ericboxer/KiCad---BoxLib/readme_assests/pinLabelExample.png

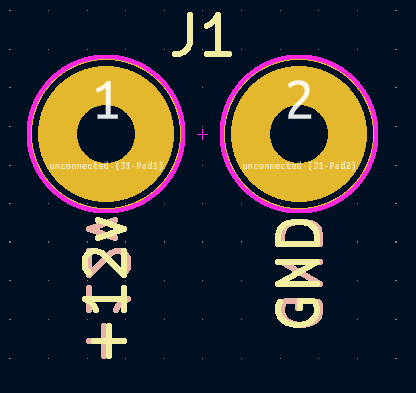
readme_assests/pinLabelExample.png
