ericboxer/KiCad---BoxLib/readme_assests/symbolLabelExample.png

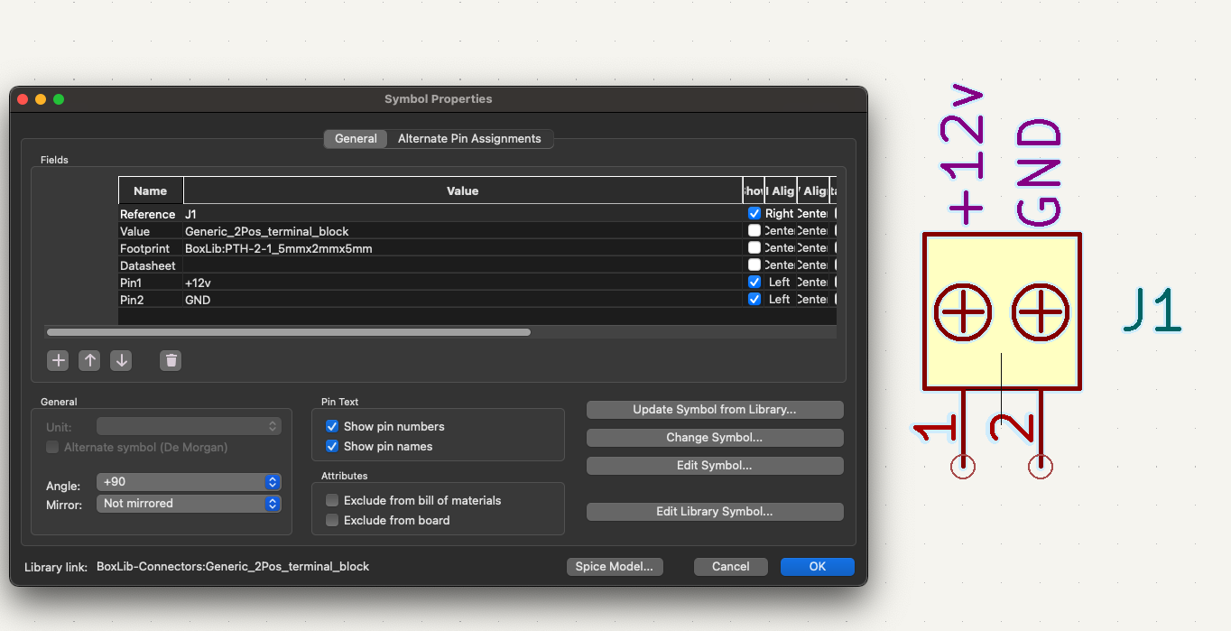
readme_assests/symbolLabelExample.png
