ericboxer/KiCad---BoxLib/3D Models/GCT-BD125-10-A-0305-0580-L-B.STEP

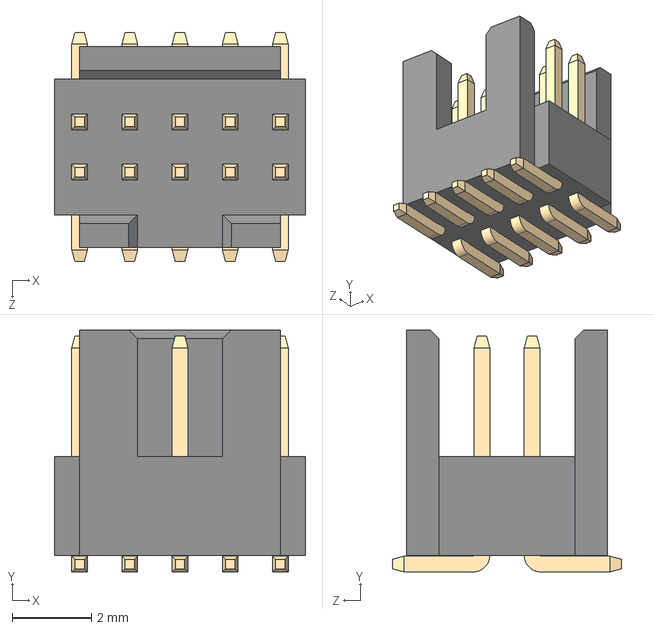
[picture p3: CAD file, 2025-07-31]
3D Models/GCT-BD125-10-A-0305-0580-L-B.STEP
6.35 x 6.12 x 5.80 mm
