ericboxer/KiCad---BoxLib/3D Models/LED-QBLP600_BI_TRI.step

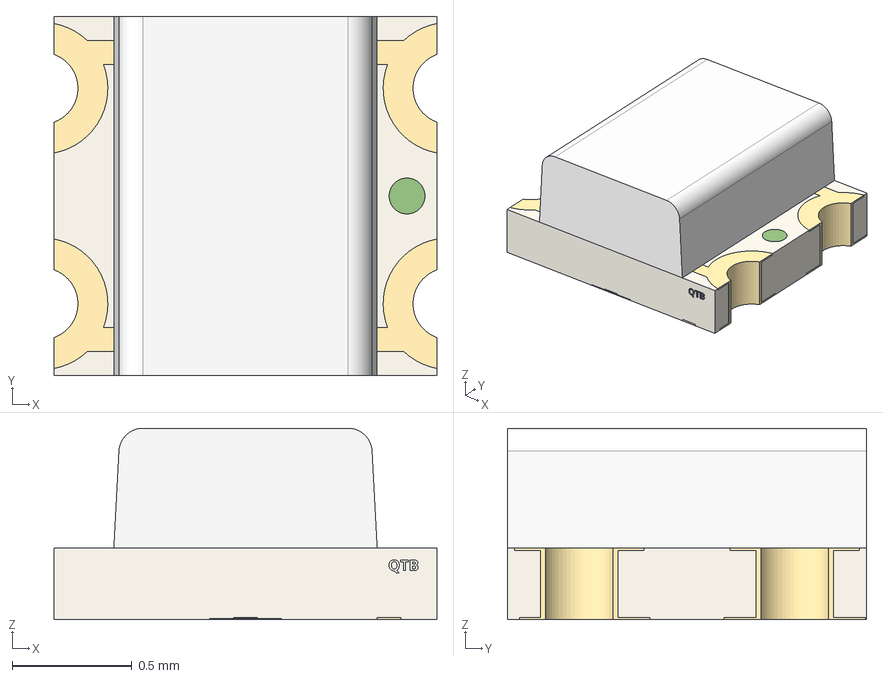
[picture p4: CAD file, 2025-06-26]
3D Models/LED-QBLP600_BI_TRI.step
1.60 x 1.50 x 0.8 mm
Resin
Pad 2b
Substrate
Polarity Mark
Pad 2a
Pad 1b
Bottom Polarity Mark
Pad 1a
