ericboxer/KiCad---BoxLib/3D Models/VL53L5 Exclusion cones.step

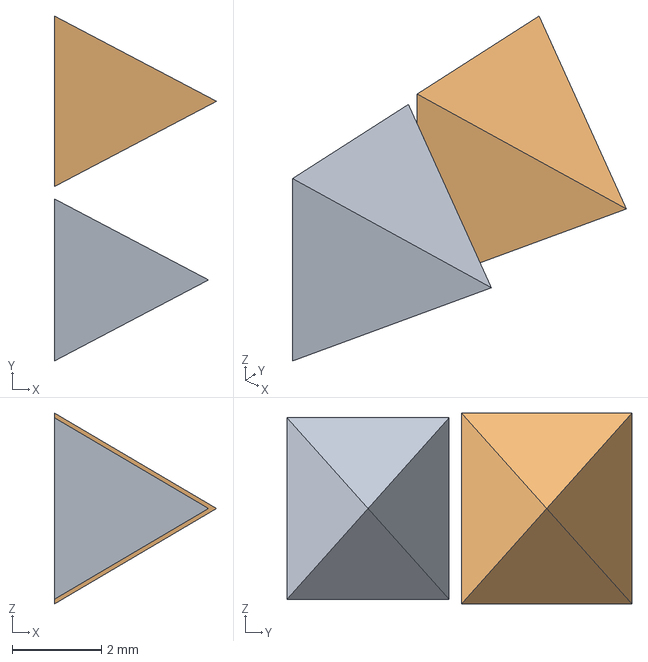
[picture p5: CAD file, 2025-06-26]
3D Models/VL53L5 Exclusion cones.step
3.63 x 7.72 x 4.28 mm
