ericboxer/KiCad---BoxLib/3D Models/VL53L5.step

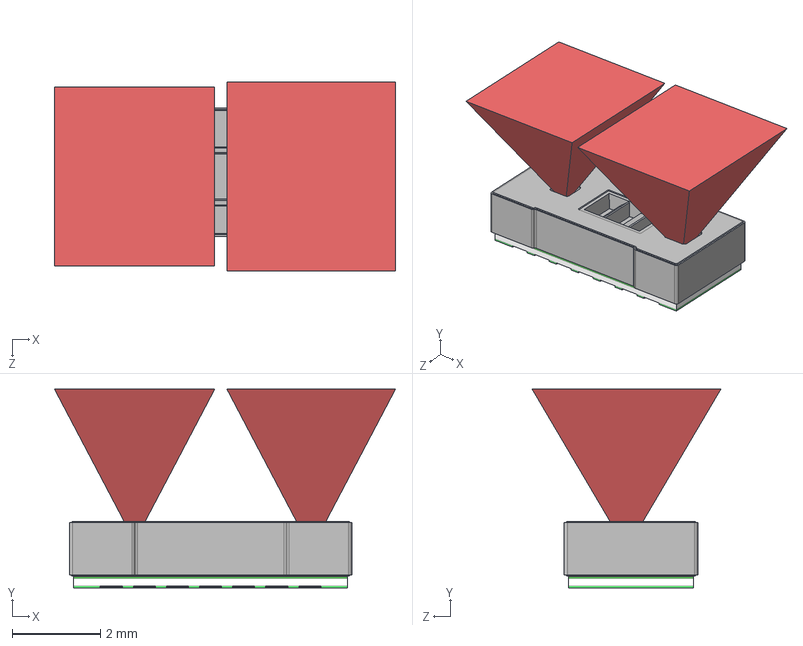
[picture p6: CAD file, 2025-06-26]
3D Models/VL53L5.step
7.72 x 4.50 x 4.28 mm
VL53L5 Module
VL53L5 Exclusion cones
