ericboxer/KiCad---BoxLib/3D Models/littelfuse_448.STEP

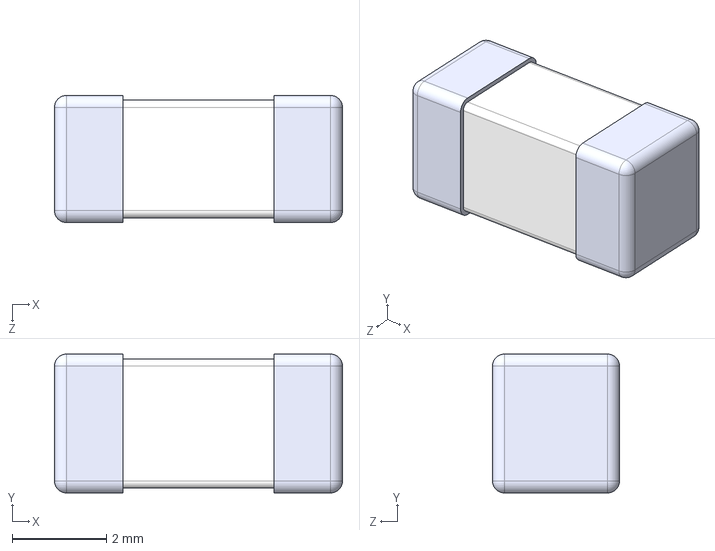
[picture p7: CAD file, 2025-06-26]
3D Models/littelfuse_448.STEP
6.10 x 2.94 x 2.69 mm
