ericboxer/KiCad---BoxLib/3D Models/vcnl3040.step

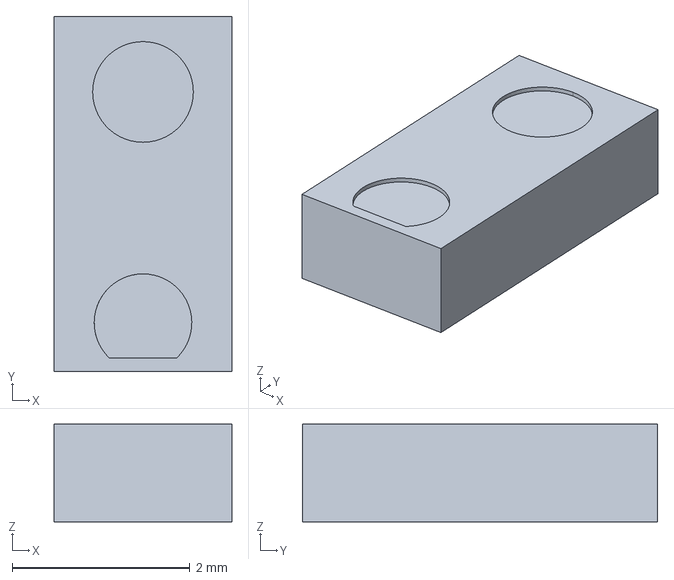
[picture p8: CAD file, 2025-06-26]
3D Models/vcnl3040.step
2.00 x 4.00 x 1.10 mm
