ericboxer/KiCad---BoxLib/3D Models/uqfn-10-06mmpitch.STEP

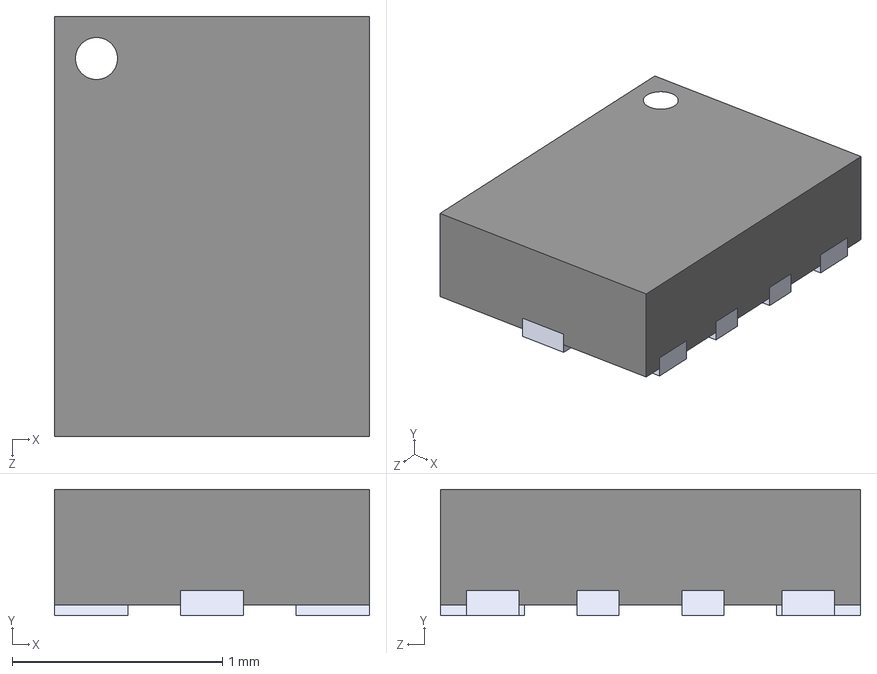
[picture p9: CAD file, 2025-06-26]
3D Models/uqfn-10-06mmpitch.STEP
1.50 x 0.6 x 2.00 mm
