ericboxer/KiCad---BoxLib/3D Models/VL53L5 Module.step

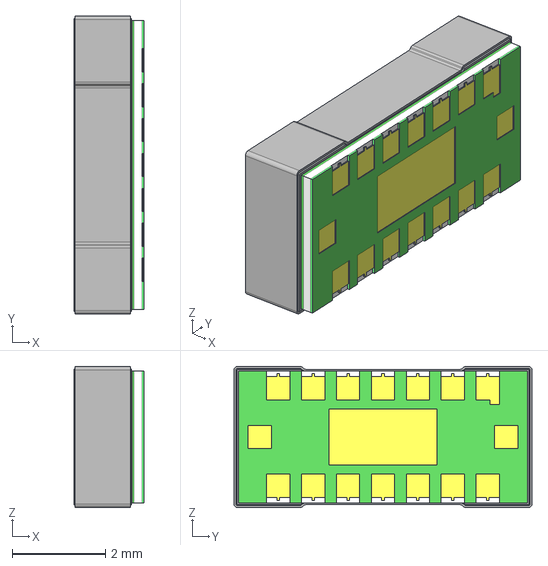
[picture p10: CAD file, 2025-06-26]
3D Models/VL53L5 Module.step
1.50 x 6.40 x 3.03 mm
