ericboxer/KiCad---BoxLib/3D Models/inductor 0805.STEP

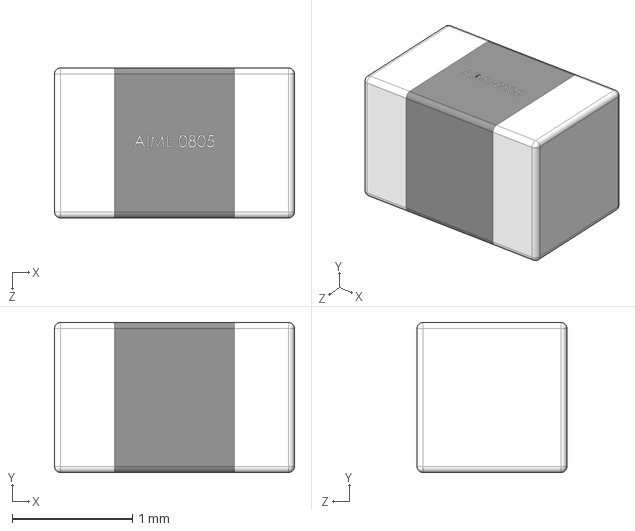
[picture p11: CAD file, 2025-06-26]
3D Models/inductor 0805.STEP
2.00 x 1.25 x 1.25 mm
