ericboxer/KiCad---BoxLib/3D Models/GCT-usb4145-03-0230-c.stp

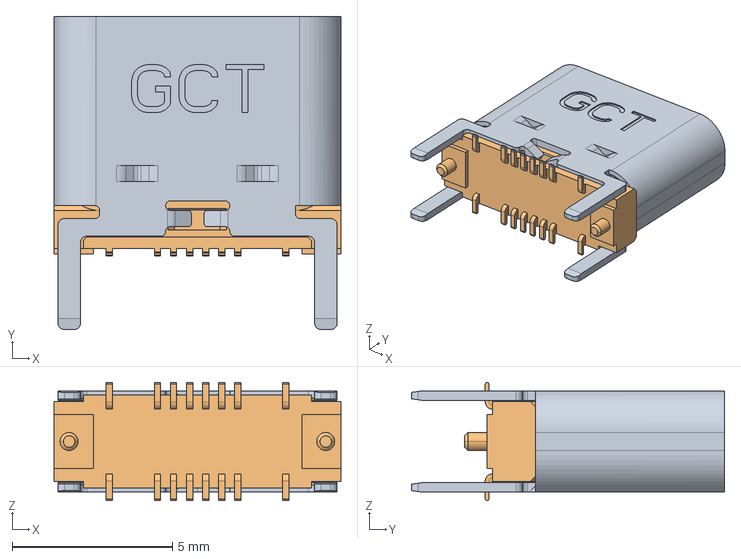
[picture p12: CAD file, 2025-06-26]
3D Models/GCT-usb4145-03-0230-c.stp
8.95 x 9.76 x 3.69 mm
