ericboxer/KiCad---BoxLib/3D Models/ic-ufdn 10 1x25.STEP

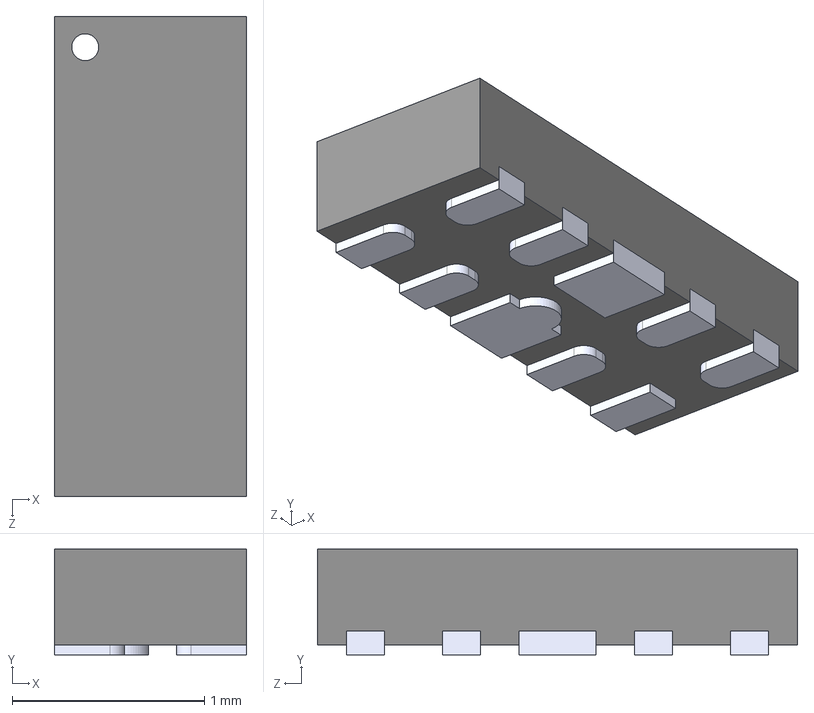
[picture p13: CAD file, 2025-06-26]
3D Models/ic-ufdn 10 1x25.STEP
1.00 x 0.55 x 2.50 mm
