ericboxer/KiCad---BoxLib/3D Models/UFDFPN8_DFN8_2X3_pad.step

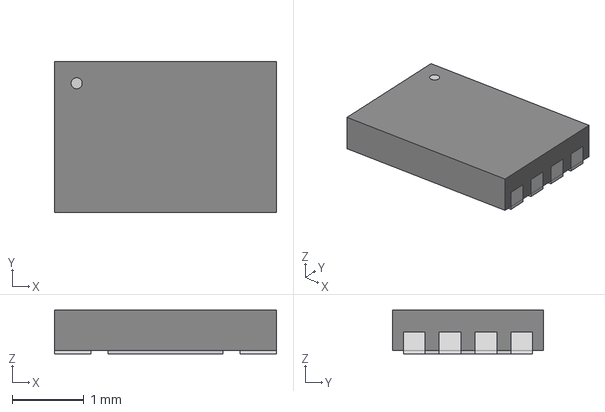
[picture p14: CAD file, 2025-06-26]
3D Models/UFDFPN8_DFN8_2X3_pad.step
3.10 x 2.11 x 0.612 mm
