ericboxer/KiCad---BoxLib/3D Models/IC-WQFN20-3mmx3mm Pad.step

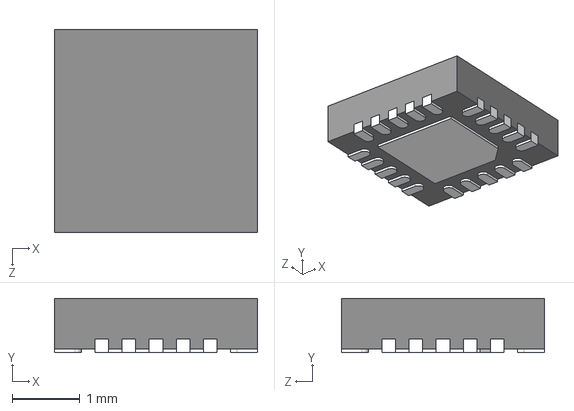
[picture p15: CAD file, 2025-06-26]
3D Models/IC-WQFN20-3mmx3mm Pad.step
3.00 x 0.8 x 3.00 mm
