ericboxer/KiCad---BoxLib/3D Models/BNO0xx.STEP

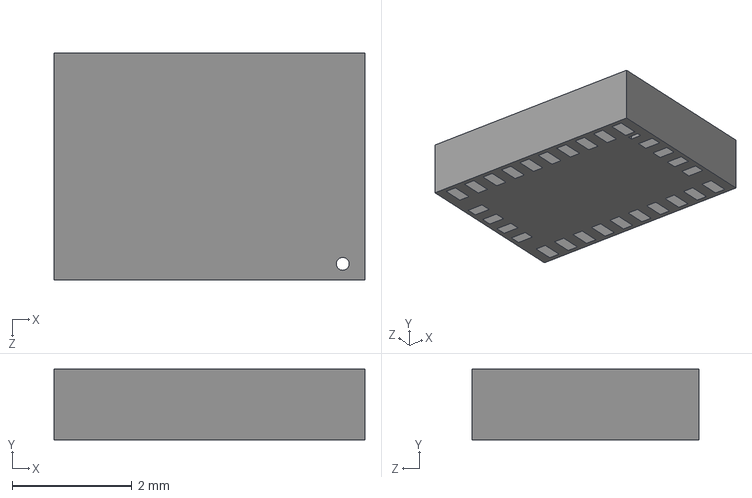
[picture p16: CAD file, 2025-06-15]
3D Models/BNO0xx.STEP
5.20 x 1.18 x 3.80 mm
