ericboxer/KiCad---BoxLib/3D Models/QFN-24_3x3.STEP

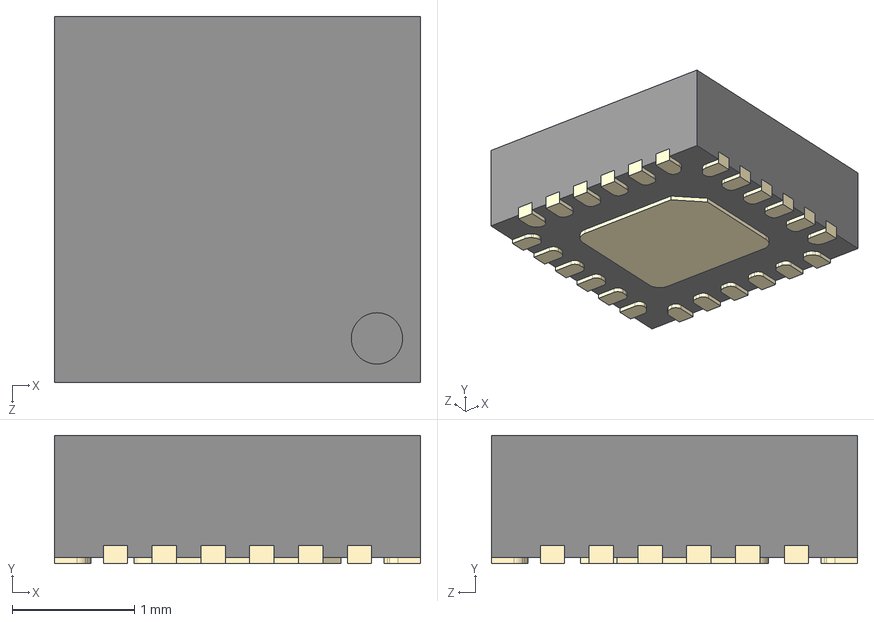
[picture p17: CAD file, 2025-06-15]
3D Models/QFN-24_3x3.STEP
3.00 x 1.05 x 3.00 mm
