ericboxer/KiCad---BoxLib/3D Models/molex 5051100692.stp

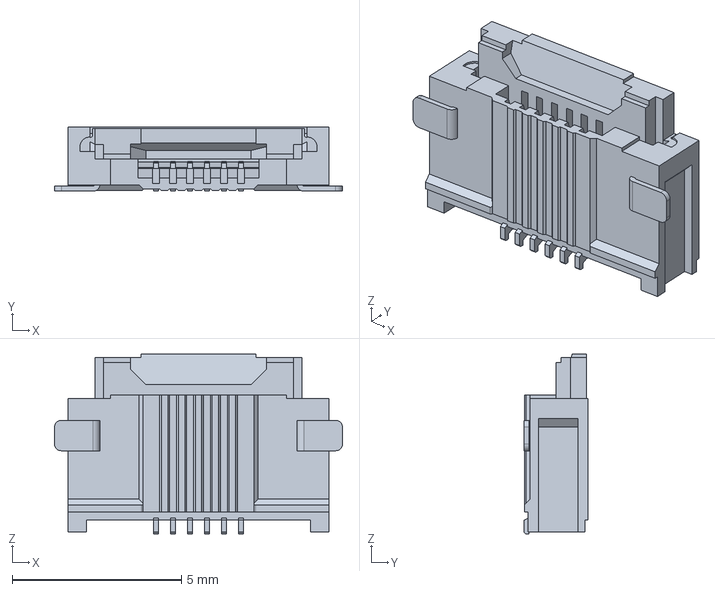
[picture p18: CAD file, 2025-06-10]
3D Models/molex 5051100692.stp
8.50 x 1.90 x 5.30 mm
