ericboxer/KiCad---BoxLib/3D Models/molex 5051100492.stp

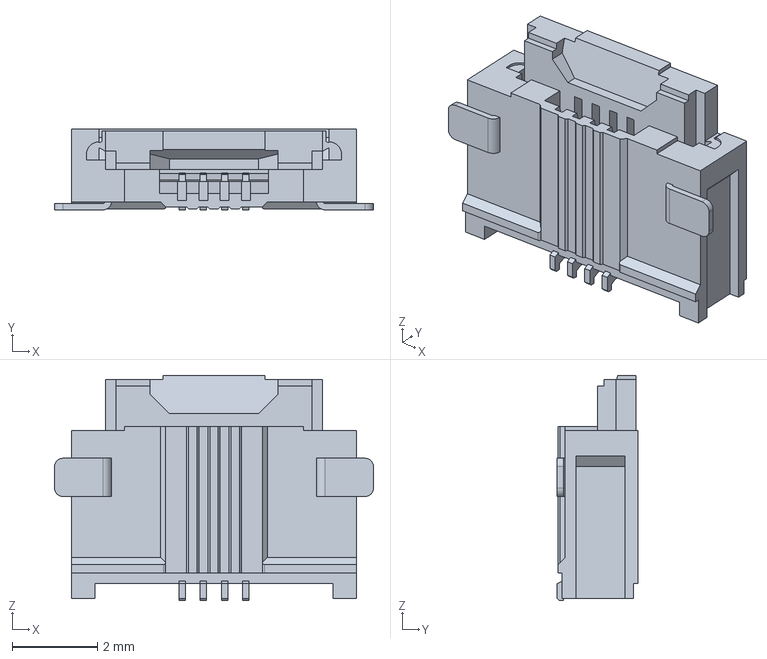
[picture p19: CAD file, 2025-06-10]
3D Models/molex 5051100492.stp
7.50 x 1.90 x 5.30 mm
