ericboxer/KiCad---BoxLib/3D Models/c-0805 polarized.step

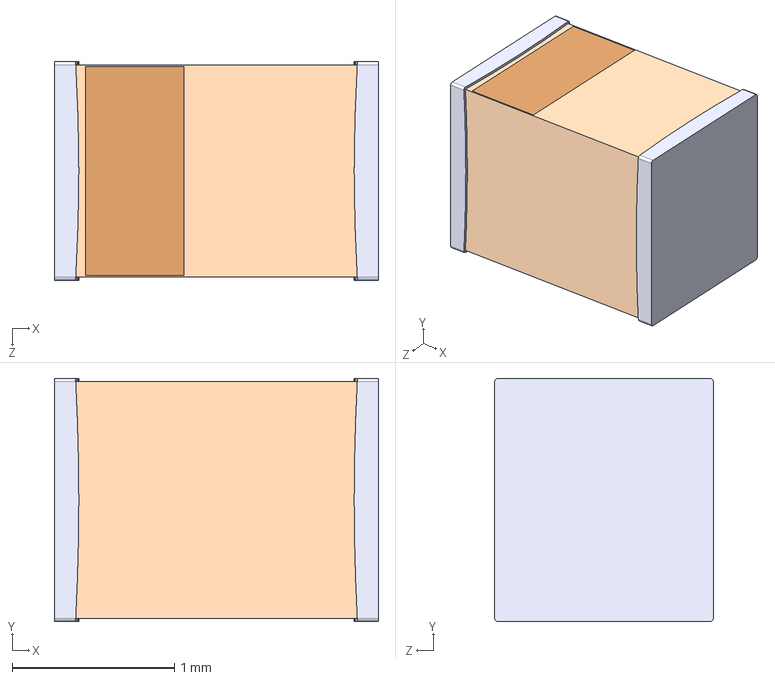
[picture p20: CAD file, 2025-06-10]
3D Models/c-0805 polarized.step
2.00 x 1.50 x 1.35 mm
