ericboxer/KiCad---BoxLib/3D Models/Box.step

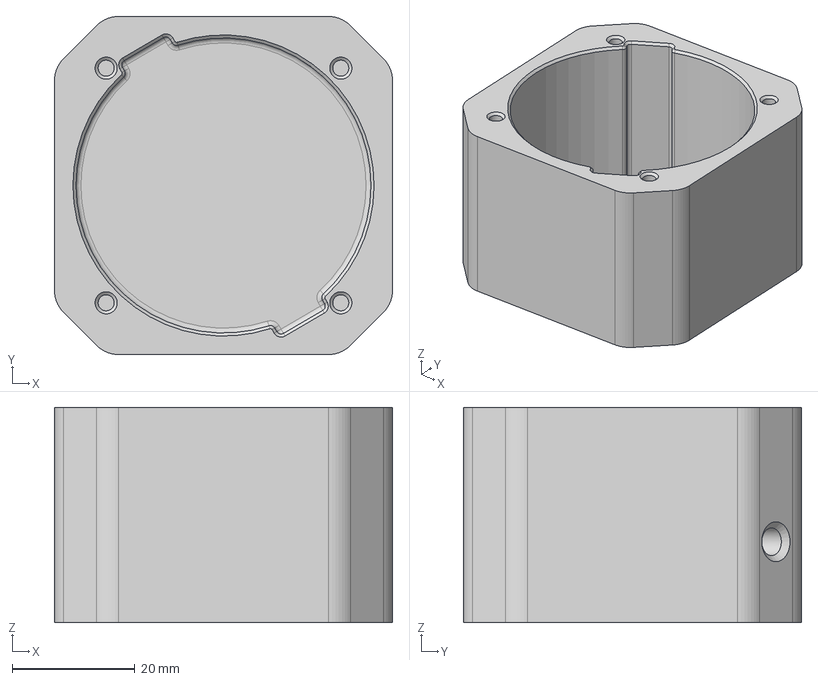
[picture p21: CAD file, 2025-06-10]
3D Models/Box.step
55.0 x 55.0 x 35.0 mm
