ericboxer/KiCad---BoxLib/3D Models/SK6812MINI-e v1.step

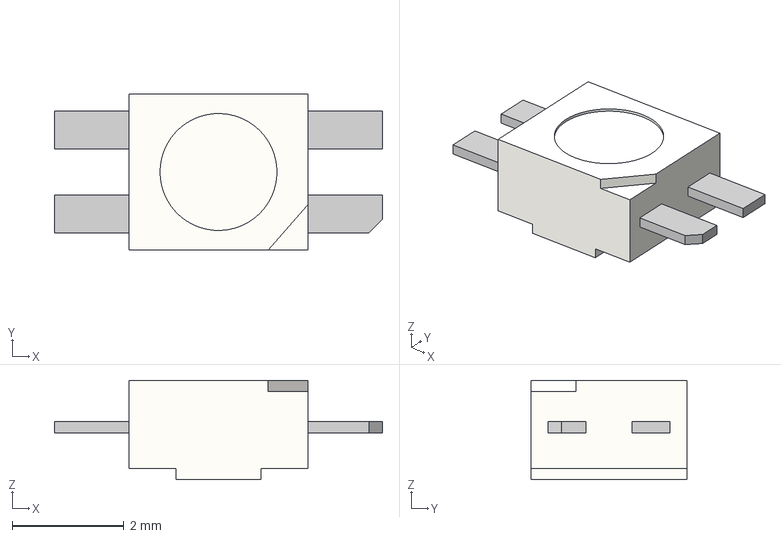
[picture p22: CAD file, 2025-06-10]
3D Models/SK6812MINI-e v1.step
5.88 x 2.80 x 1.78 mm
