ericboxer/KiCad---BoxLib/3D Models/ssop28_5.3mm.step

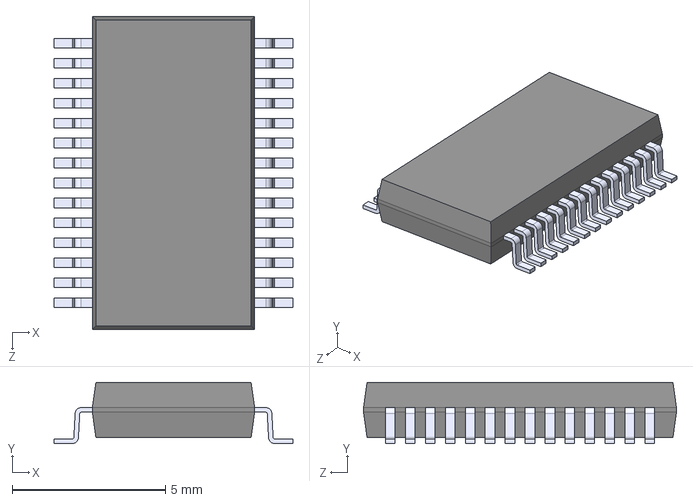
[picture p23: CAD file, 2024-11-20]
3D Models/ssop28_5.3mm.step
7.78 x 1.99 x 10.2 mm
