ericboxer/KiCad---BoxLib/3D Models/wurth-157102B12800.stp

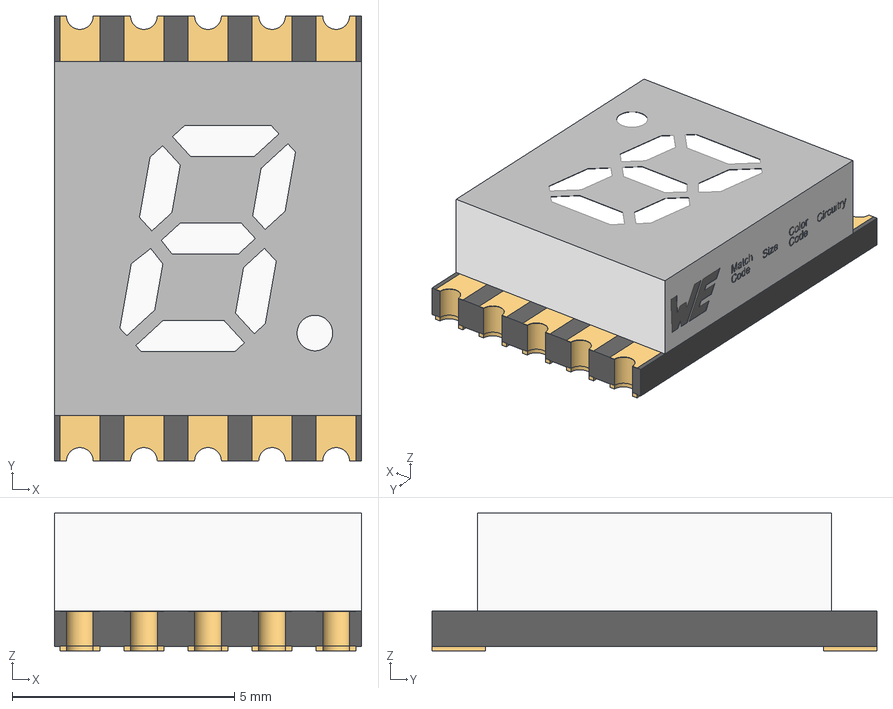
[picture p24: CAD file, 2024-11-20]
3D Models/wurth-157102B12800.stp
6.90 x 10.0 x 3.10 mm
PCB
Pins
Chip
