ericboxer/KiCad---BoxLib/3D Models/8-UFDFN-exposed_pad.step

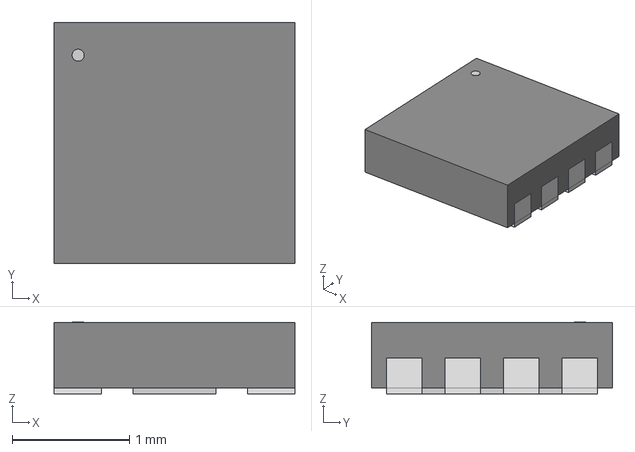
[picture p25: CAD file, 2024-11-18]
3D Models/8-UFDFN-exposed_pad.step
2.06 x 2.06 x 0.612 mm
