ericboxer/KiCad---BoxLib/3D Models/Kailh LP Choc Burnt Orange.STEP

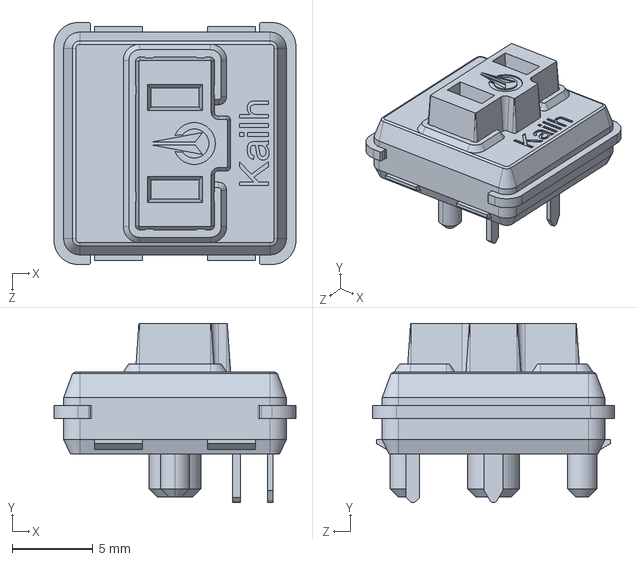
[picture p26: CAD file, 2024-11-18]
3D Models/Kailh LP Choc Burnt Orange.STEP
15.0 x 11.1 x 15.0 mm
