ericboxer/KiCad---BoxLib/3D Models/cherry_mx_PCB.stp

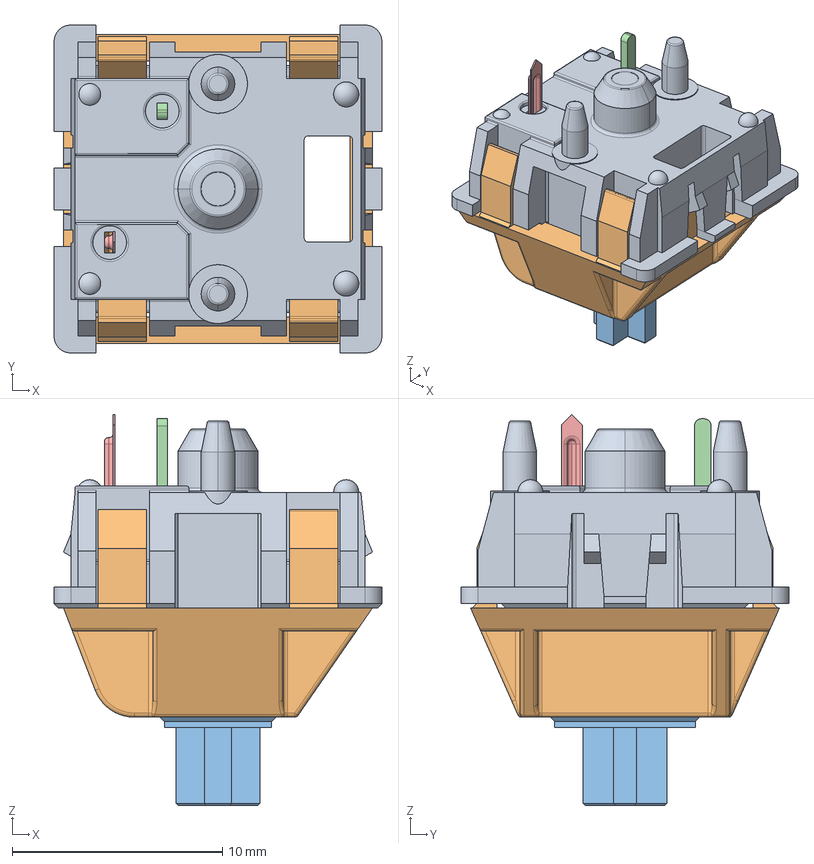
[picture p27: CAD file, 2024-11-18]
3D Models/cherry_mx_PCB.stp
15.6 x 15.6 x 18.6 mm
MX_DOWN
MX_UP
UP_MX
MX_PIN
MX_SPRING
MX_CLICK
