ericboxer/KiCad---BoxLib/3D Models/SSM-120-L-DV-LC-M-TR.stp

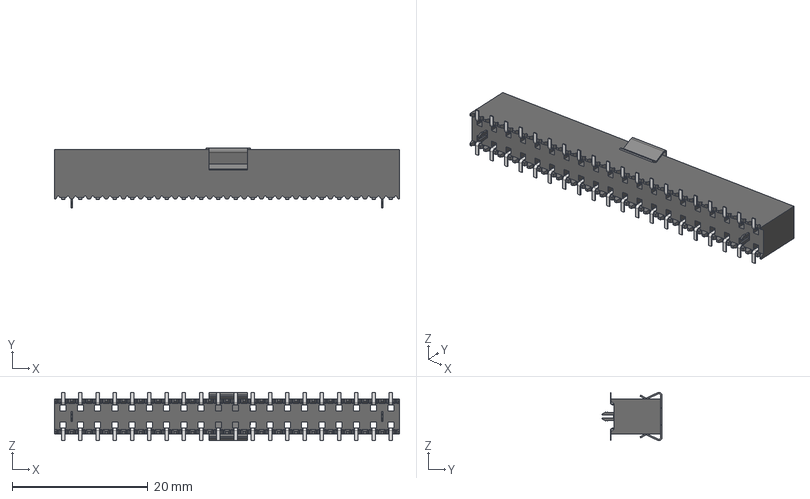
[picture p28: CAD file, 2024-10-29]
3D Models/SSM-120-L-DV-LC-M-TR.stp
50.8 x 8.84 x 7.11 mm
SSM-120-L-DV-LC-M-TR_body
C-137-01-L20
SSM_Metal_pad
