ericboxer/KiCad---BoxLib/3D Models/BCS-120-F-D-TE.stp

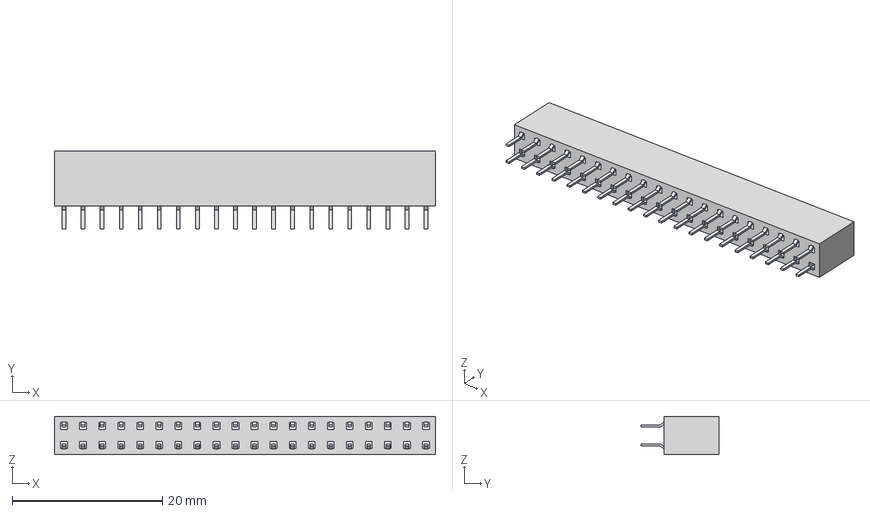
[picture p29: CAD file, 2024-10-29]
3D Models/BCS-120-F-D-TE.stp
50.8 x 10.5 x 5.08 mm
BCS-120-D-TE_socket
C-95-01-20-F-D-TE
C-95-01-20-F-D-TE2
