ericboxer/KiCad---BoxLib/3D Models/WFQFN-28-4x5.step

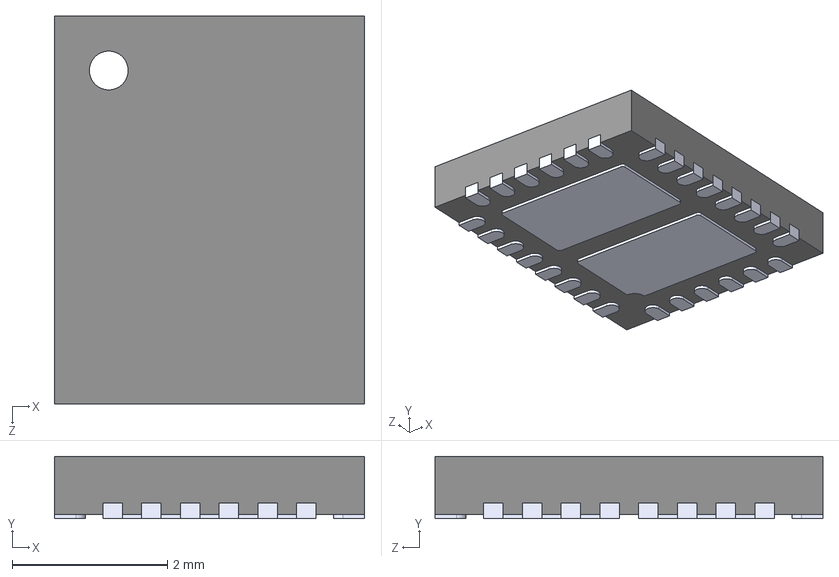
[picture p30: CAD file, 2024-10-27]
3D Models/WFQFN-28-4x5.step
4.00 x 0.8 x 5.00 mm
