ericboxer/KiCad---BoxLib/3D Models/LGA-14L.step

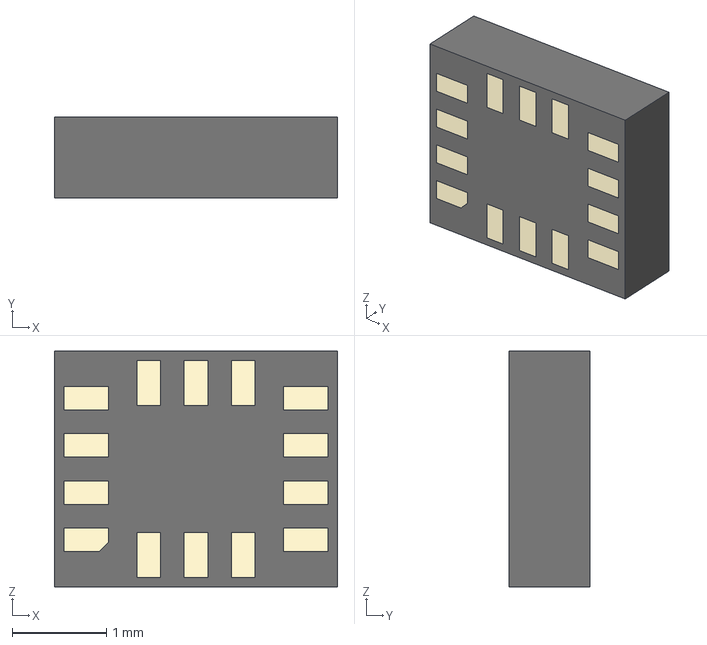
[picture p31: CAD file, 2024-08-22]
3D Models/LGA-14L.step
3.00 x 0.86 x 2.50 mm
