ericboxer/KiCad---BoxLib/3D Models/pxc_1952306.stp

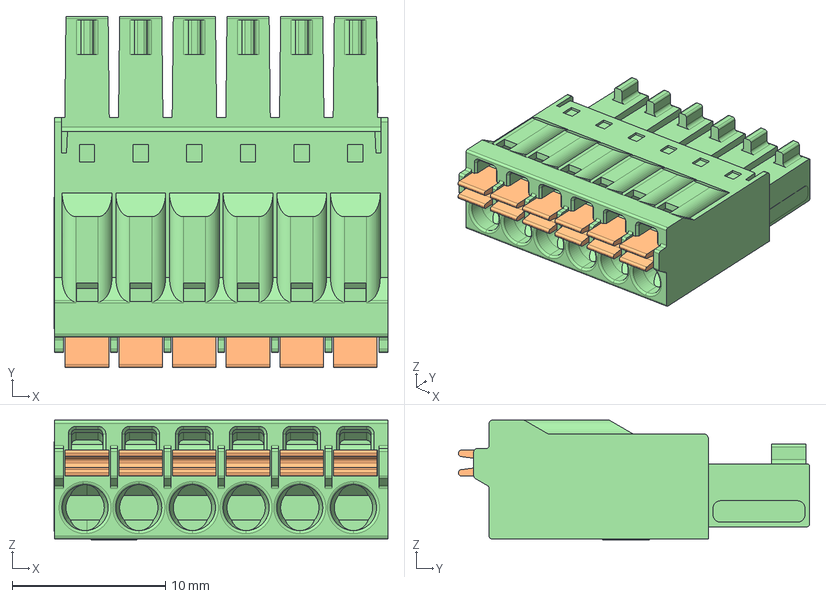
[picture p32: CAD file, 2024-08-18]
3D Models/pxc_1952306.stp
21.8 x 22.9 x 7.80 mm
