ericboxer/KiCad---BoxLib/3D Models/pxc_1803293.stp

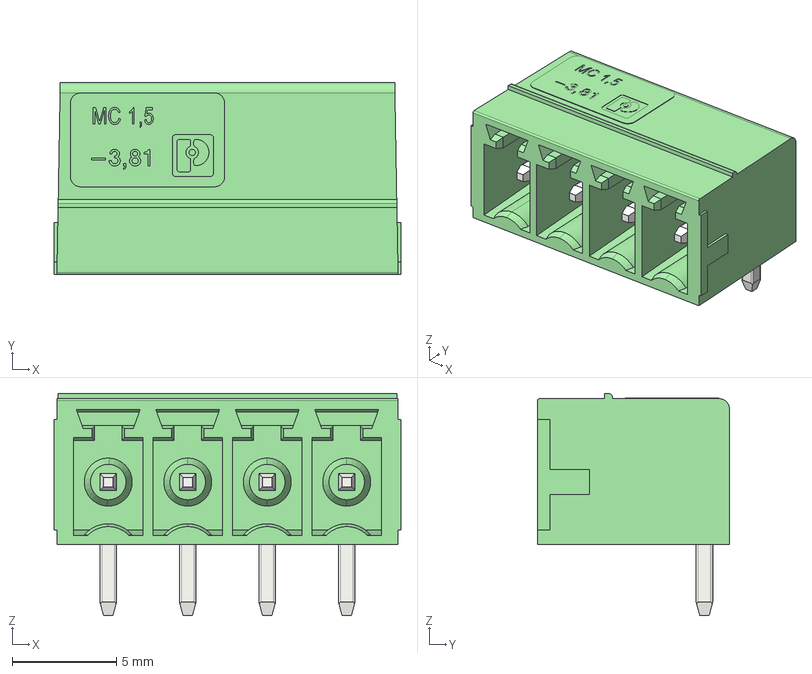
[picture p33: CAD file, 2024-08-18]
3D Models/pxc_1803293.stp
16.6 x 9.20 x 10.7 mm
