ericboxer/KiCad---BoxLib/3D Models/pxc_1910377.stp

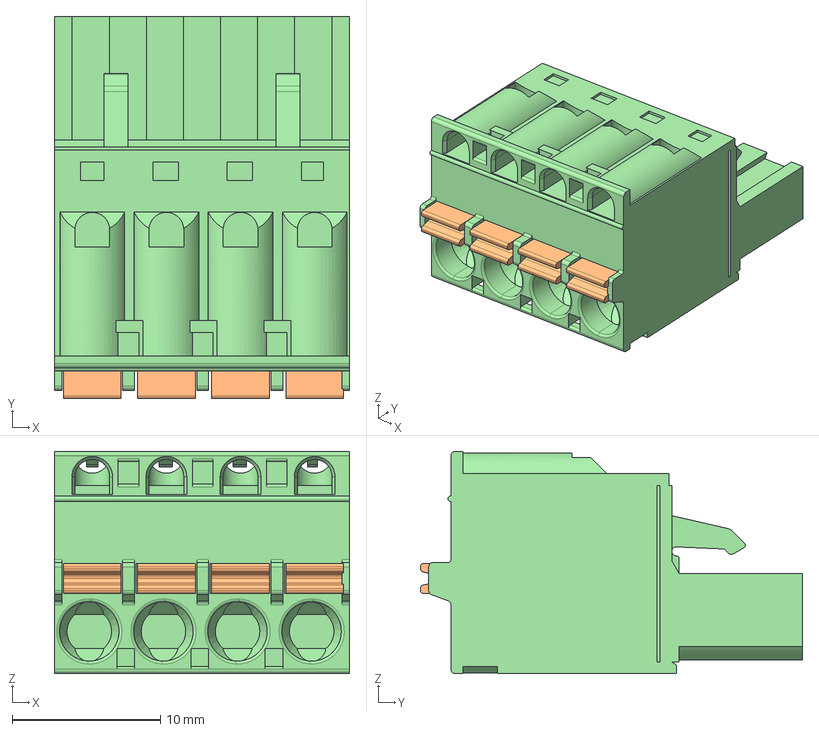
[picture p34: CAD file, 2024-08-18]
3D Models/pxc_1910377.stp
19.9 x 25.8 x 15.0 mm
