ericboxer/KiCad---BoxLib/3D Models/pxc_1788521.stp

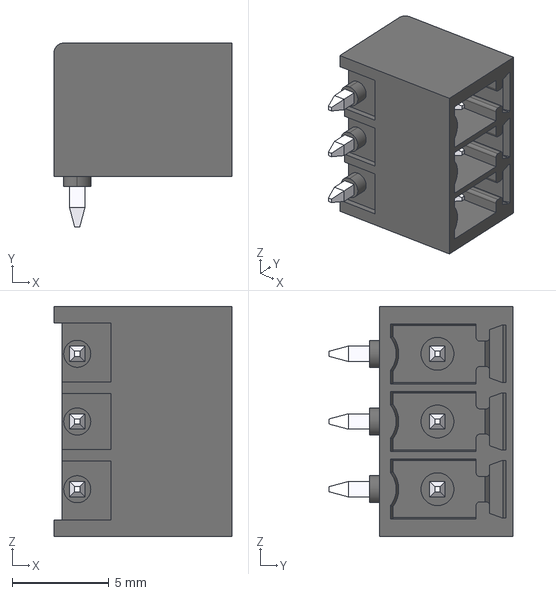
[picture p35: CAD file, 2024-08-18]
3D Models/pxc_1788521.stp
9.20 x 9.50 x 11.9 mm
