ericboxer/KiCad---BoxLib/3D Models/pxc-1952283.stp

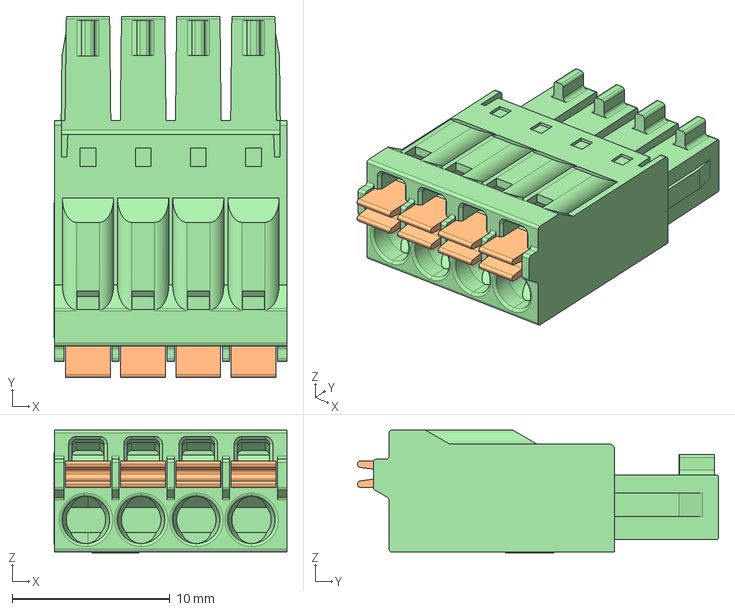
[picture p36: CAD file, 2024-08-18]
3D Models/pxc-1952283.stp
14.8 x 22.9 x 7.80 mm
