ericboxer/KiCad---BoxLib/3D Models/pxc_1757491.stp

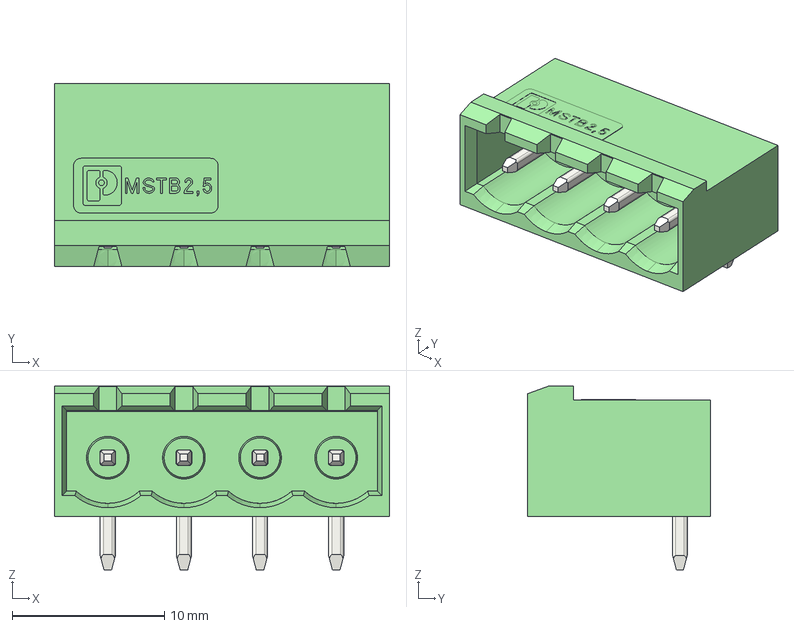
[picture p37: CAD file, 2024-08-18]
3D Models/pxc_1757491.stp
22.0 x 12.0 x 12.1 mm
