ericboxer/KiCad---BoxLib/3D Models/pxc_1788547.stp

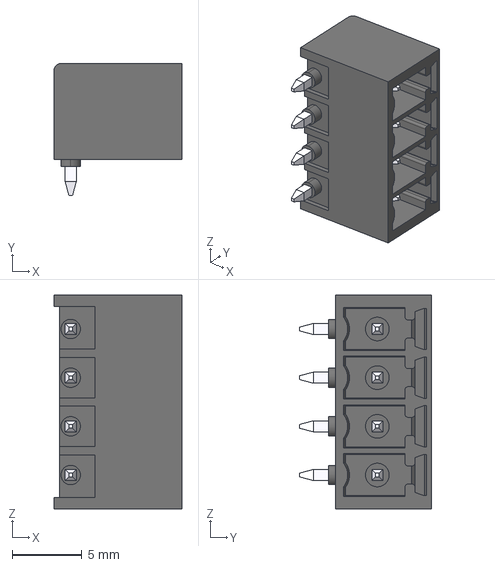
[picture p38: CAD file, 2024-08-18]
3D Models/pxc_1788547.stp
9.20 x 9.50 x 15.4 mm
