ericboxer/KiCad---BoxLib/3D Models/pxc_1788589.stp

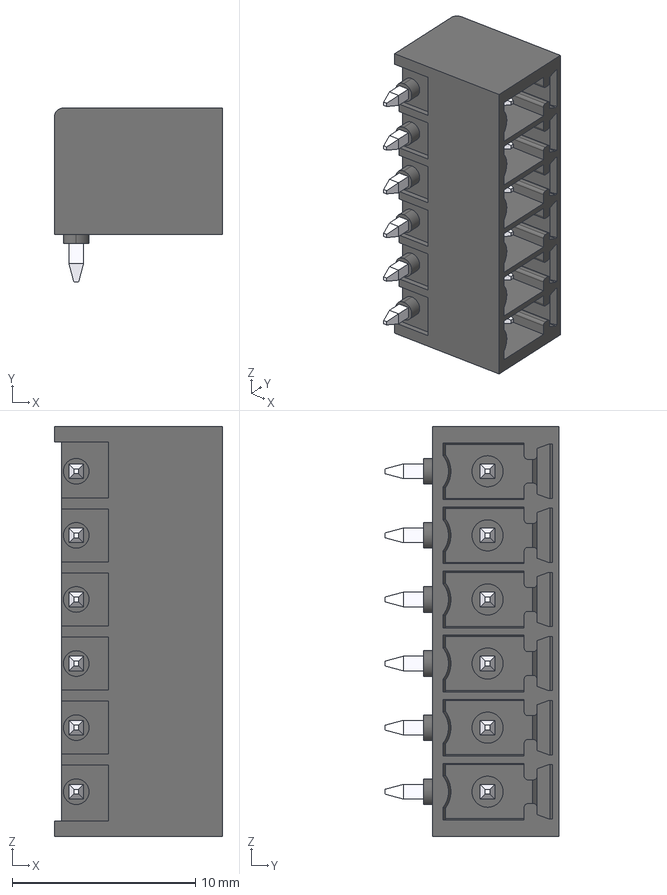
[picture p39: CAD file, 2024-08-18]
3D Models/pxc_1788589.stp
9.20 x 9.50 x 22.4 mm
