ericboxer/KiCad---BoxLib/3D Models/B4B-EH-A.STEP

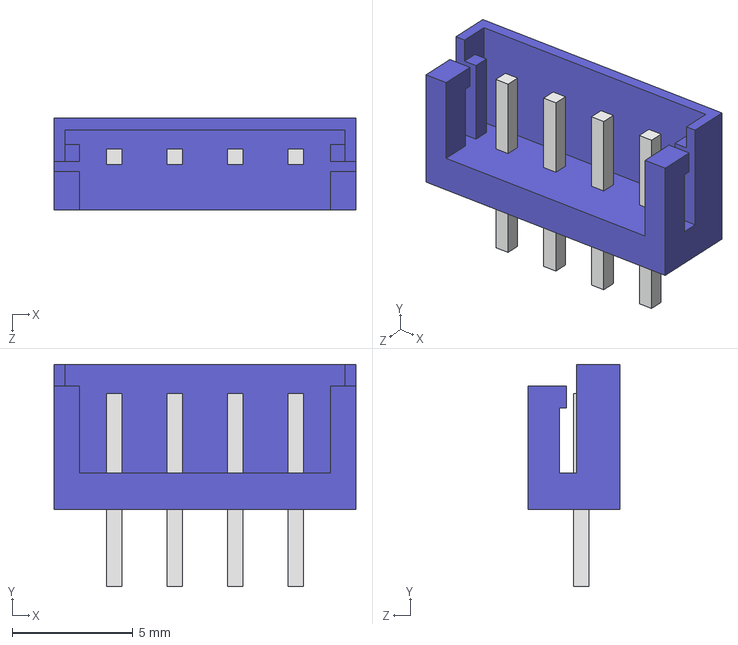
[picture p40: CAD file, 2023-05-15]
3D Models/B4B-EH-A.STEP
12.5 x 9.20 x 3.80 mm
