ericboxer/KiCad---BoxLib/3D Models/JST-S4B-EH.STEP

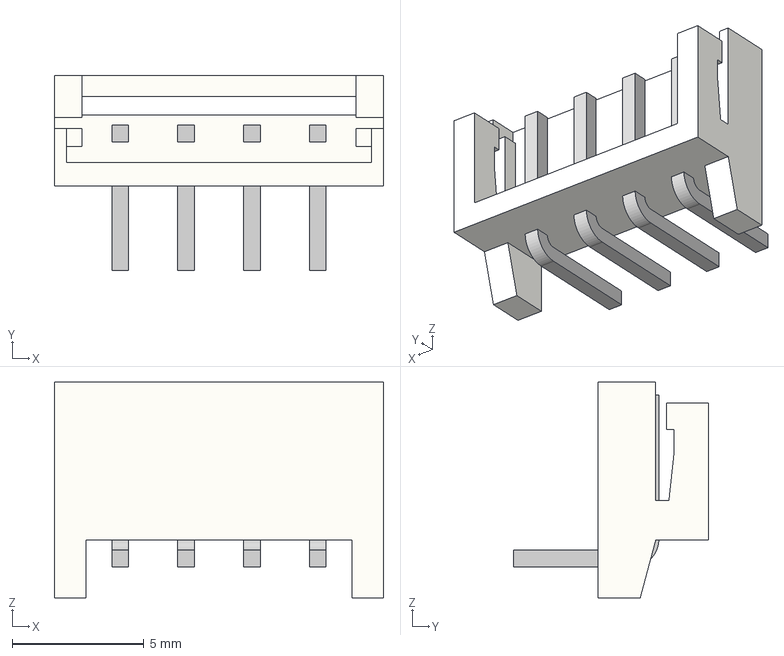
[picture p41: CAD file, 2023-05-15]
3D Models/JST-S4B-EH.STEP
12.5 x 7.40 x 8.20 mm
