ericboxer/KiCad---BoxLib/3D Models/JST-B4B-EH-A.STEP

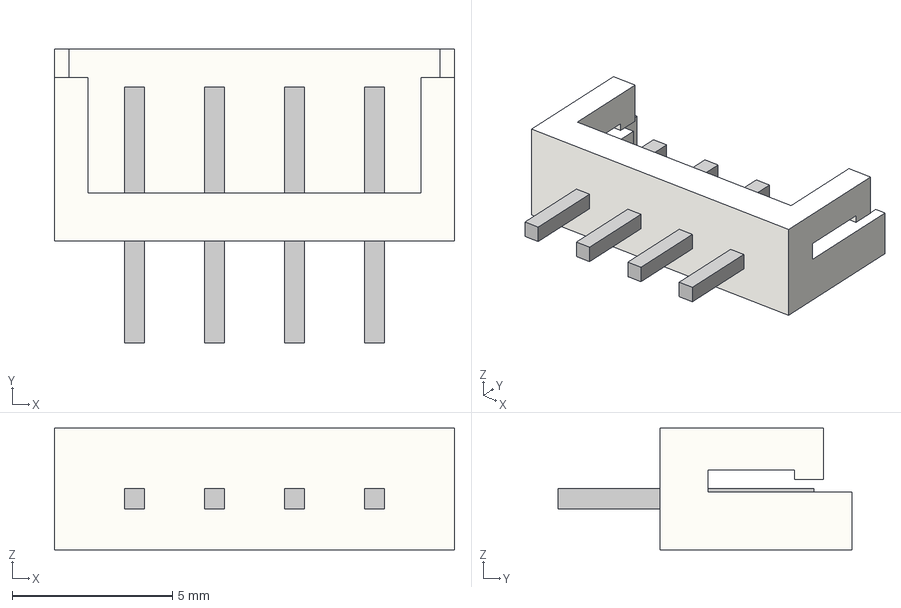
[picture p42: CAD file, 2023-05-15]
3D Models/JST-B4B-EH-A.STEP
12.5 x 9.20 x 3.80 mm
