ericboxer/KiCad---BoxLib/3D Models/wurth-691210910003.stp

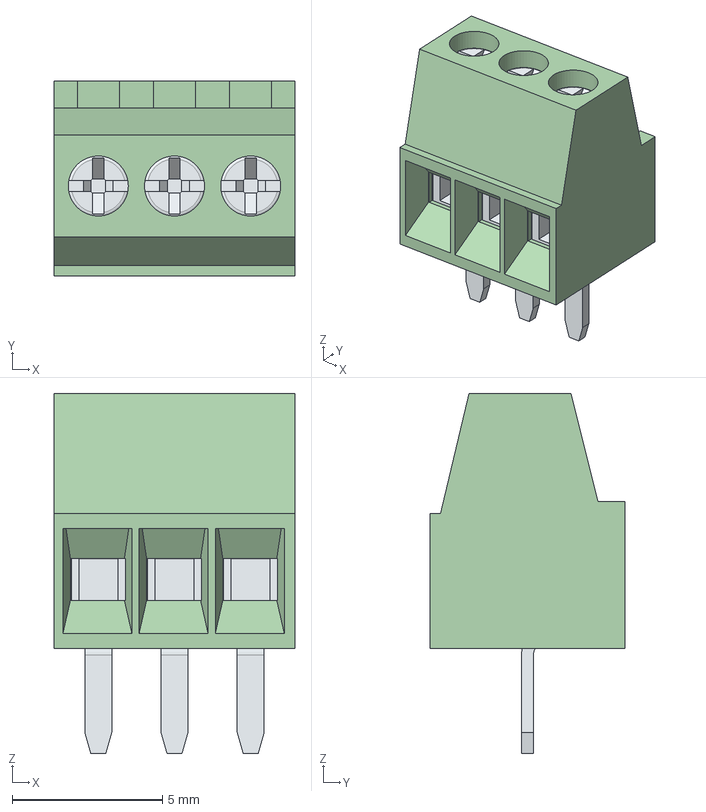
[picture p43: CAD file, 2023-01-16]
3D Models/wurth-691210910003.stp
8.02 x 6.50 x 12.0 mm
6912109100xx_CAGE x 3
6912109100xx_PIN x 3
6912109100xx_VIS x 3
