ericboxer/KiCad---BoxLib/3D Models/wurth-691210910002.stp

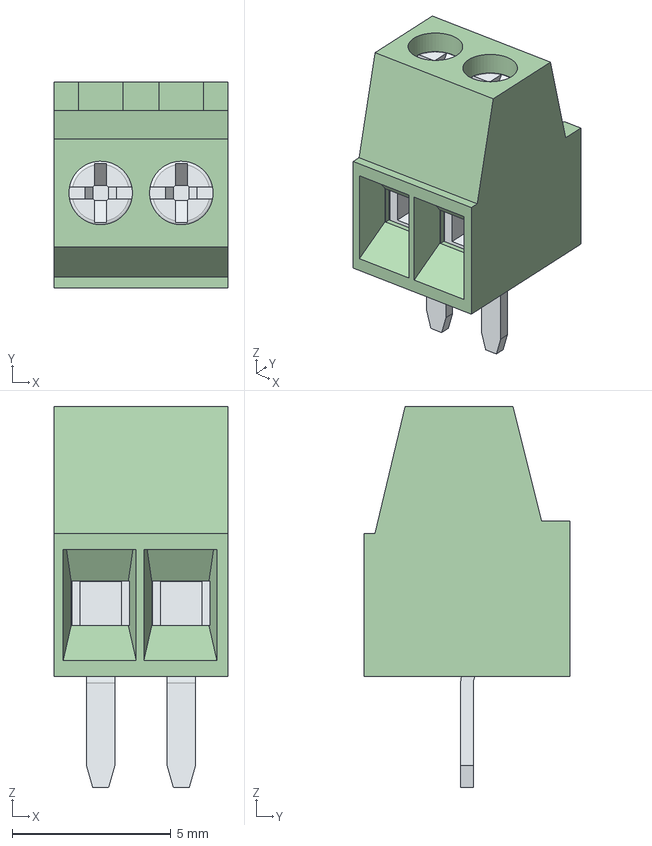
[picture p44: CAD file, 2023-01-16]
3D Models/wurth-691210910002.stp
5.48 x 6.50 x 12.0 mm
6912109100xx_CAGE x 2
6912109100xx_PIN x 2
6912109100xx_VIS x 2
