ericboxer/KiCad---BoxLib/3D Models/cap-K21.stp

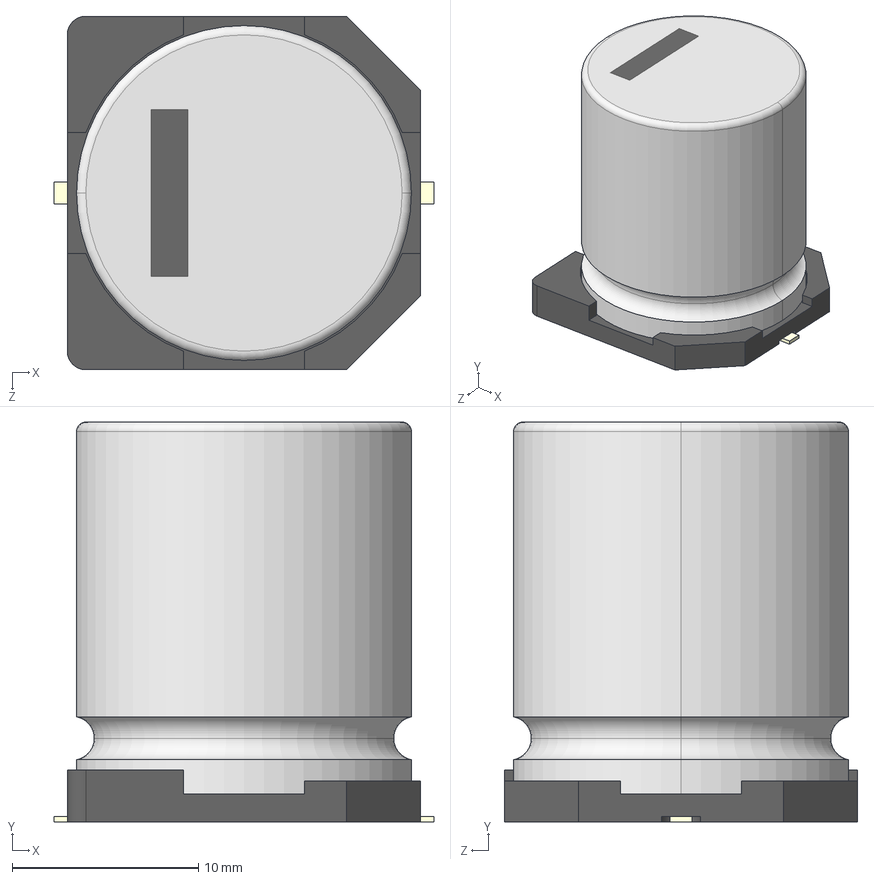
[picture p45: CAD file, 2023-01-15]
3D Models/cap-K21.stp
20.4 x 21.5 x 19.0 mm
標準SIZE CODE K21-001
標準SIZE CODE K21-002
標準SIZE CODE K21-003 x 2
