ericboxer/KiCad---BoxLib/3D Models/RB1-125BAG1A.STEP

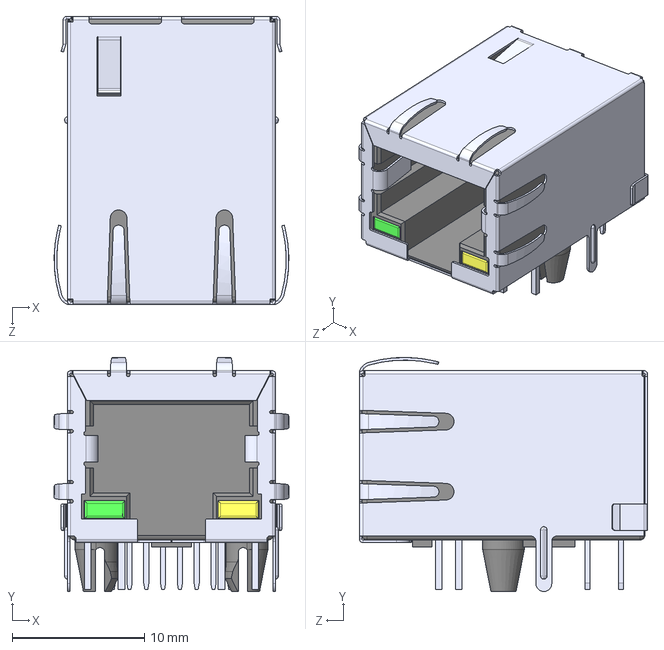
[picture p46: CAD file, 2023-01-15]
3D Models/RB1-125BAG1A.STEP
17.7 x 17.7 x 21.8 mm
