ericboxer/KiCad---BoxLib/3D Models/pxc_1827907_08_MC-1-5-6-GF-3-81_3D.stp

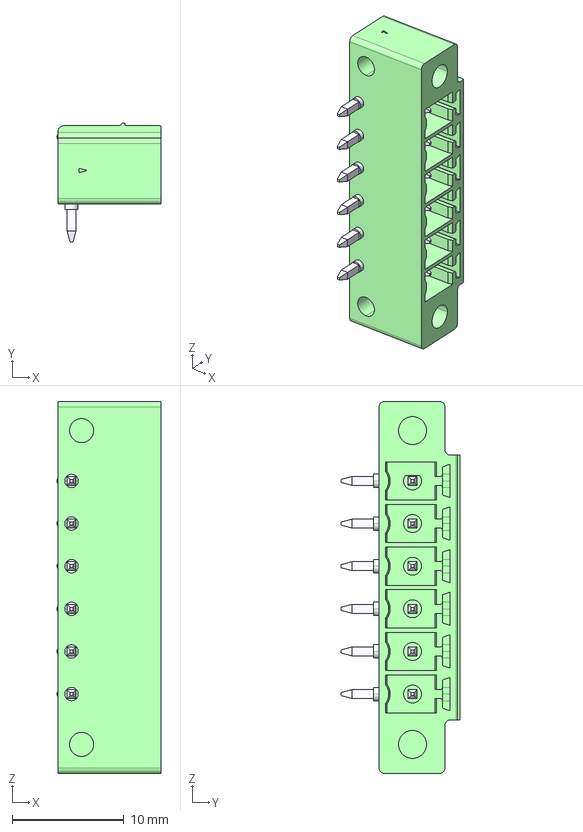
[picture p47: CAD file, 2023-01-15]
3D Models/pxc_1827907_08_MC-1-5-6-GF-3-81_3D.stp
9.30 x 10.7 x 33.2 mm
