ericboxer/KiCad---BoxLib/3D Models/ASE-xxxxMHZ-ET.STEP

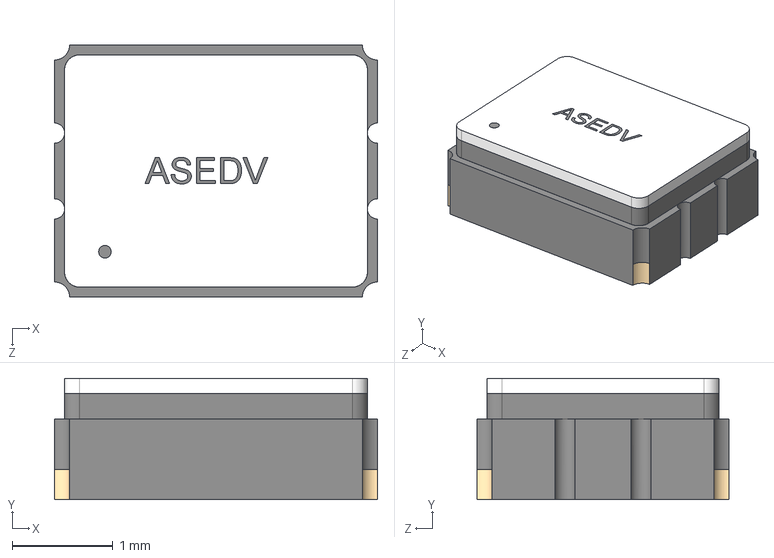
[picture p48: CAD file, 2023-01-15]
3D Models/ASE-xxxxMHZ-ET.STEP
3.20 x 1.20 x 2.50 mm
