ericboxer/KiCad---BoxLib/3D Models/WIZNET_W5500.step

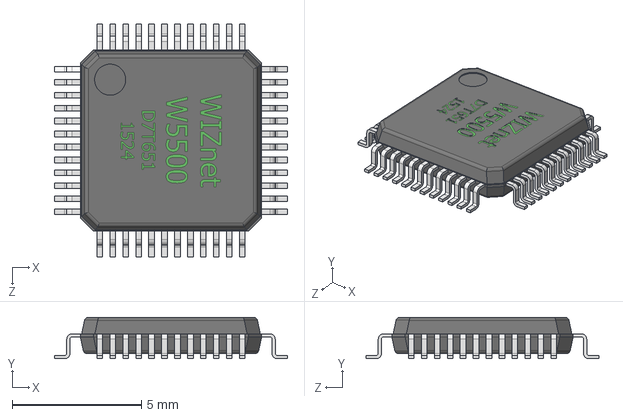
[picture p49: CAD file, 2023-01-15]
3D Models/WIZNET_W5500.step
9.00 x 1.60 x 9.00 mm
