ericboxer/KiCad---BoxLib/3D Models/TSM-103-01-G-SV-P-TR.stp

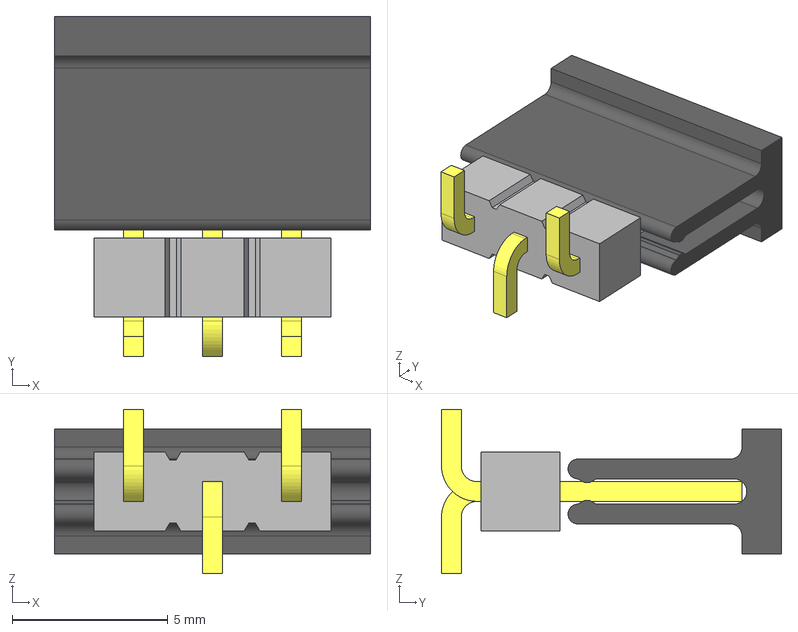
[picture p50: CAD file, 2023-01-15]
3D Models/TSM-103-01-G-SV-P-TR.stp
10.2 x 10.9 x 5.28 mm
T-1S6-16(-01-3-SV)
PPP-07-01-3--SV
TSM-103-01-SV_body
