ericboxer/KiCad---BoxLib/3D Models/cap-K21-V.stp

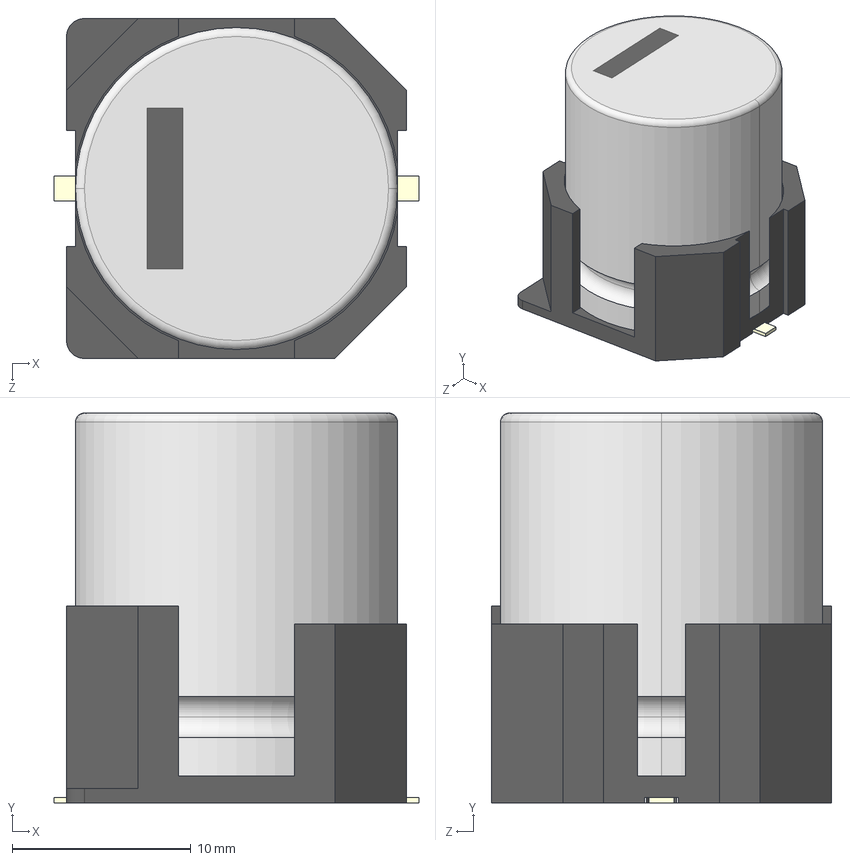
[picture p51: CAD file, 2023-01-15]
3D Models/cap-K21-V.stp
20.4 x 21.8 x 19.0 mm
SIZE CODE K21-001
SIZE CODE K21-002
SIZE CODE K21-003 x 2
SIZE CODE K21-004 x 2
