ericboxer/KiCad---BoxLib/3D Models/171-025-113.STEP

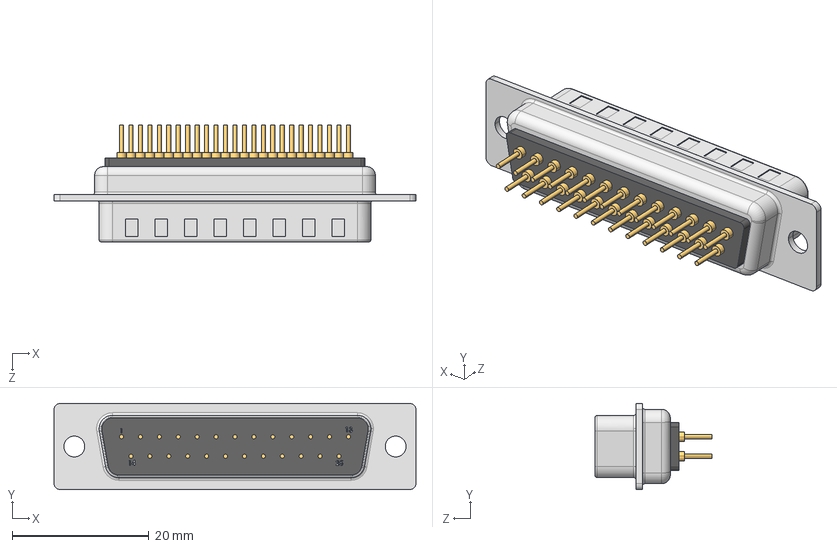
[picture p52: CAD file, 2023-01-15]
3D Models/171-025-113.STEP
53.0 x 12.6 x 17.1 mm
