ericboxer/KiCad---BoxLib/3D Models/CAPC-0402.stp

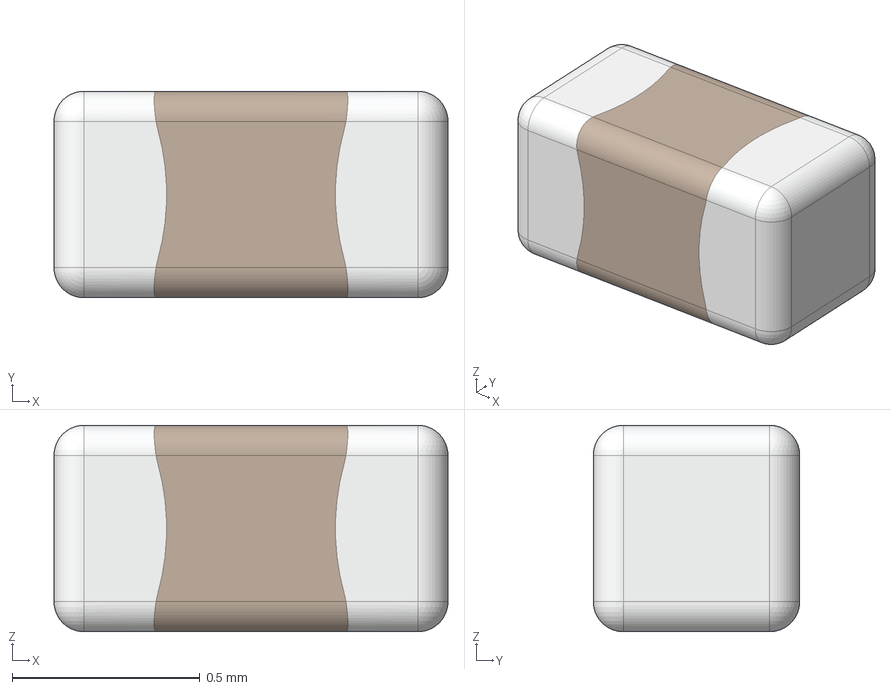
[picture p53: CAD file, 2022-12-03]
3D Models/CAPC-0402.stp
1.05 x 0.55 x 0.55 mm
