ericboxer/KiCad---BoxLib/3D Models/Murata LQH5BPN Inductor.STEP

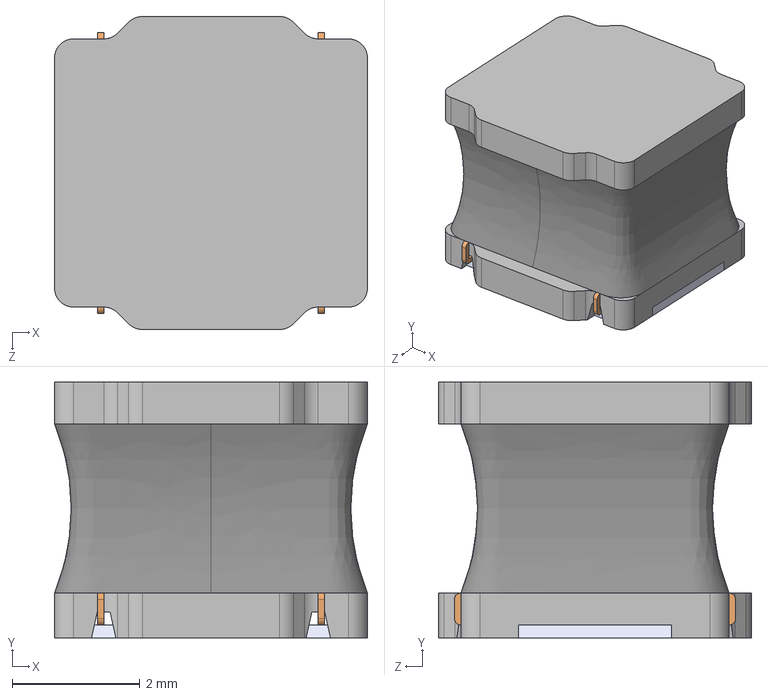
[picture p54: CAD file, 2022-12-03]
3D Models/Murata LQH5BPN Inductor.STEP
4.90 x 4.00 x 4.90 mm
