ericboxer/KiCad---BoxLib/3D Models/FPT705.STEP

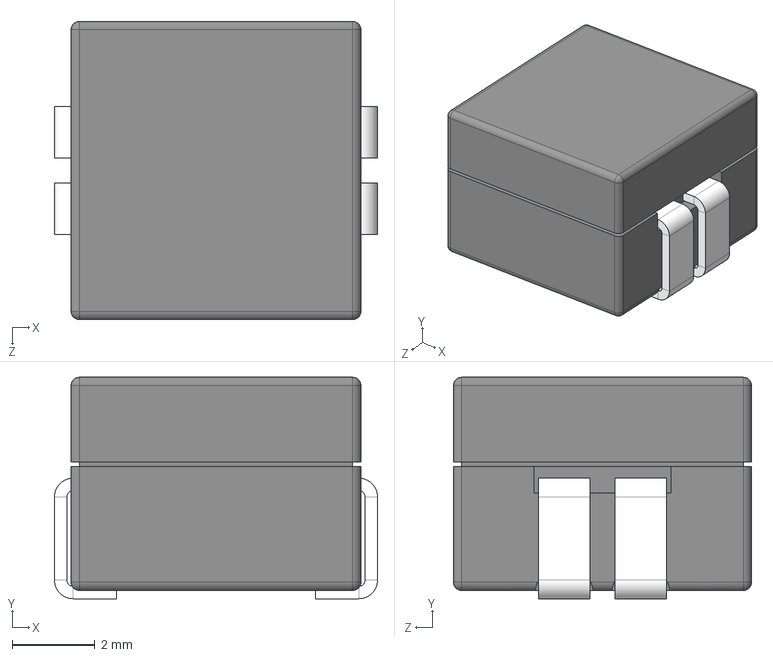
[picture p55: CAD file, 2022-12-03]
3D Models/FPT705.STEP
7.80 x 5.35 x 7.20 mm
