ericboxer/KiCad---BoxLib/3D Models/ESK478M025AM2AA.step

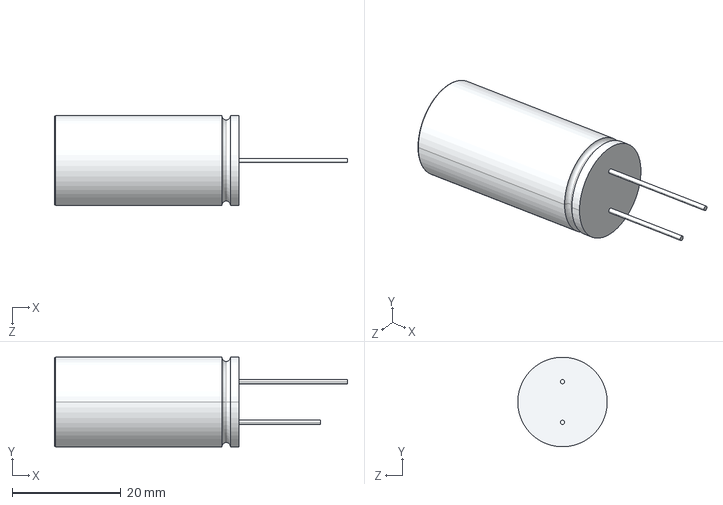
[picture p56: CAD file, 2022-12-03]
3D Models/ESK478M025AM2AA.step
54.0 x 16.5 x 16.5 mm
