ericboxer/KiCad---BoxLib/3D Models/Resistor_0201.step

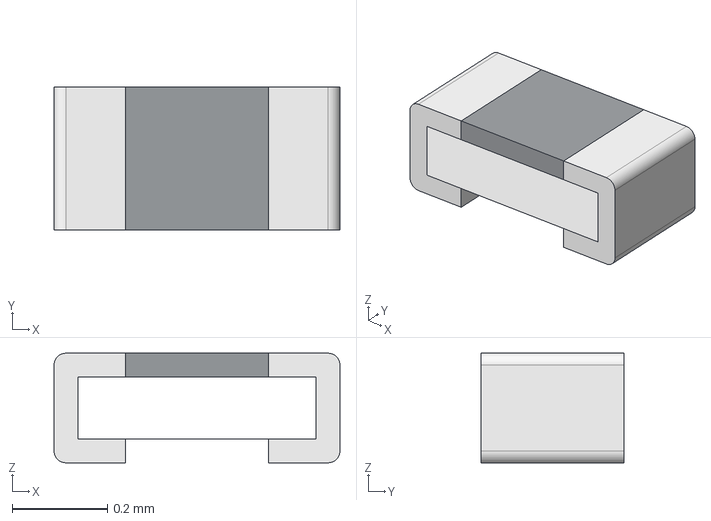
[picture p57: CAD file, 2022-12-03]
3D Models/Resistor_0201.step
0.6 x 0.3 x 0.23 mm
