ericboxer/KiCad---BoxLib/3D Models/Resistor_0402.step

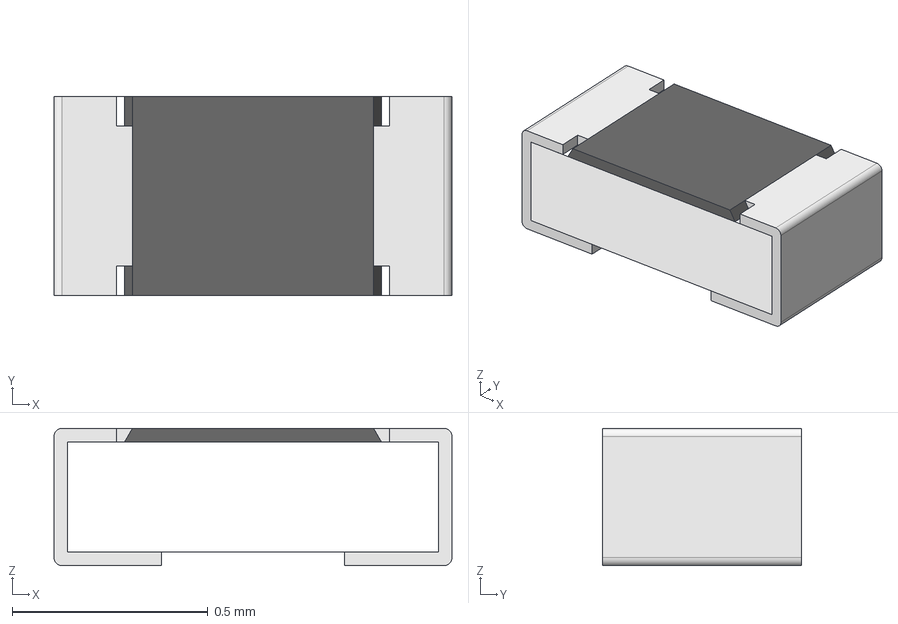
[picture p58: CAD file, 2022-12-03]
3D Models/Resistor_0402.step
1.02 x 0.508 x 0.35 mm
Pin1
Pin2
CeramicBody
Coating
