ericboxer/KiCad---BoxLib/3D Models/Resistor_1206.step

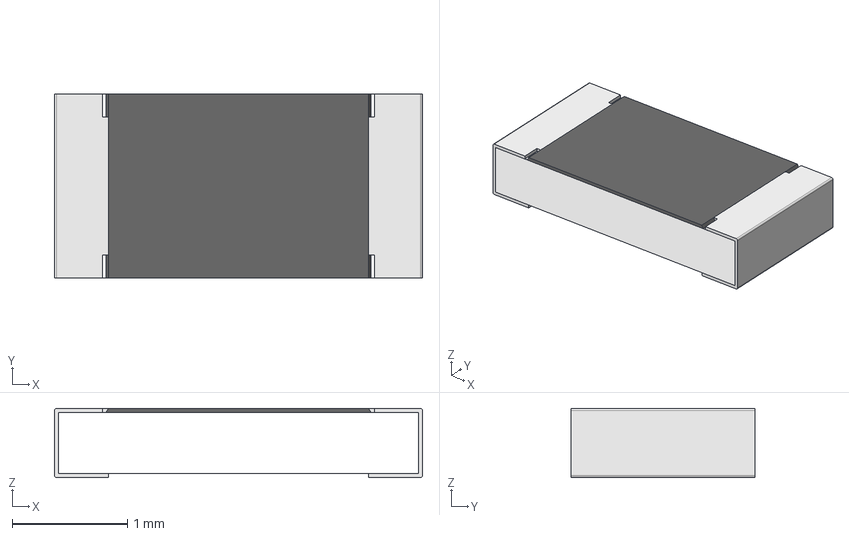
[picture p59: CAD file, 2022-12-02]
3D Models/Resistor_1206.step
3.20 x 1.60 x 0.6 mm
Pin1Body
Pin2Body
CeramicBody
CoatingBody
