ericboxer/KiCad---BoxLib/3D Models/HCM-1390_rev1.stp

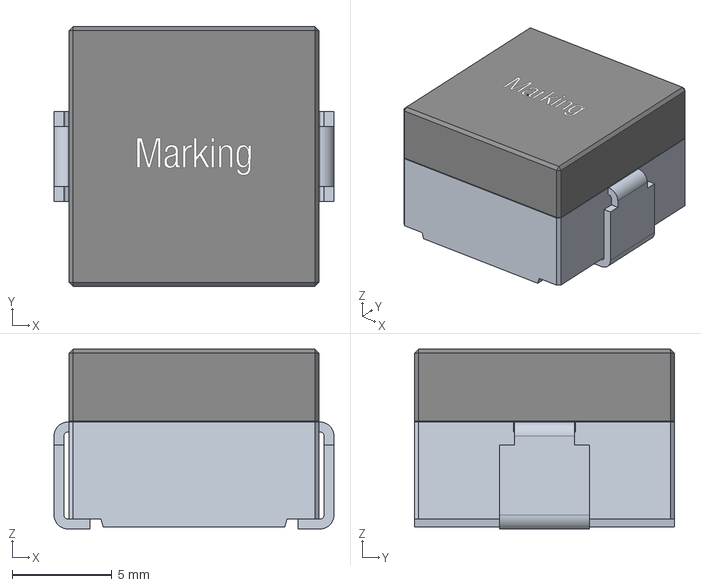
[picture p60: CAD file, 2022-12-02]
3D Models/HCM-1390_rev1.stp
14.0 x 13.0 x 9.00 mm
