ericboxer/KiCad---BoxLib/3D Models/CAP1210.STEP

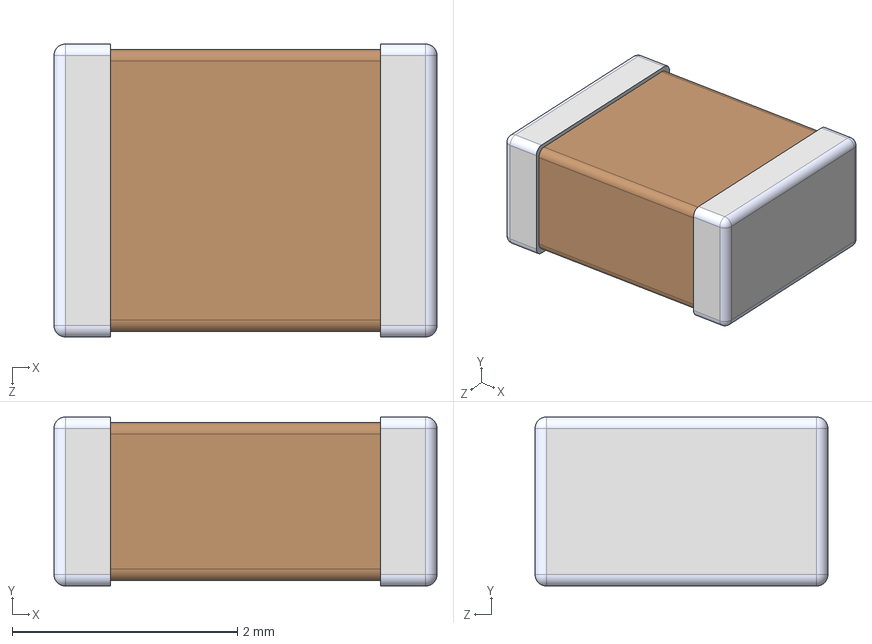
[picture p61: CAD file, 2022-12-02]
3D Models/CAP1210.STEP
3.40 x 1.50 x 2.60 mm
