ericboxer/KiCad---BoxLib/3D Models/BM04B-SRSS-TB.STEP

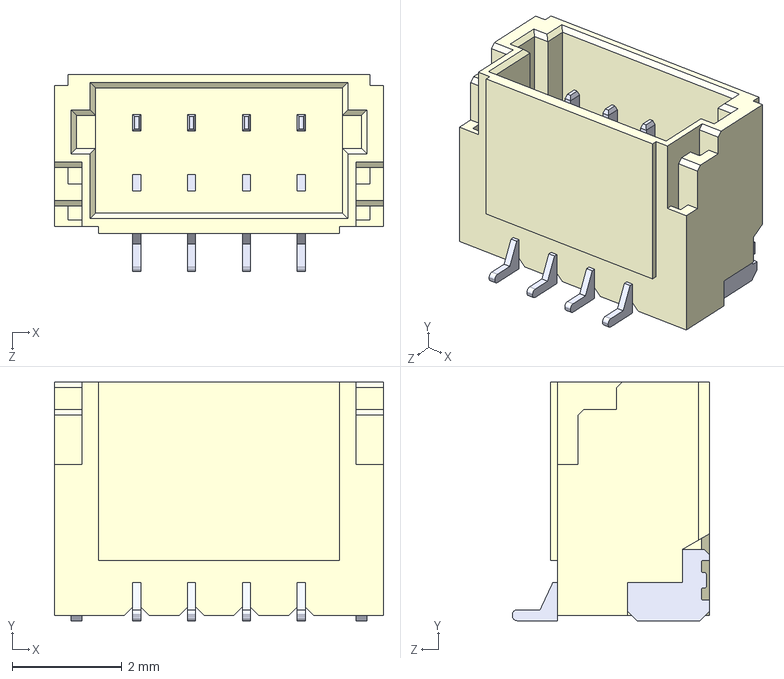
[picture p62: CAD file, 2022-12-02]
3D Models/BM04B-SRSS-TB.STEP
6.00 x 4.35 x 3.60 mm
