ericboxer/KiCad---BoxLib/3D Models/msop-8.step

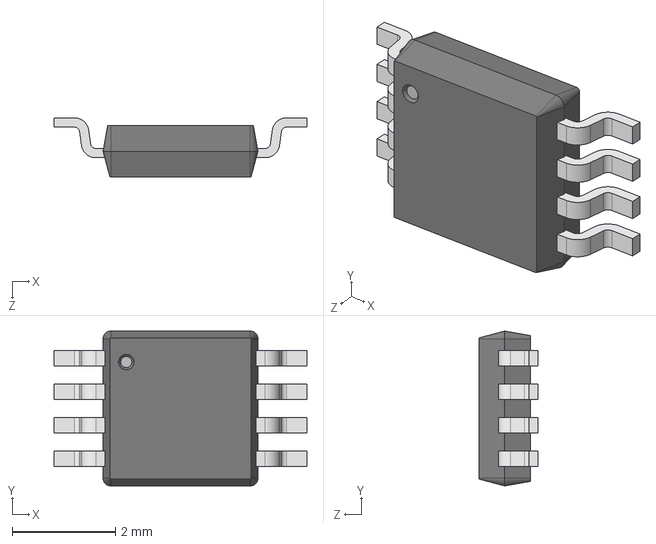
[picture p63: CAD file, 2022-12-02]
3D Models/msop-8.step
4.90 x 3.00 x 1.15 mm
