ericboxer/KiCad---BoxLib/3D Models/molex-470531000.stp

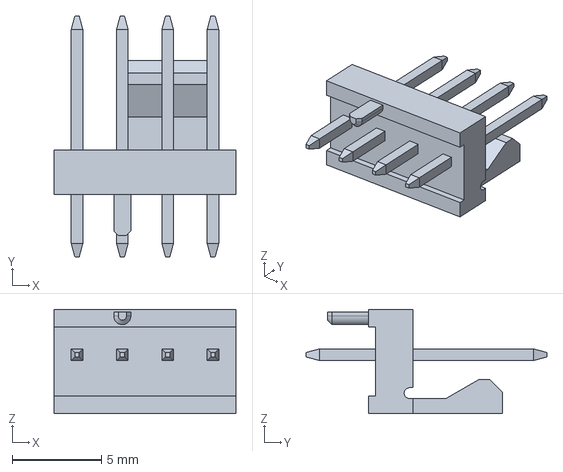
[picture p64: CAD file, 2022-12-02]
3D Models/molex-470531000.stp
10.2 x 13.5 x 5.84 mm
