ericboxer/KiCad---BoxLib/3D Models/W25Q64JVXGIQ_TR.stp

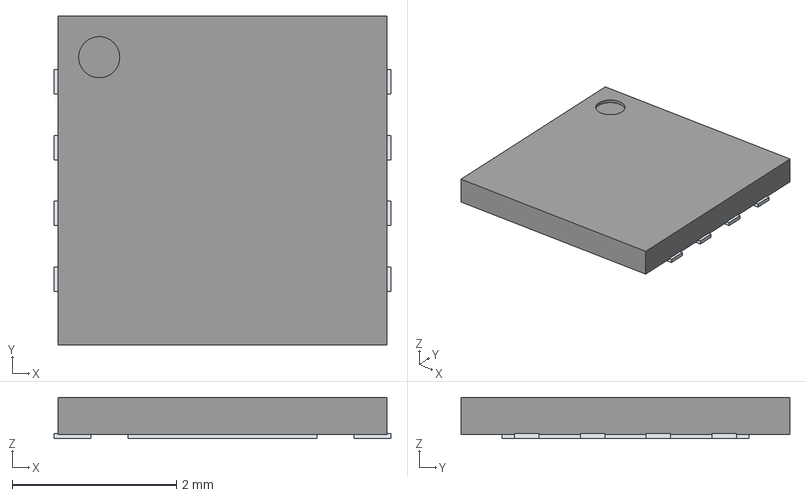
[picture p65: CAD file, 2022-11-28]
3D Models/W25Q64JVXGIQ_TR.stp
4.10 x 4.00 x 0.5 mm
ThermalPin
PinsArrayLR
