ericboxer/KiCad---BoxLib/3D Models/KMR231GLFS.stp

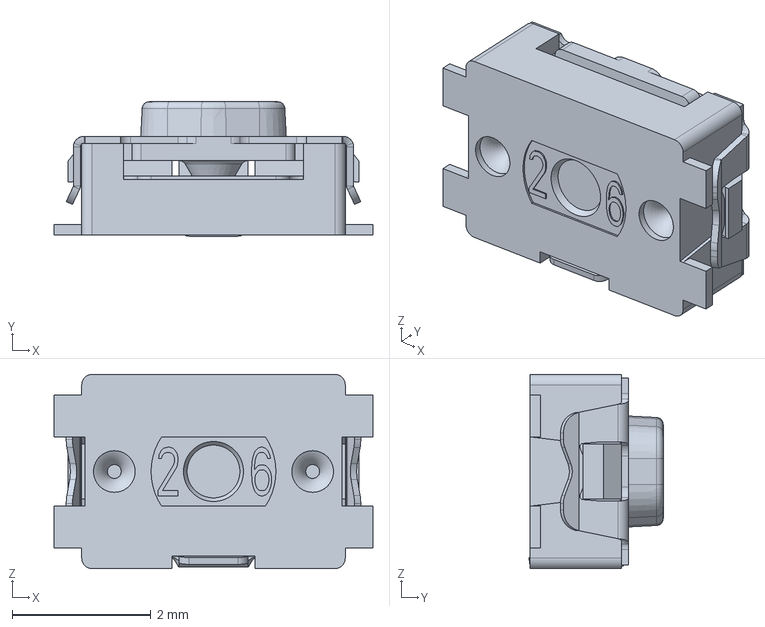
[picture p66: CAD file, 2022-11-28]
3D Models/KMR231GLFS.stp
4.60 x 1.94 x 2.80 mm
