ericboxer/KiCad---BoxLib/3D Models/KX7 SMD Quartz Crystal Resonator 3.2x2.5mm.step

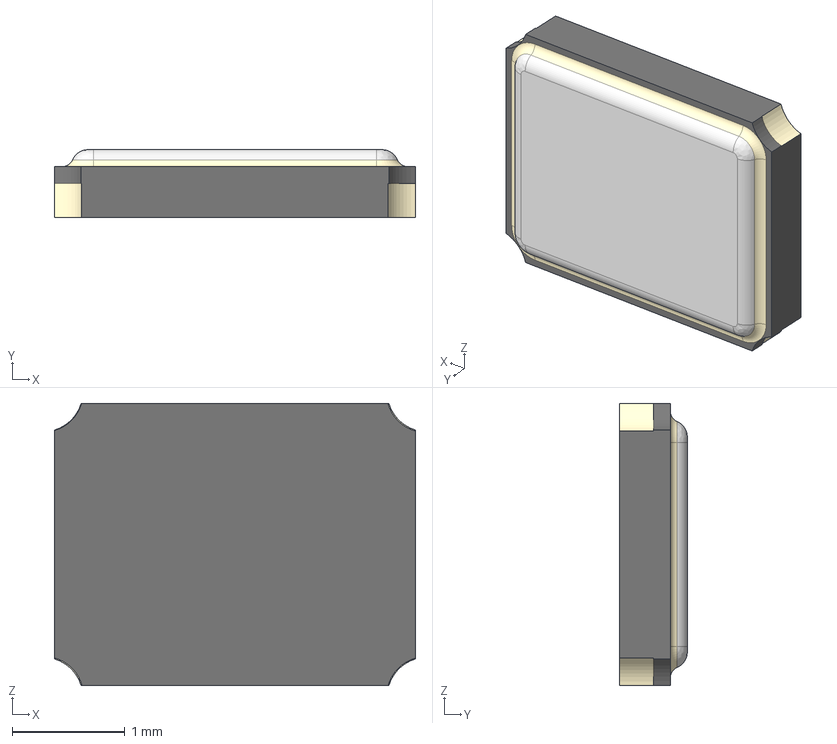
[picture p67: CAD file, 2022-11-28]
3D Models/KX7 SMD Quartz Crystal Resonator 3.2x2.5mm.step
3.20 x 0.6 x 2.50 mm
