ericboxer/KiCad---BoxLib/3D Models/TL1015AF160QG--3DModel-STEP-520916.STEP

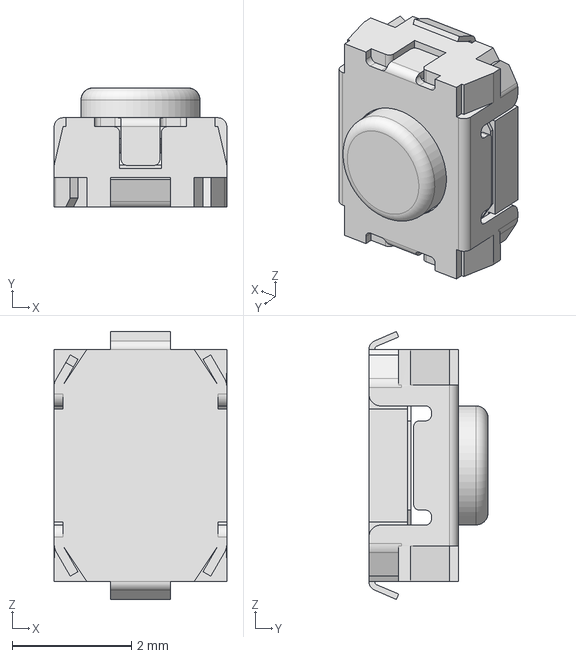
[picture p68: CAD file, 2022-11-28]
3D Models/TL1015AF160QG--3DModel-STEP-520916.STEP
2.90 x 2.00 x 4.50 mm
