ericboxer/KiCad---BoxLib/3D Models/TDFN50P-3MMX3MM-10 v0.step

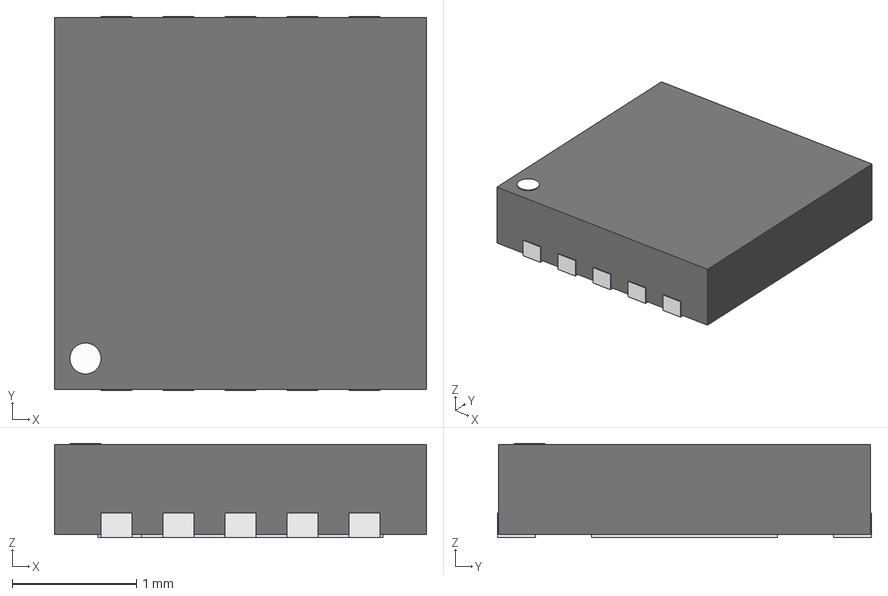
[picture p69: CAD file, 2022-11-28]
3D Models/TDFN50P-3MMX3MM-10 v0.step
3.00 x 3.02 x 0.76 mm
