ericboxer/KiCad---BoxLib/3D Models/PTS647SK38SMTR2LFS.stp

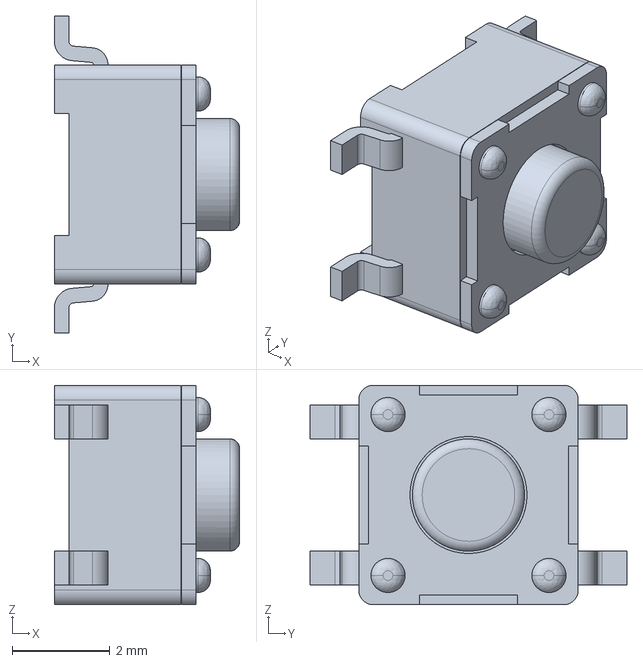
[picture p70: CAD file, 2022-11-28]
3D Models/PTS647SK38SMTR2LFS.stp
3.80 x 6.50 x 4.50 mm
