ericboxer/KiCad---BoxLib/3D Models/Raspberri_Pi_RP2040.step

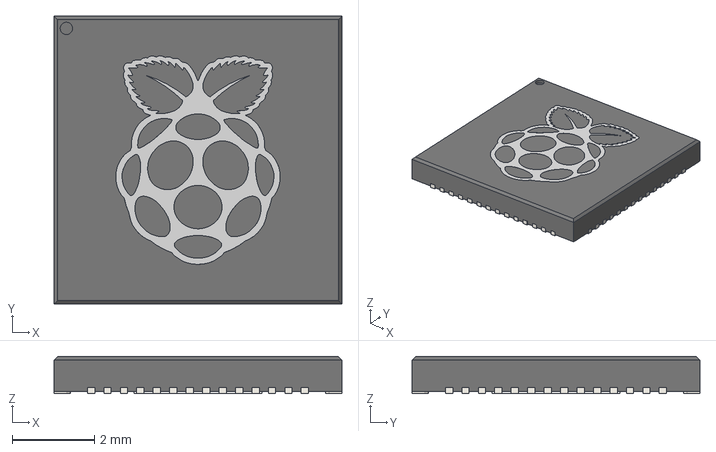
[picture p71: CAD file, 2022-11-28]
3D Models/Raspberri_Pi_RP2040.step
7.00 x 7.00 x 0.9 mm
