ericboxer/KiCad---BoxLib/3D Models/bourns-mf-psmf110x.stp

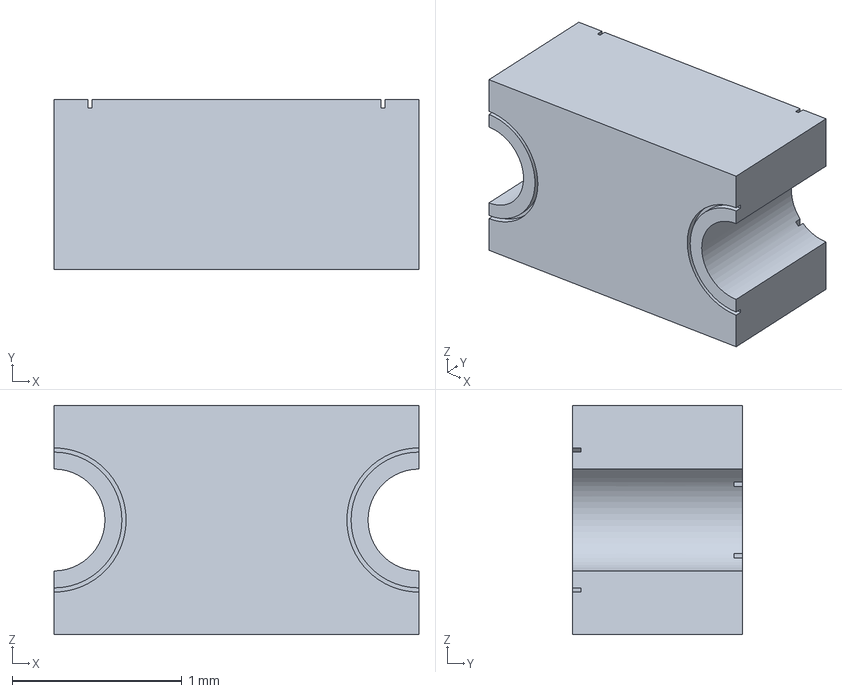
[picture p72: CAD file, 2022-11-28]
3D Models/bourns-mf-psmf110x.stp
2.15 x 1.00 x 1.35 mm
