ericboxer/KiCad---BoxLib/3D Models/MEM2061-01-188-00-A.stp

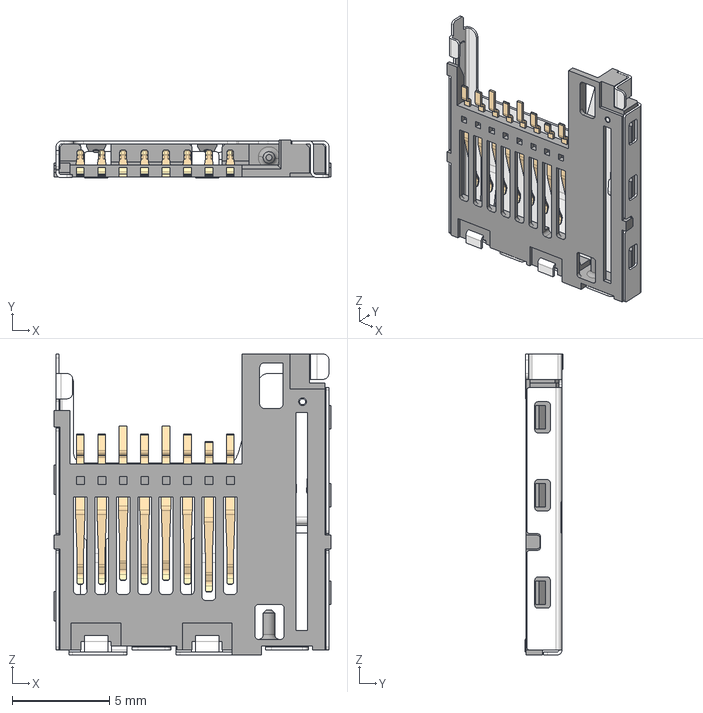
[picture p73: CAD file, 2022-11-25]
3D Models/MEM2061-01-188-00-A.stp
14.2 x 1.95 x 15.5 mm
MEM2061-01-188-00-A_PART2
MEM2061-01-188-00-A_PART1
