ericboxer/KiCad---BoxLib/3D Models/MEM2075-00-140-01-A.stp

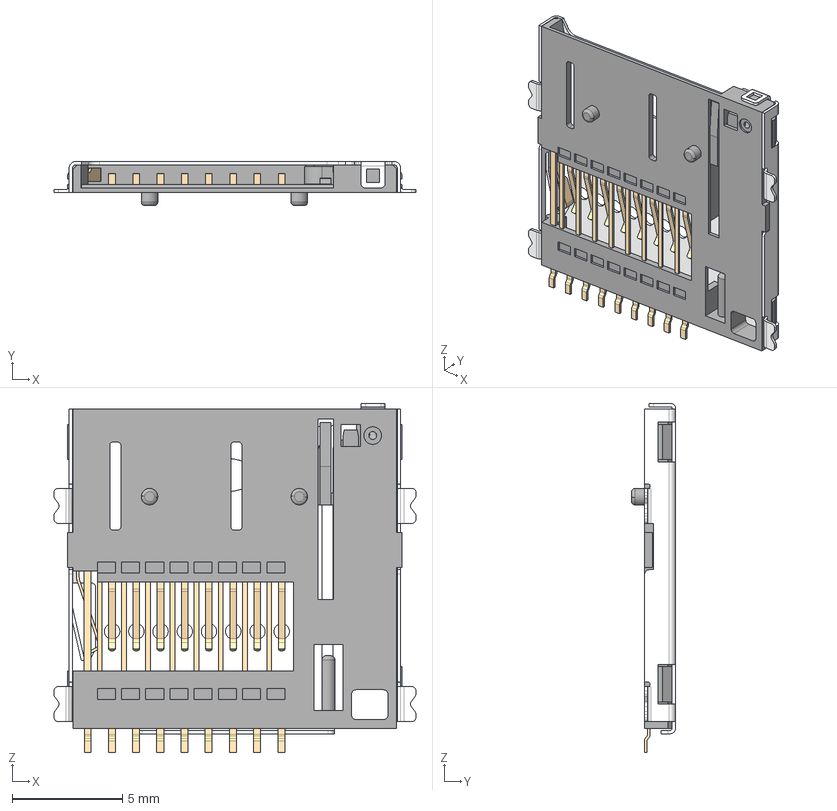
[picture p74: CAD file, 2022-11-25]
3D Models/MEM2075-00-140-01-A.stp
16.4 x 2.00 x 15.9 mm
MEM2075-00-140-01-A_PART3
MEM2075-00-140-01-A_PART2
MEM2075-00-140-01-A_PART1
