ericboxer/KiCad---BoxLib/3D Models/JST-SH-4.STEP

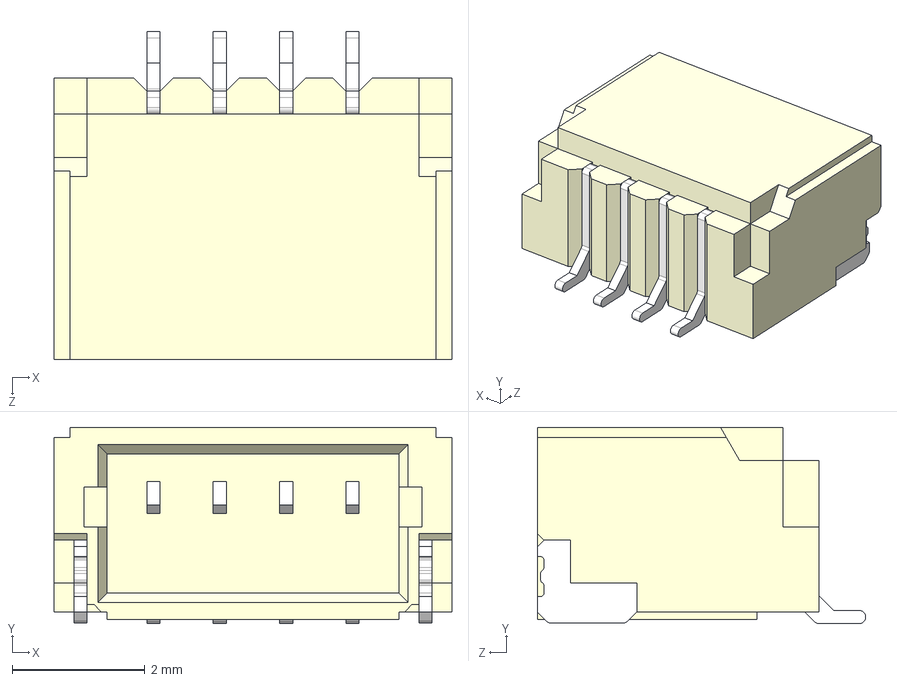
[picture p75: CAD file, 2022-11-25]
3D Models/JST-SH-4.STEP
6.00 x 2.96 x 4.95 mm
