ericboxer/KiCad---BoxLib/3D Models/SOT-583.STEP

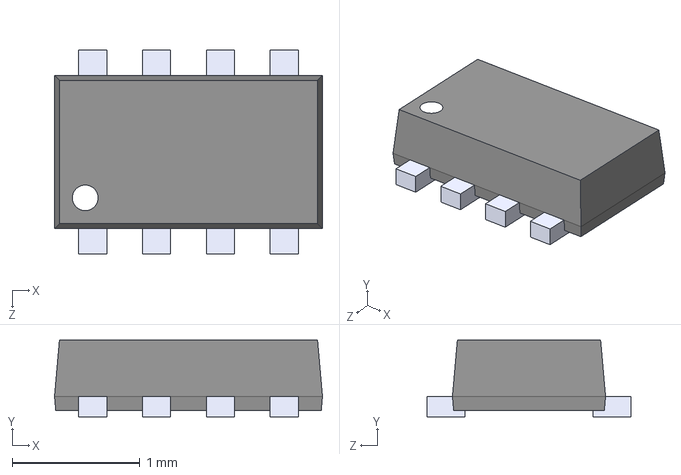
[picture p76: CAD file, 2022-11-24]
3D Models/SOT-583.STEP
2.10 x 0.6 x 1.60 mm
