ericboxer/KiCad---BoxLib/3D Models/TPS2116DRLR.stp

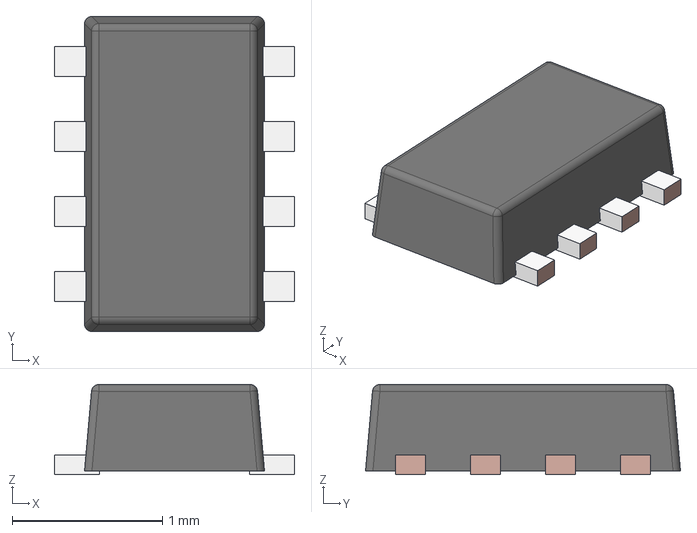
[picture p77: CAD file, 2022-11-24]
3D Models/TPS2116DRLR.stp
1.60 x 2.10 x 0.6 mm
FRAME-DRL0008A
BODY-SOT
