ericboxer/KiCad---BoxLib/3D Models/1255AY.STEP

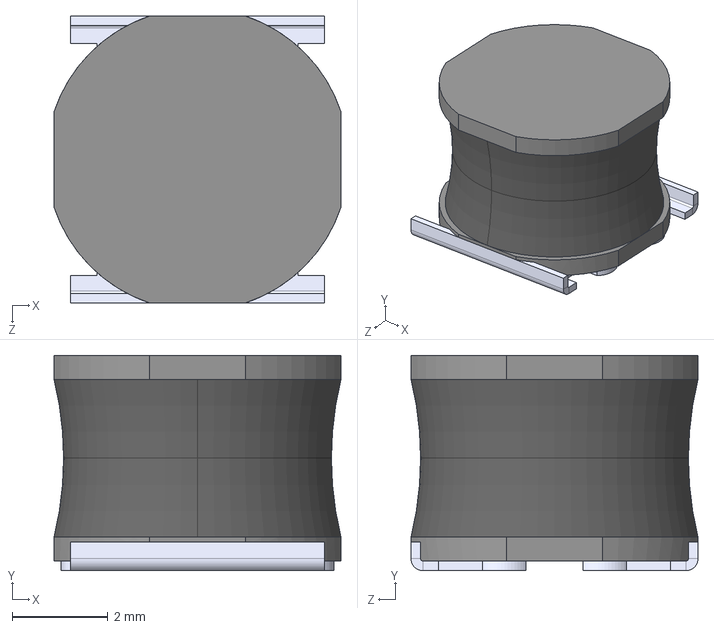
[picture p78: CAD file, 2022-11-24]
3D Models/1255AY.STEP
6.00 x 4.50 x 6.00 mm
