ericboxer/KiCad---BoxLib/3D Models/MPL-AL5050-xxx.STEP

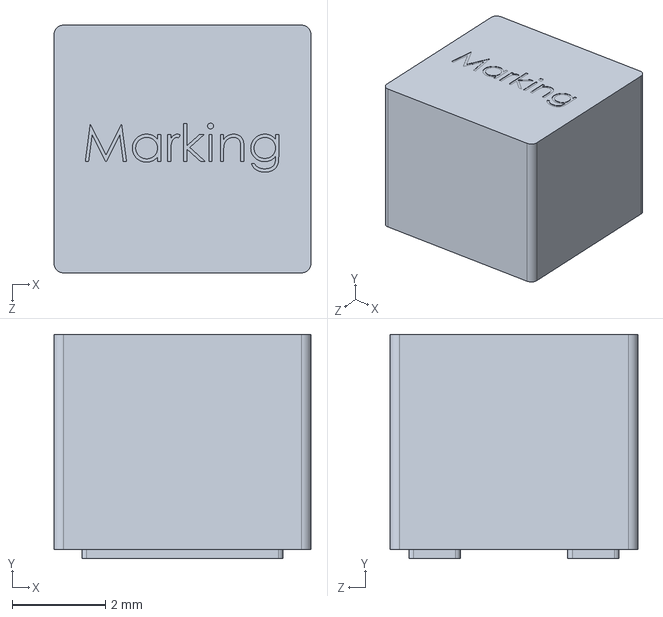
[picture p79: CAD file, 2022-11-24]
3D Models/MPL-AL5050-xxx.STEP
5.50 x 4.80 x 5.30 mm
