ericboxer/KiCad---BoxLib/3D Models/ABM3B.STEP

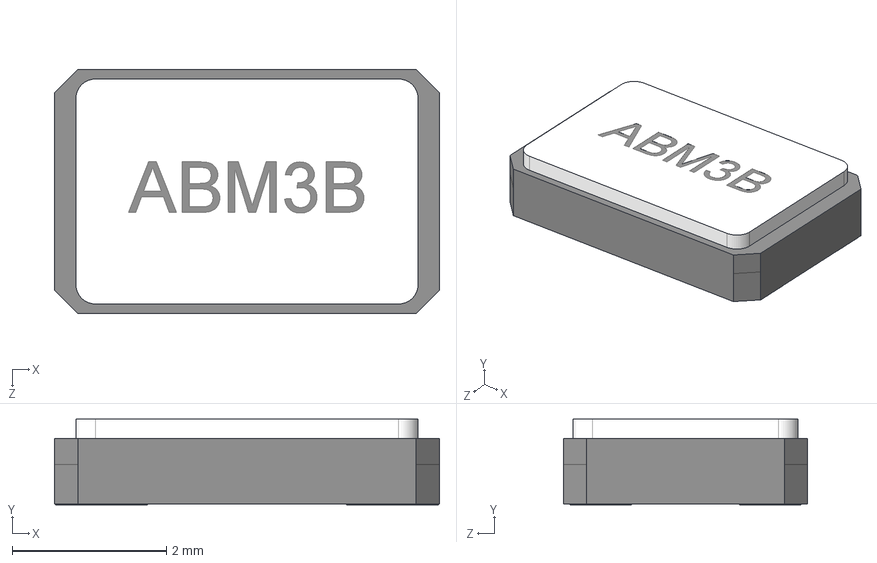
[picture p80: CAD file, 2022-11-23]
3D Models/ABM3B.STEP
5.00 x 1.11 x 3.18 mm
