ericboxer/KiCad---BoxLib/3D Models/SN65HVD72DRBR.STEP

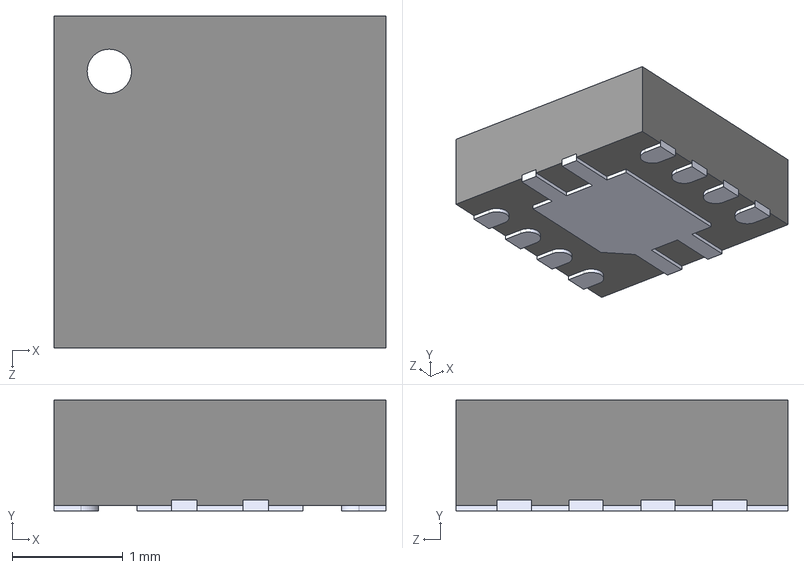
[picture p81: CAD file, 2022-11-21]
3D Models/SN65HVD72DRBR.STEP
3.00 x 1.00 x 3.00 mm
