ericboxer/KiCad---BoxLib/3D Models/pxc_1935174_05.stp

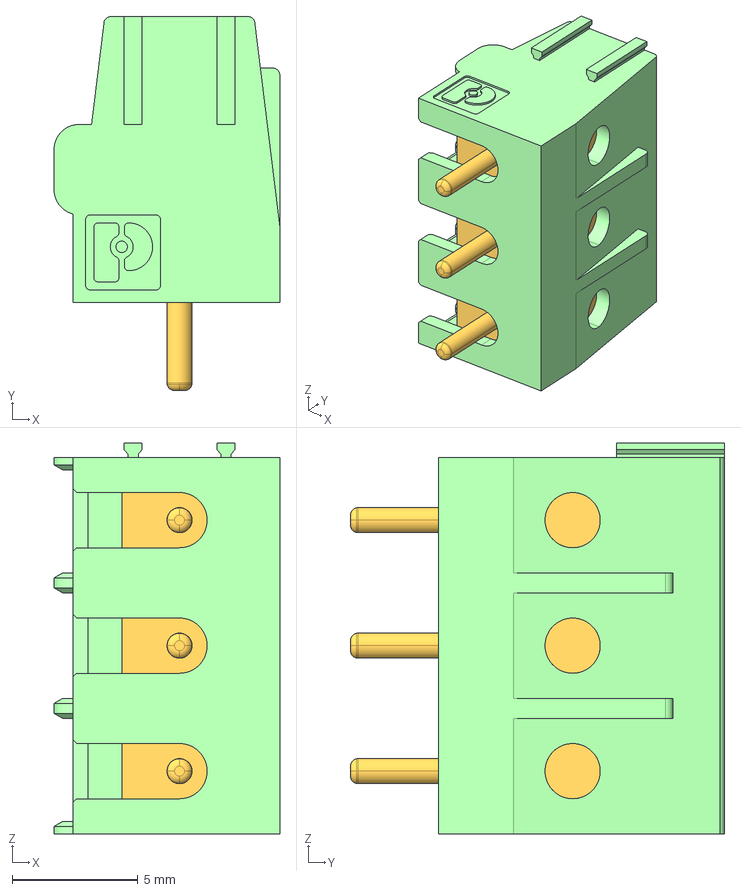
[picture p82: CAD file, 2022-11-20]
3D Models/pxc_1935174_05.stp
9.00 x 14.9 x 15.6 mm
