ericboxer/KiCad---BoxLib/3D Models/Vicor-mini.STP

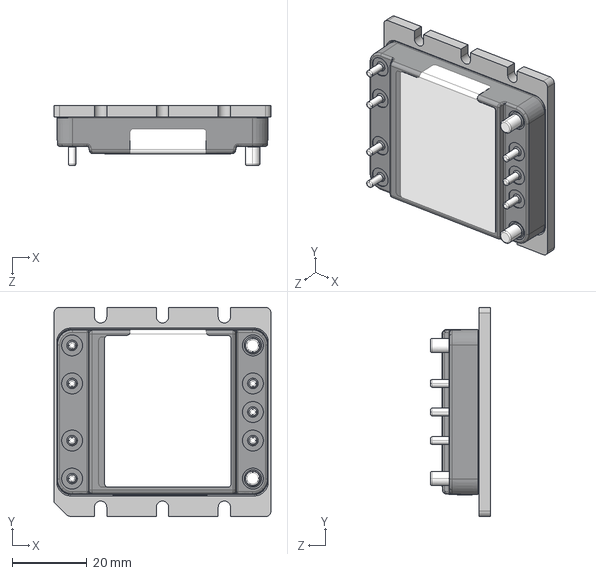
[picture p83: CAD file, 2022-11-20]
3D Models/Vicor-mini.STP
58.1 x 56.0 x 16.1 mm
