ericboxer/KiCad---BoxLib/3D Models/15-006463.stp

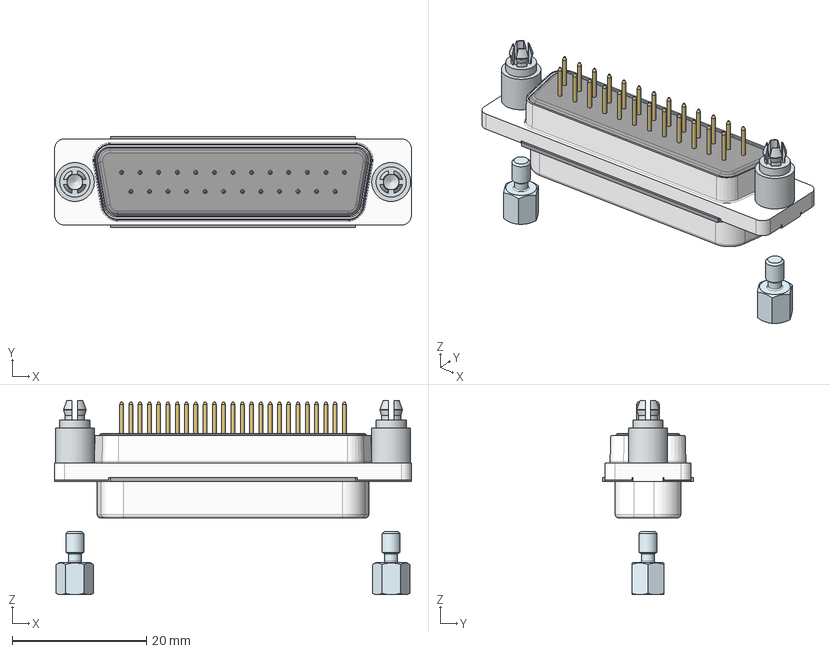
[picture p85: CAD file, 2022-11-20]
3D Models/15-006463.stp
53.1 x 13.5 x 28.9 mm
