ericboxer/KiCad---BoxLib/3D Models/PI3303-00-LGIZ.step

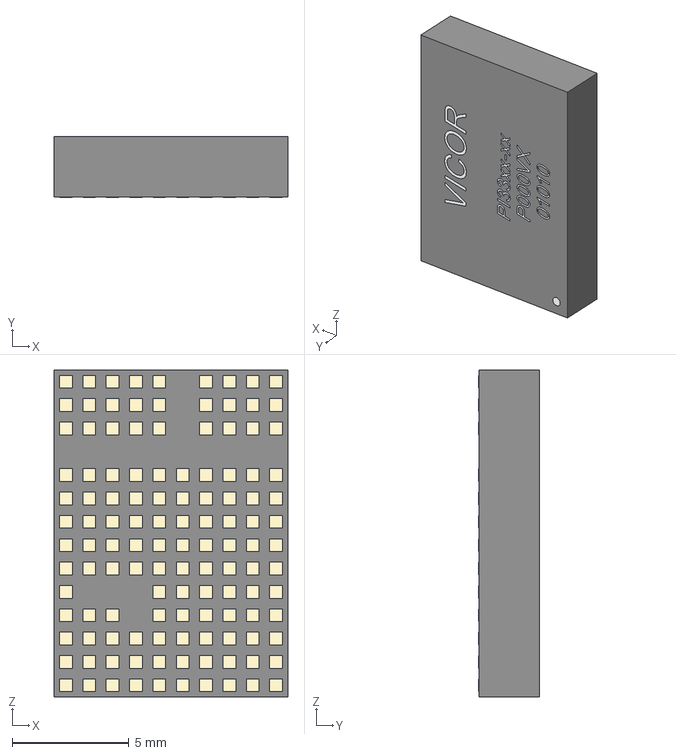
[picture p86: CAD file, 2022-11-20]
3D Models/PI3303-00-LGIZ.step
10.0 x 2.63 x 14.0 mm
