ericboxer/KiCad---BoxLib/3D Models/te-1757827-3.stp

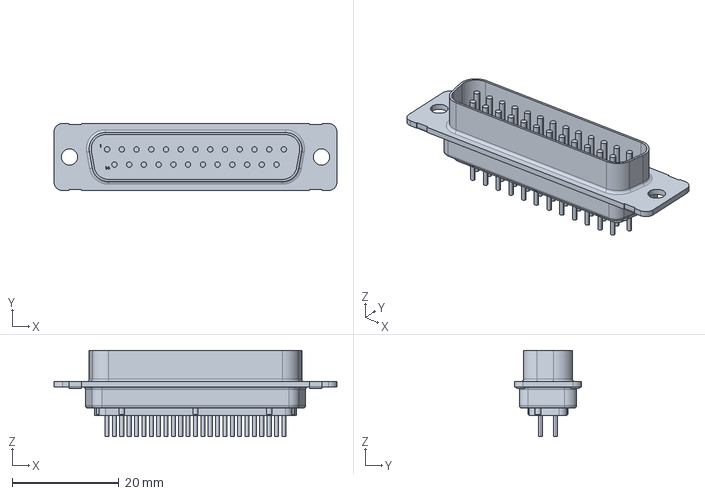
[picture p87: CAD file, 2022-11-20]
3D Models/te-1757827-3.stp
53.0 x 12.5 x 16.1 mm
