ericboxer/KiCad---BoxLib/3D Models/HVSON8_3x3x0_85 pitch 0_5mm.STEP

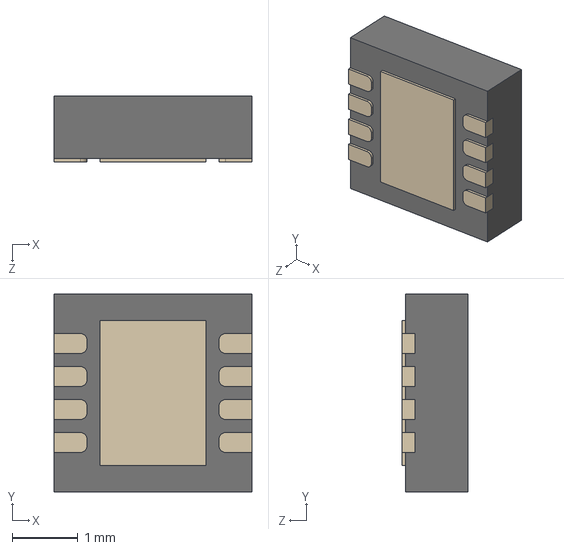
[picture p88: CAD file, 2022-07-30]
3D Models/HVSON8_3x3x0_85 pitch 0_5mm.STEP
3.00 x 3.00 x 1.00 mm
