ericboxer/KiCad---BoxLib/3D Models/Cap=12_5-14.step

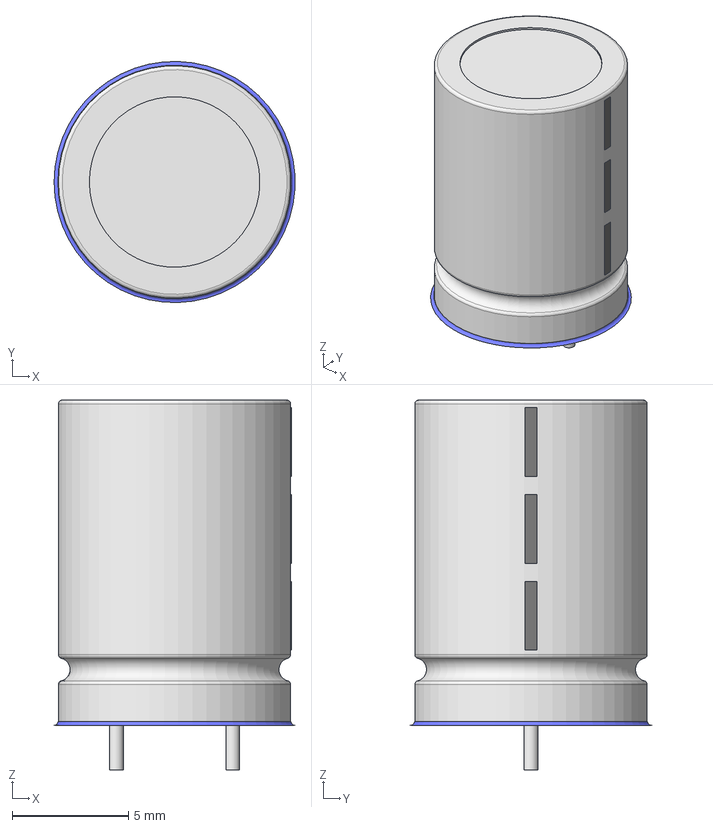
[picture p89: CAD file, 2022-07-30]
3D Models/Cap=12_5-14.step
10.4 x 10.4 x 15.9 mm
