ericboxer/KiCad---BoxLib/3D Models/HVSON-8.STEP

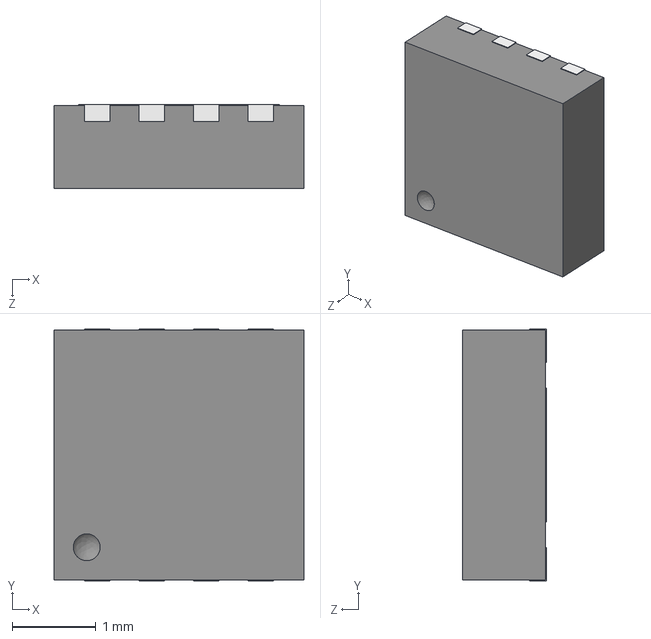
[picture p90: CAD file, 2022-07-30]
3D Models/HVSON-8.STEP
2.98 x 3.00 x 1.00 mm
