ericboxer/KiCad---BoxLib/3D Models/pxc_1790111.stp

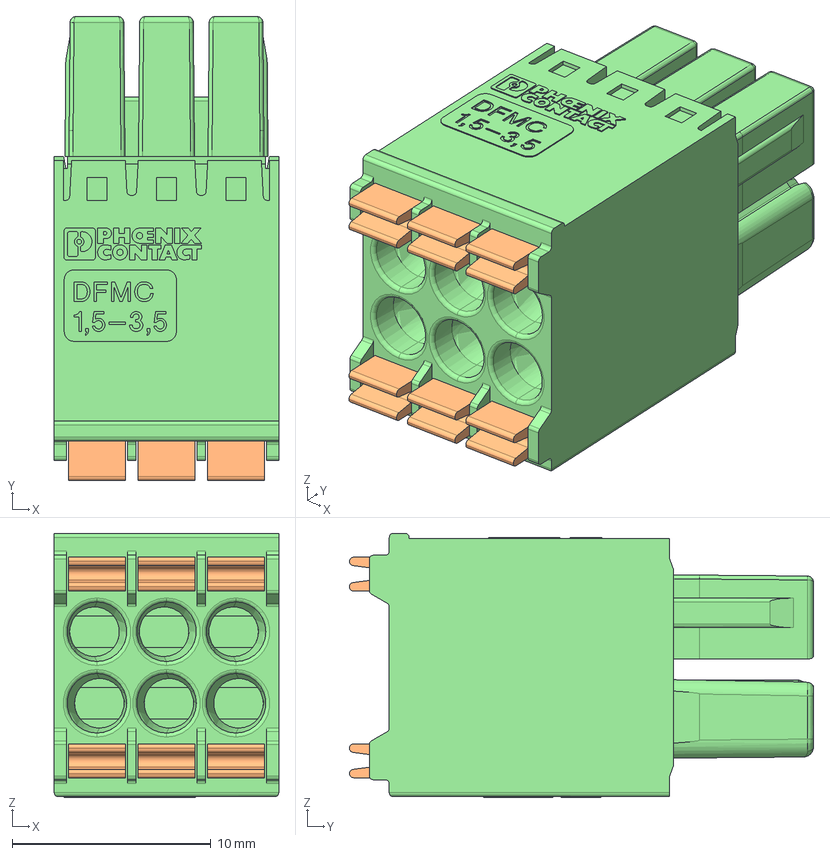
[picture p91: CAD file, 2022-07-30]
3D Models/pxc_1790111.stp
11.3 x 23.4 x 13.3 mm
