ericboxer/KiCad---BoxLib/3D Models/pxc_1953716.stp

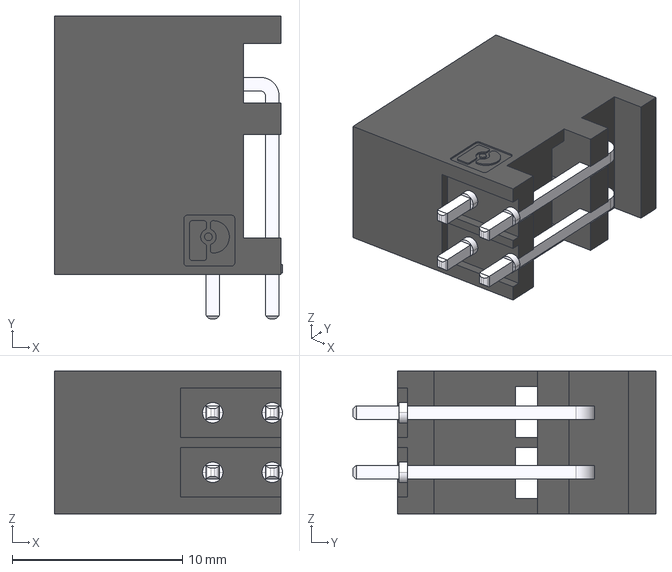
[picture p92: CAD file, 2022-07-30]
3D Models/pxc_1953716.stp
13.4 x 17.8 x 8.40 mm
