ericboxer/KiCad---BoxLib/3D Models/pxc_1788505.stp

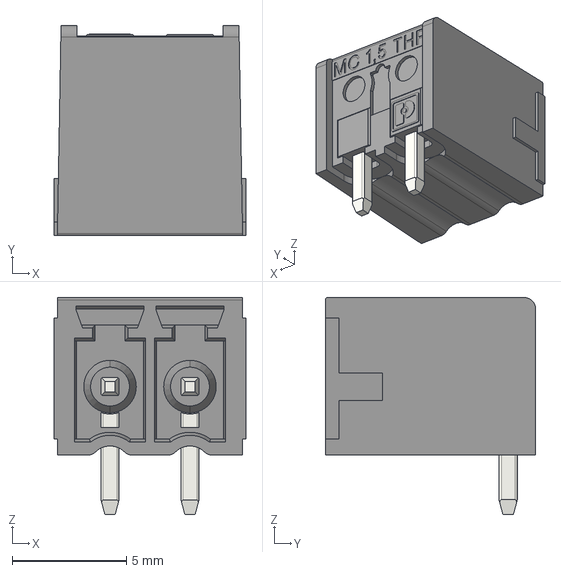
[picture p93: CAD file, 2022-07-30]
3D Models/pxc_1788505.stp
8.39 x 9.20 x 9.50 mm
AT_MC_1_5_G_3_5_THR
LP_MC_1_5_LH_STIFT_GURT_2 x 2
