ericboxer/KiCad---BoxLib/3D Models/SNT-100-BK-G.stp

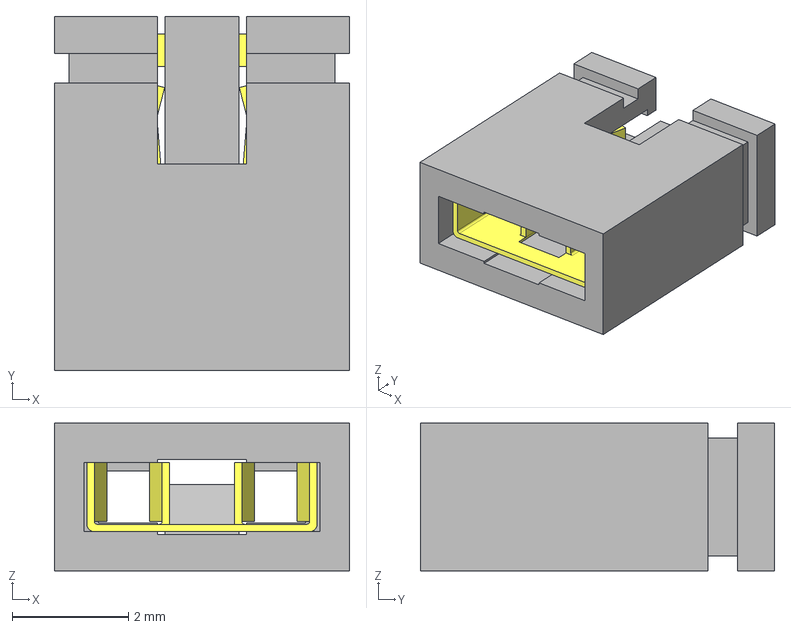
[picture p94: CAD file, 2022-07-30]
3D Models/SNT-100-BK-G.stp
5.08 x 6.10 x 2.54 mm
_SNT-100-BK_body
_SNT-100_pins
