ericboxer/KiCad---BoxLib/3D Models/CUI_V7803-1000-SMT.step

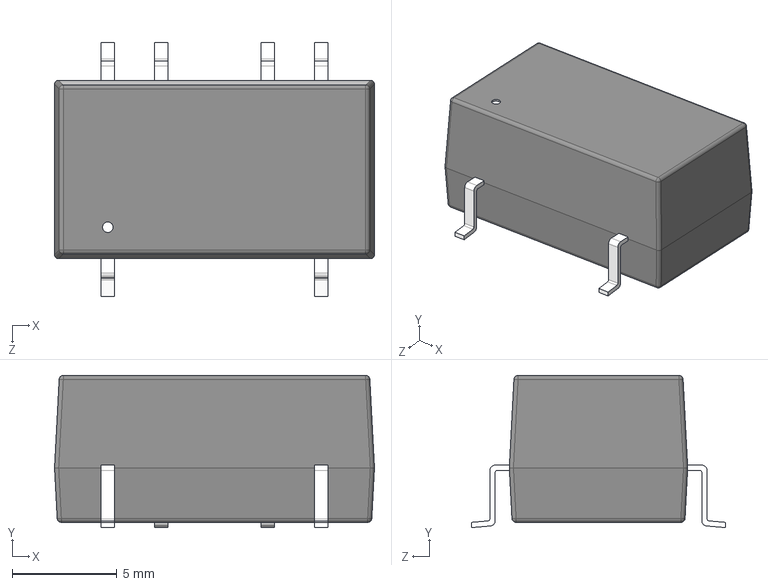
[picture p95: CAD file, 2022-07-30]
3D Models/CUI_V7803-1000-SMT.step
15.2 x 7.25 x 12.1 mm
