ericboxer/KiCad---BoxLib/3D Models/Picker PC236.step

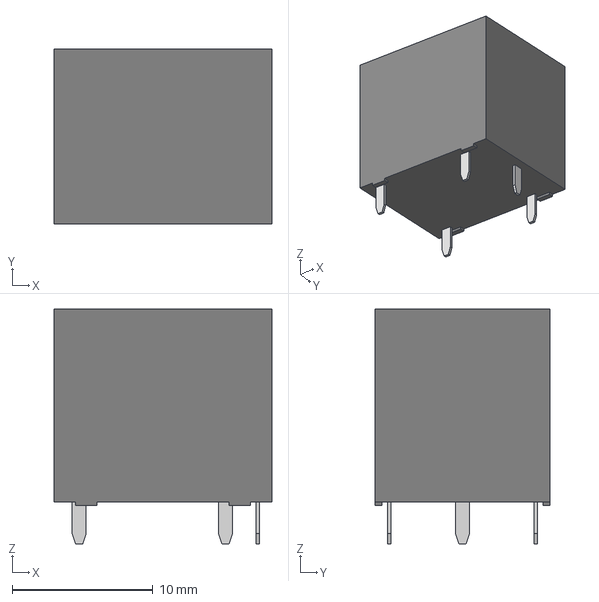
[picture p96: CAD file, 2022-07-30]
3D Models/Picker PC236.step
15.5 x 12.4 x 16.7 mm
