ericboxer/KiCad---BoxLib/3D Models/CUI_V78E05-500-SMT.step

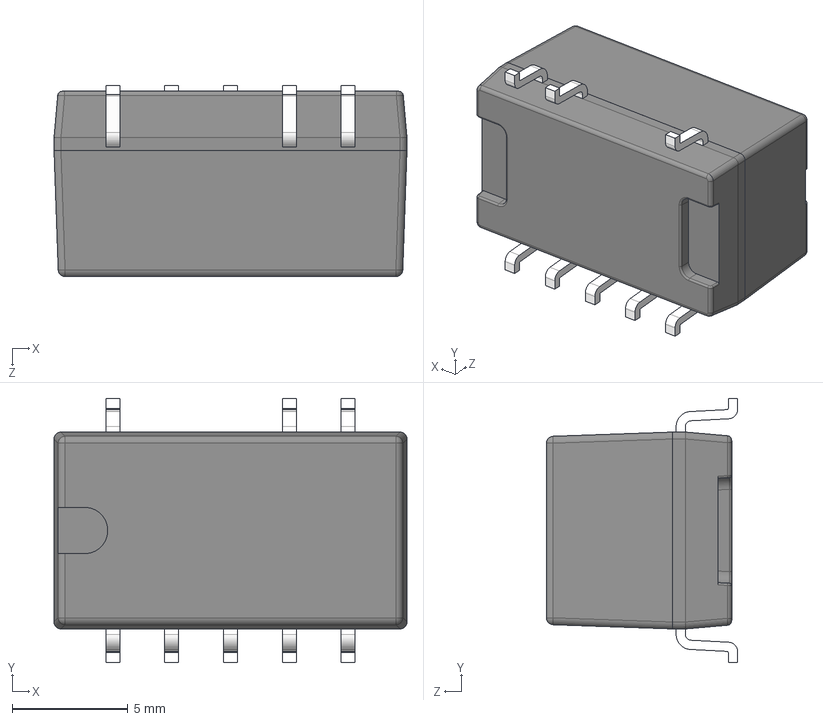
[picture p97: CAD file, 2022-07-30]
3D Models/CUI_V78E05-500-SMT.step
15.2 x 11.4 x 8.25 mm
