ericboxer/KiCad---BoxLib/3D Models/P(B,C)C03SAAN.STEP

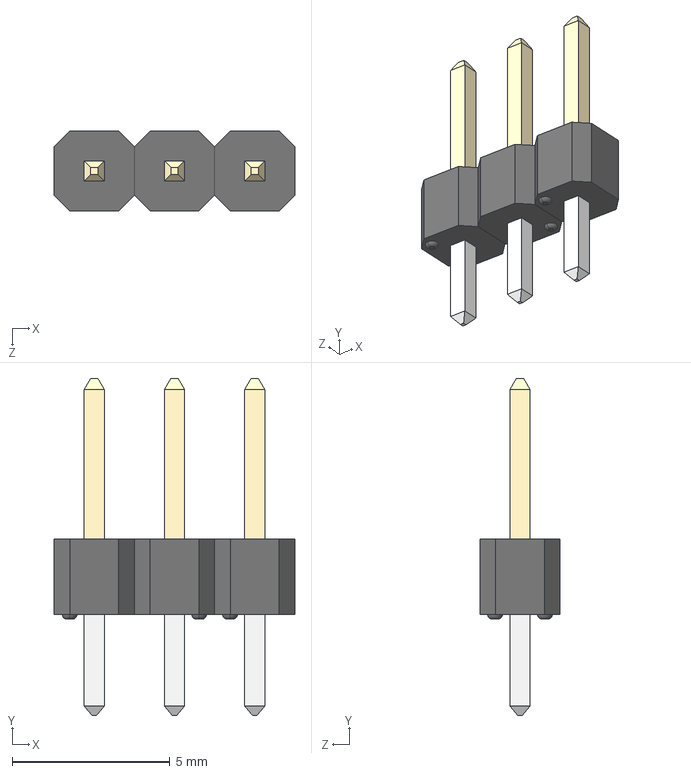
[picture p98: CAD file, 2022-07-30]
3D Models/P(B,C)C03SAAN.STEP
7.62 x 10.7 x 2.54 mm
P(B,C)C01SAAN x 3
