ericboxer/KiCad---BoxLib/3D Models/SO8 SOT96-1.step

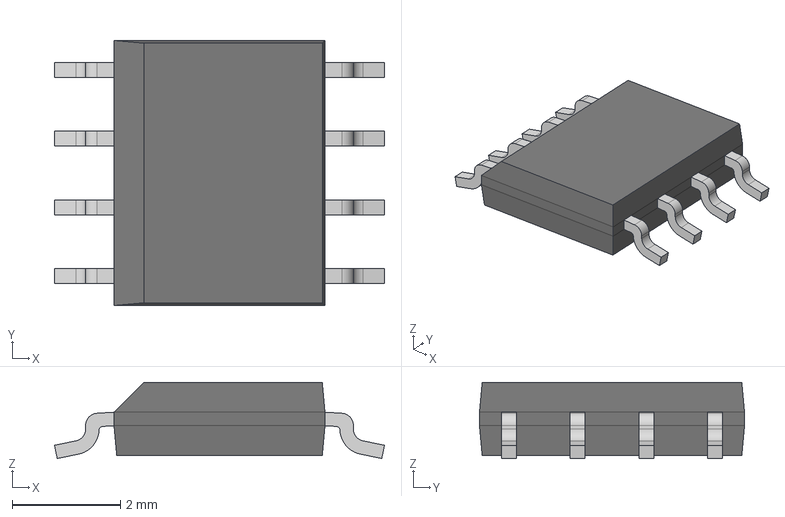
[picture p99: CAD file, 2022-07-30]
3D Models/SO8 SOT96-1.step
6.10 x 4.90 x 1.41 mm
