ericboxer/KiCad---BoxLib/3D Models/pxc_1953729.stp

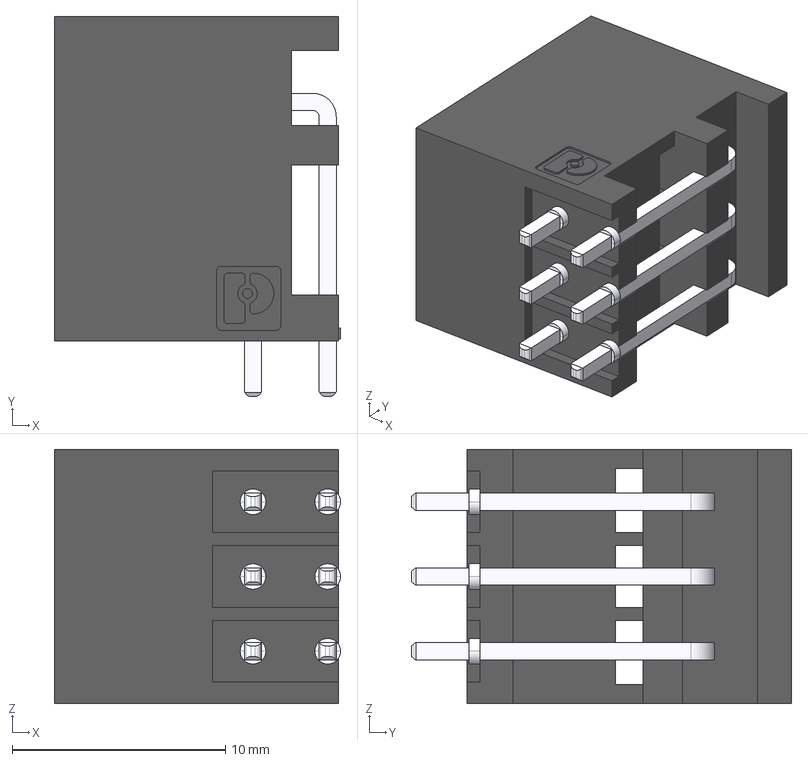
[picture p100: CAD file, 2022-07-30]
3D Models/pxc_1953729.stp
13.4 x 17.8 x 11.9 mm
