ericboxer/KiCad---BoxLib/3D Models/QFN 24 4x4.step

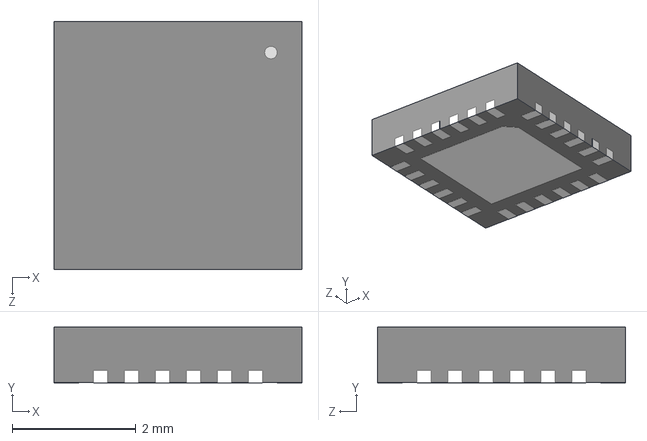
[picture p101: CAD file, 2022-07-30]
3D Models/QFN 24 4x4.step
4.00 x 0.9 x 4.00 mm
