ericboxer/KiCad---BoxLib/3D Models/SOD123F.step

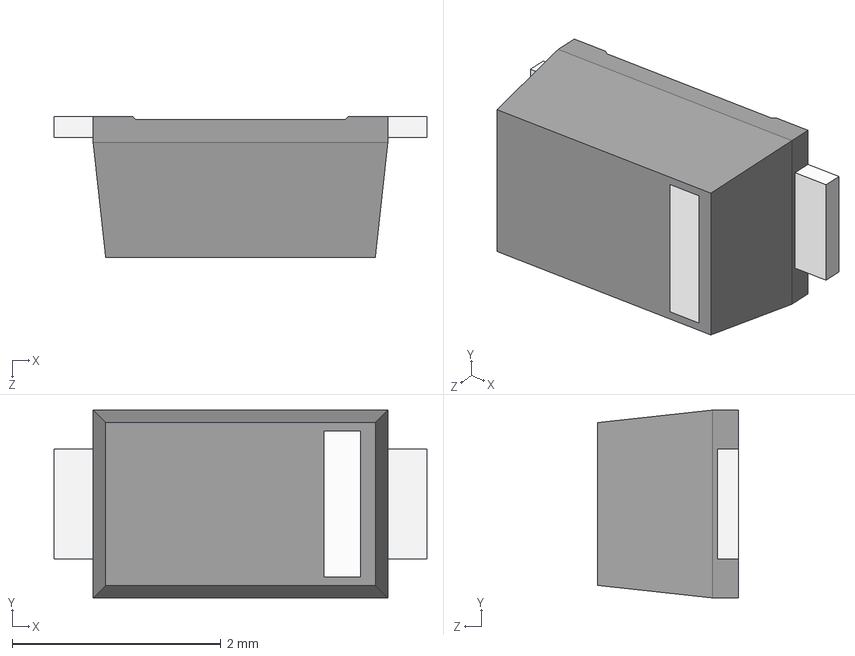
[picture p102: CAD file, 2022-07-30]
3D Models/SOD123F.step
3.58 x 1.80 x 1.35 mm
