ericboxer/KiCad---BoxLib/3D Models/Keystone 5006 black.STEP

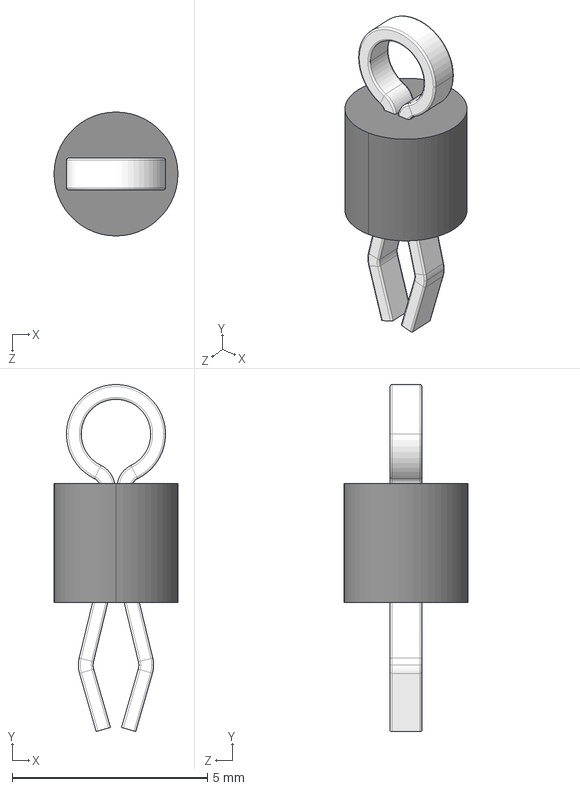
[picture p103: CAD file, 2022-07-30]
3D Models/Keystone 5006 black.STEP
3.17 x 8.89 x 3.17 mm
