ericboxer/KiCad---BoxLib/3D Models/pxc_1952267.stp

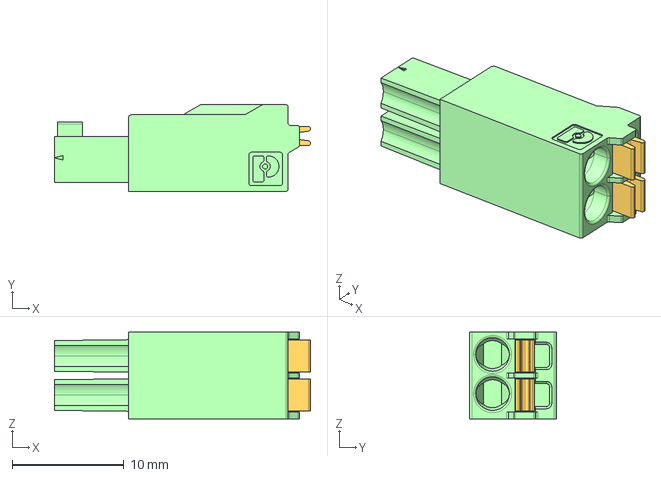
[picture p104: CAD file, 2022-07-30]
3D Models/pxc_1952267.stp
22.9 x 7.75 x 7.75 mm
