ericboxer/KiCad---BoxLib/3D Models/B02SVFN-RC.STEP

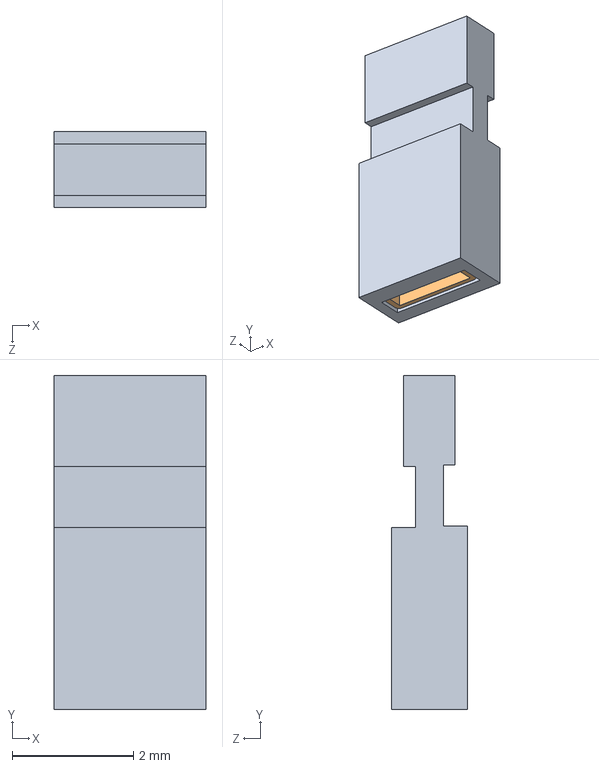
[picture p105: CAD file, 2022-07-30]
3D Models/B02SVFN-RC.STEP
2.50 x 5.50 x 1.25 mm
