ericboxer/KiCad---BoxLib/3D Models/dfn1006-2.step

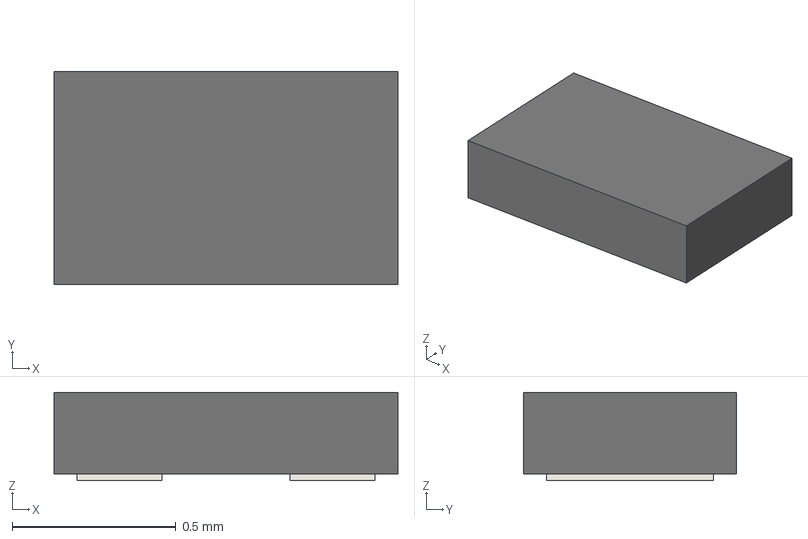
[picture p106: CAD file, 2022-07-30]
3D Models/dfn1006-2.step
1.05 x 0.65 x 0.27 mm
