ericboxer/KiCad---BoxLib/3D Models/Wurth 632723100011.stp

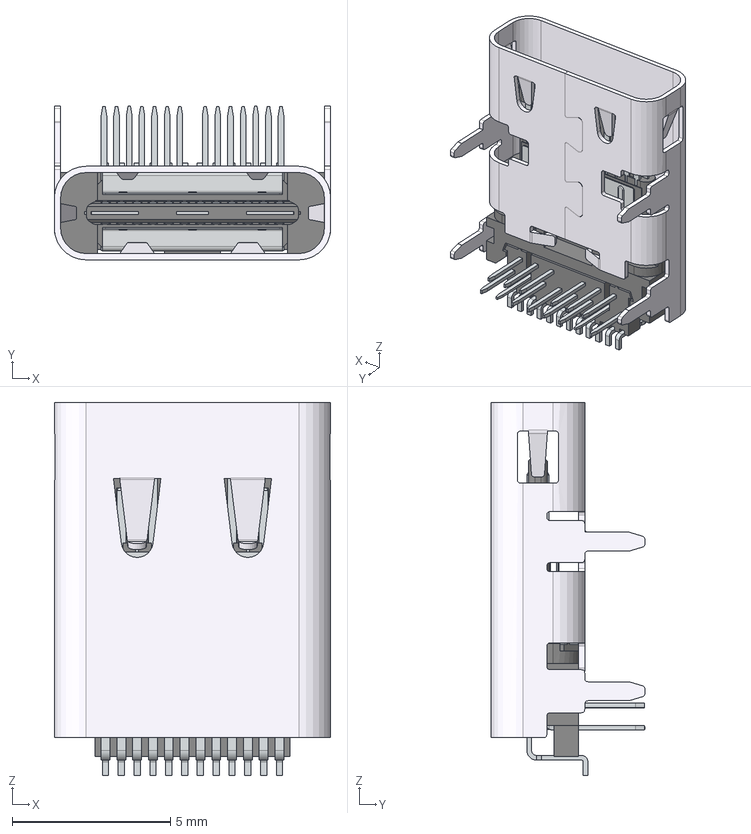
[picture p107: CAD file, 2022-07-30]
3D Models/Wurth 632723100011.stp
8.74 x 4.86 x 11.8 mm
632723100011_Housing
632723100011_Shielding_3_v3
632723100011_PIN2_Top_v3 x 8
632723100011_Housing_TOP
632723100011_Shielding_1_v3
632723100011_PIN1_Top_v3 x 4
632723100011_Housing_Bottom
632723100011_PIN1_Bottom_v3
632723100011_PIN2_Bottom_v3
632723100011_PIN4_Bottom_v3
632723100011_PIN5_Bottom_v3
632723100011_PIN6_Bottom_v3
632723100011_PIN7_Bottom_v3
632723100011_Shielding_2 x 2
632723100011_PIN1_Bottom_v3_mir
632723100011_PIN4_Bottom_v3_mir
632723100011_PIN6_Bottom_v3_mir
632723100011_PIN2_Bottom_v3_mir
632723100011_PIN5_Bottom_v3_mir
632723100011_PIN7_Bottom_v3_mir
632723100011_Housing_Bottom3
