ericboxer/KiCad---BoxLib/3D Models/pxc_1790302.stp

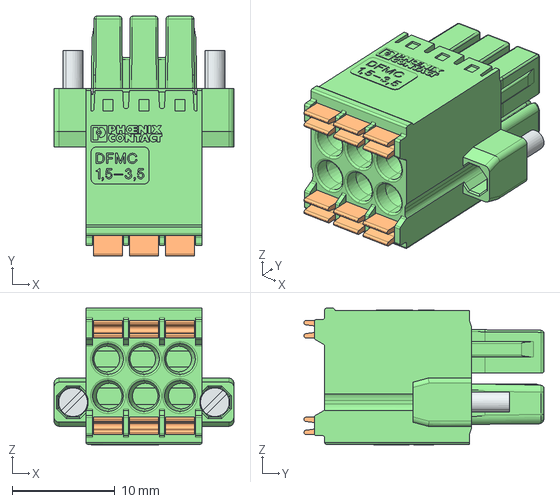
[picture p108: CAD file, 2022-07-30]
3D Models/pxc_1790302.stp
17.5 x 23.3 x 13.3 mm
DFMC-1.5_Schraube.1.1.2 x 2
DFMC_1.5-3-STF-3.5
