ericboxer/KiCad---BoxLib/3D Models/Wurth 2_54 2 Pos Jumper 60900213421.stp

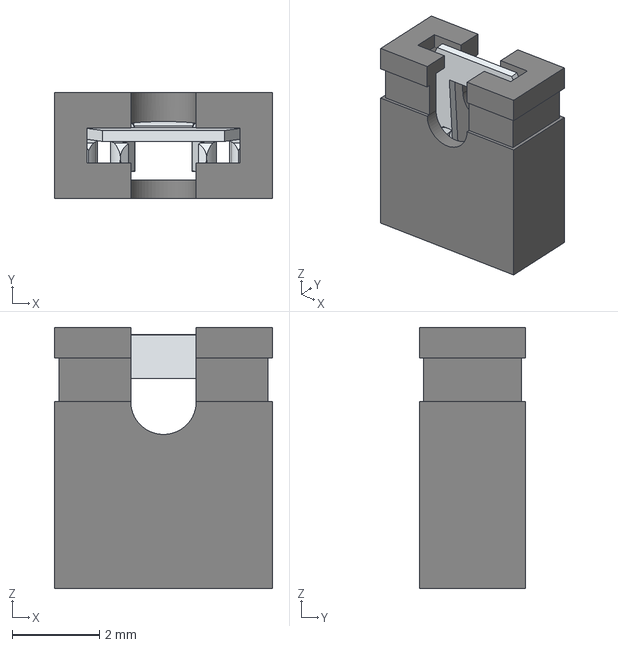
[picture p109: CAD file, 2022-07-30]
3D Models/Wurth 2_54 2 Pos Jumper 60900213421.stp
5.00 x 2.44 x 5.98 mm
