ericboxer/KiCad---BoxLib/3D Models/pxc_1952270.stp

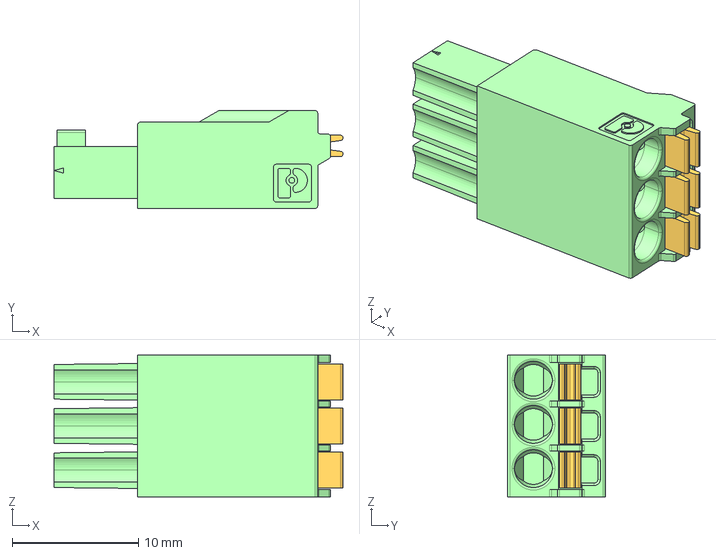
[picture p110: CAD file, 2022-07-30]
3D Models/pxc_1952270.stp
22.9 x 7.75 x 11.3 mm
