ericboxer/KiCad---BoxLib/3D Models/TSM-107-01-L-SV.stp

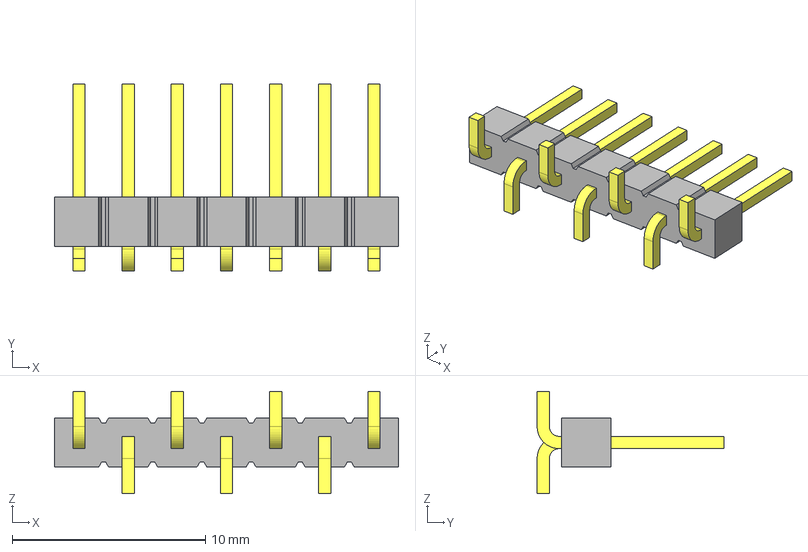
[picture p111: CAD file, 2022-03-31]
3D Models/TSM-107-01-L-SV.stp
17.8 x 9.65 x 5.28 mm
_TSM-107-01-SV_body
_T-1S6-16(-01-7-SV)
