ericboxer/KiCad---BoxLib/3D Models/TSM-111-01-L-SV.stp

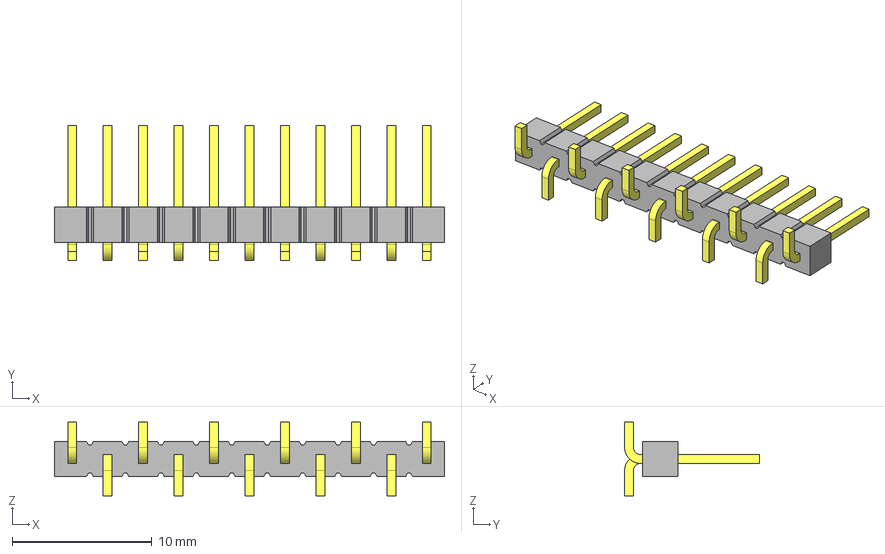
[picture p112: CAD file, 2022-03-31]
3D Models/TSM-111-01-L-SV.stp
27.9 x 9.65 x 5.28 mm
_TSM-111-01-SV_body
_T-1S6-16(-01-11-SV)
