ericboxer/KiCad---BoxLib/3D Models/TSW-107-07-G-S.stp

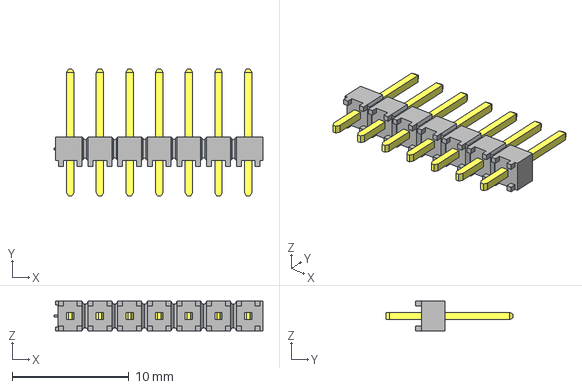
[picture p113: CAD file, 2022-03-28]
3D Models/TSW-107-07-G-S.stp
17.9 x 10.9 x 2.54 mm
_TSW-107-07-G-S_body
_T-1S6-07-TSW-1-07-7-S
