ericboxer/KiCad---BoxLib/3D Models/Littelfuse_0154.500DRT.step

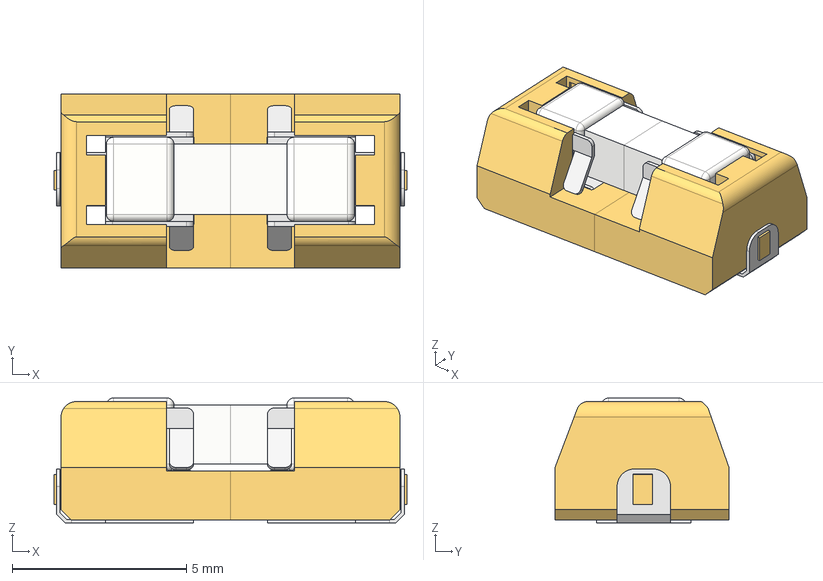
[picture p114: CAD file, 2022-03-28]
3D Models/Littelfuse_0154.500DRT.step
10.1 x 5.00 x 3.59 mm
Komponente1
Komponente2
Komponente3
Komponente4
