ericboxer/KiCad---BoxLib/3D Models/Adafruit-4383.step

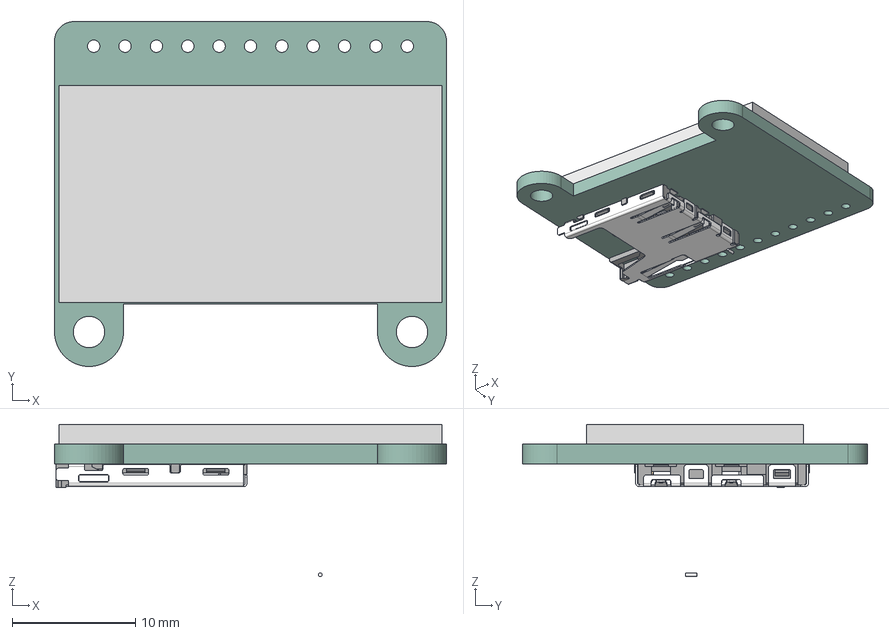
[picture p115: CAD file, 2022-03-28]
3D Models/Adafruit-4383.step
31.8 x 27.9 x 12.3 mm
Taoboa ZJY114IPS 1.14" Screen
Board
ÇÐ³ý-ÀÉì2[2]
ÇÐ³ý-ÀÉì-±¡± Ú2
