ericboxer/KiCad---BoxLib/3D Models/qtpy2040.step

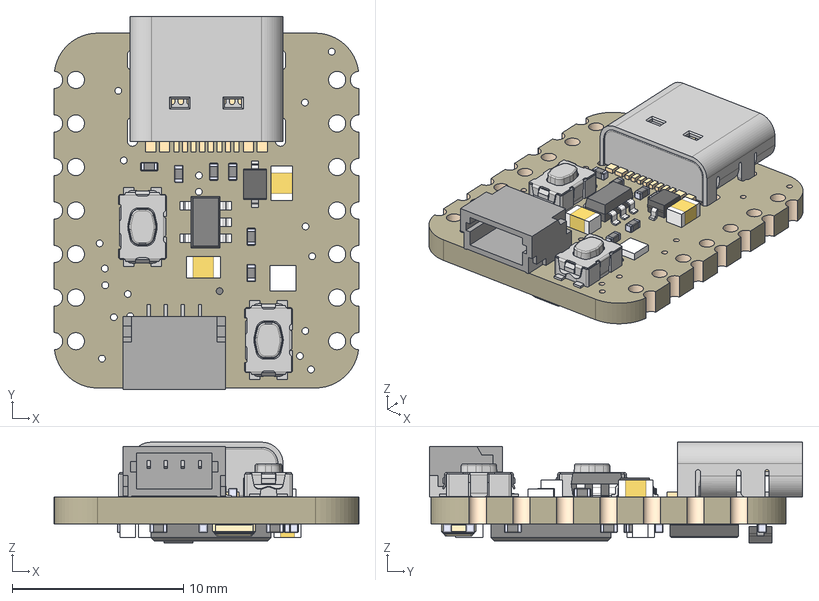
[picture p116: CAD file, 2022-03-28]
3D Models/qtpy2040.step
17.8 x 21.8 x 5.87 mm
Board
10uF x 2
STEMMA_I2C_QTSKINNY
AP2112K-3.3
WS2812B_SK6805_1515
NSR0320 x 2
8MB QSPI Flash
1K x 17
1uF x 3
USB Type C
RP2040_QFN56
KMR2 x 2
12MHZ
