ericboxer/KiCad---BoxLib/3D Models/LTST-C155GEKT.STEP

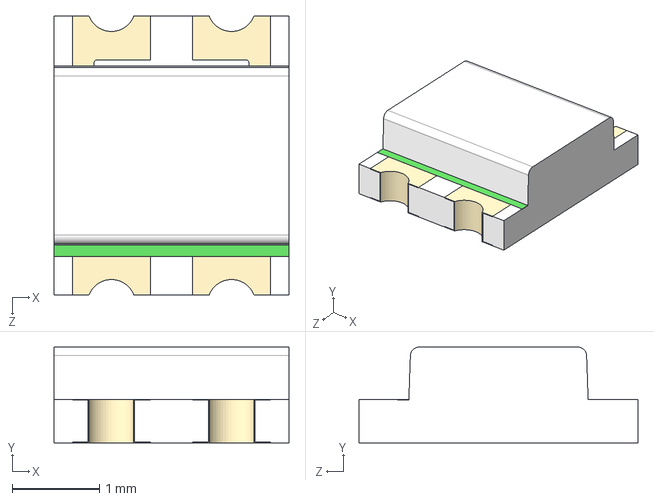
[picture p117: CAD file, 2022-03-28]
3D Models/LTST-C155GEKT.STEP
2.70 x 1.10 x 3.20 mm
