ericboxer/KiCad---BoxLib/3D Models/qtpy.step

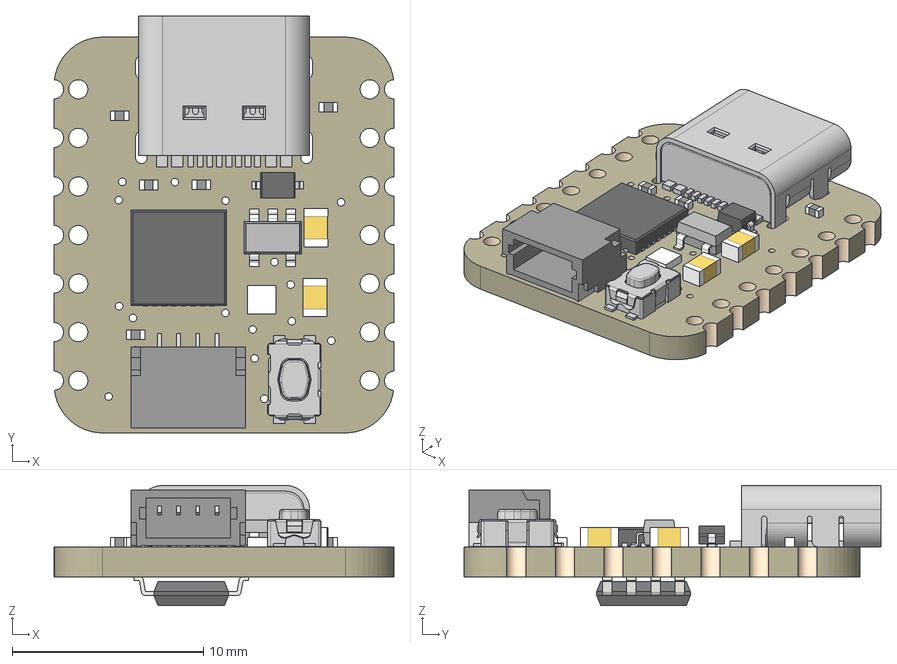
[picture p118: CAD file, 2022-03-28]
3D Models/qtpy.step
17.8 x 21.8 x 6.28 mm
Board
10uF x 2
reset
ATSAMD21E
TPB1,27
5.1K x 5
USB TYPE C
STEMMA_I2C_QTSKINNY
AP2112K-3.3
WS2812B_SK6805_1515
NSR0320
SOIC8_150MIL
