ericboxer/KiCad---BoxLib/3D Models/Wago 2060-452_998-404.stp

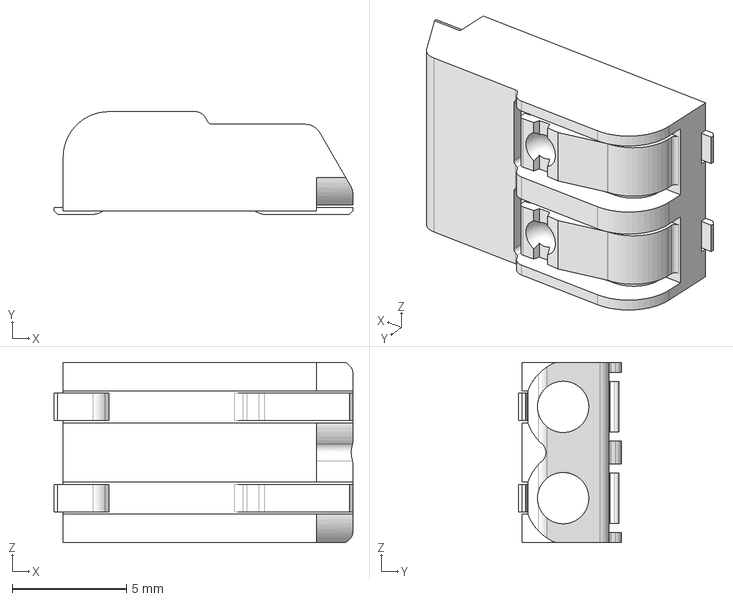
[picture p119: CAD file, 2022-03-28]
3D Models/Wago 2060-452_998-404.stp
13.1 x 4.50 x 7.90 mm
