ericboxer/KiCad---BoxLib/3D Models/TSW-111-07-G-S.stp

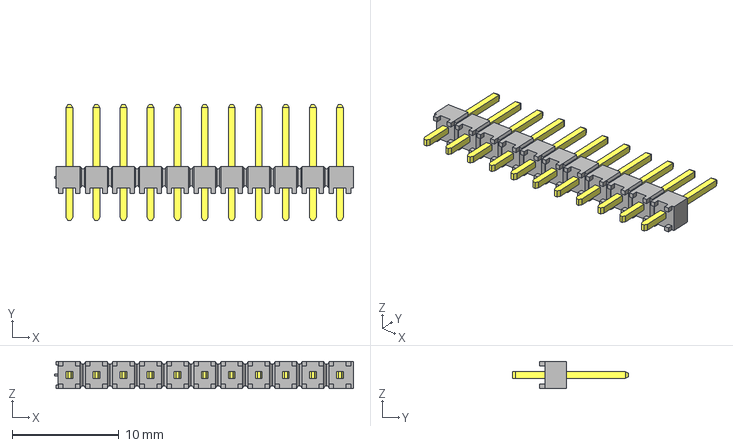
[picture p120: CAD file, 2022-03-28]
3D Models/TSW-111-07-G-S.stp
28.1 x 10.9 x 2.54 mm
_TSW-111-07-G-S_body
_T-1S6-07-TSW-1-07-11-S
