ericboxer/KiCad---BoxLib/3D Models/Molex 0532614002.step

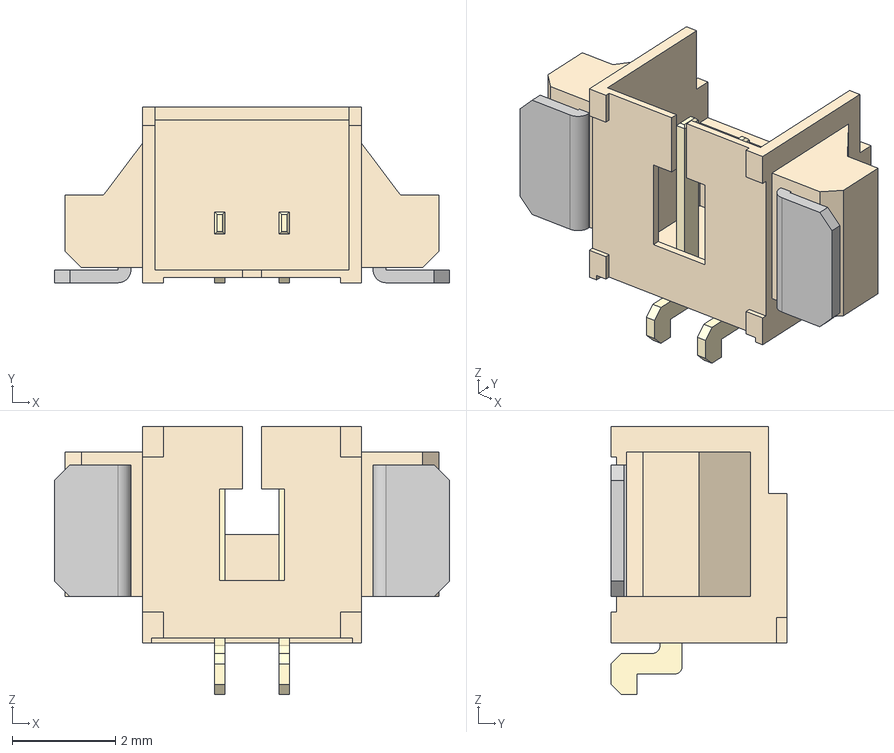
[picture p121: CAD file, 2022-03-28]
3D Models/Molex 0532614002.step
7.65 x 3.40 x 5.20 mm
Case
Wing
Pins
