ericboxer/KiCad---BoxLib/3D Models/resistor-0805.step

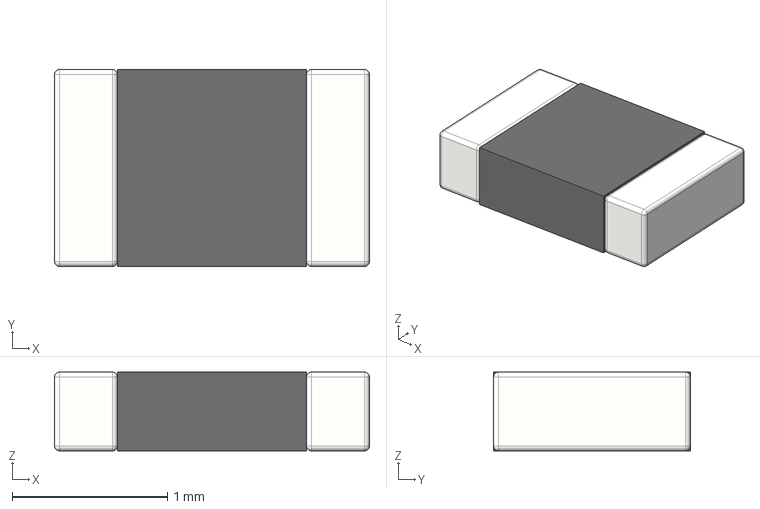
[picture p122: CAD file, 2021-12-07]
3D Models/resistor-0805.step
2.03 x 1.27 x 0.508 mm
