ericboxer/KiCad---BoxLib/3D Models/capacitor-1206.step

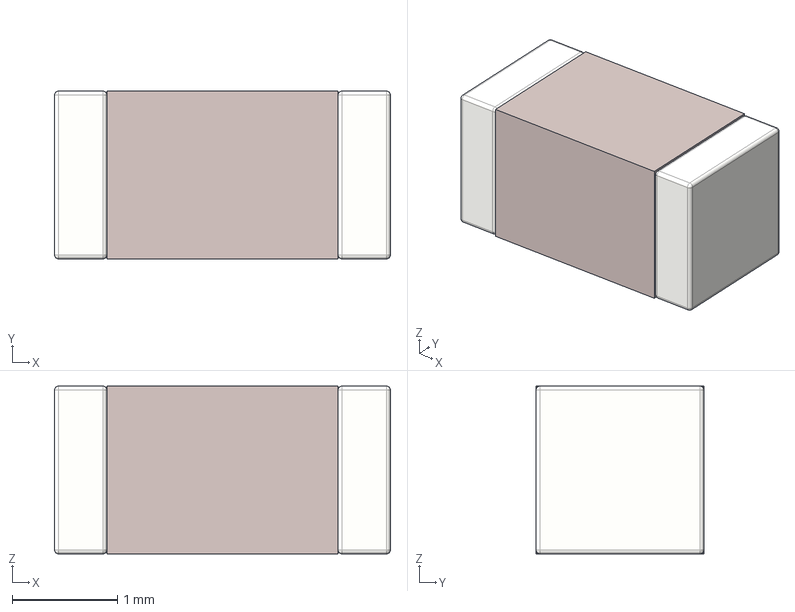
[picture p123: CAD file, 2021-12-01]
3D Models/capacitor-1206.step
3.20 x 1.60 x 1.60 mm
