ericboxer/KiCad---BoxLib/3D Models/MOV-0805.step

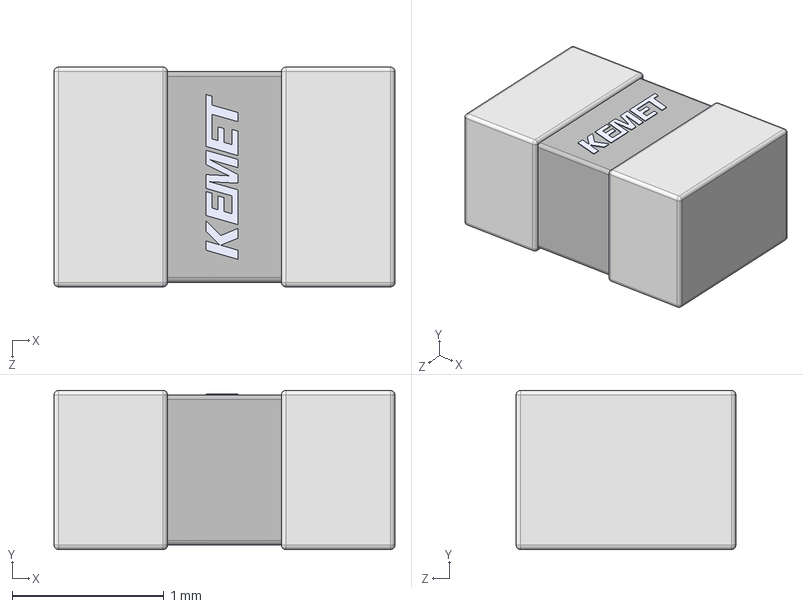
[picture p124: CAD file, 2021-11-29]
3D Models/MOV-0805.step
2.25 x 1.05 x 1.45 mm
