ericboxer/KiCad---BoxLib/3D Models/LED-0805.step

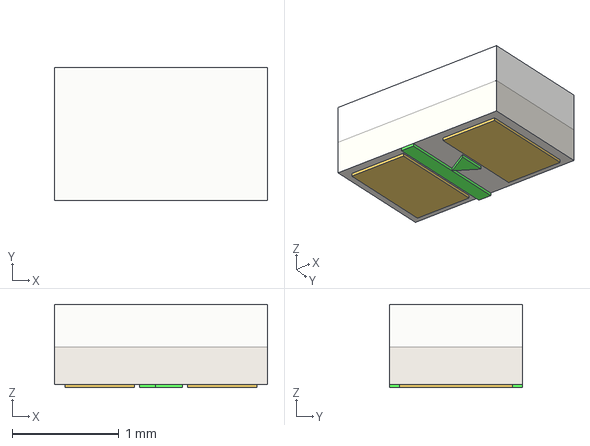
[picture p125: CAD file, 2021-11-29]
3D Models/LED-0805.step
2.00 x 1.25 x 0.78 mm
