ericboxer/KiCad---BoxLib/3D Models/sot223.step

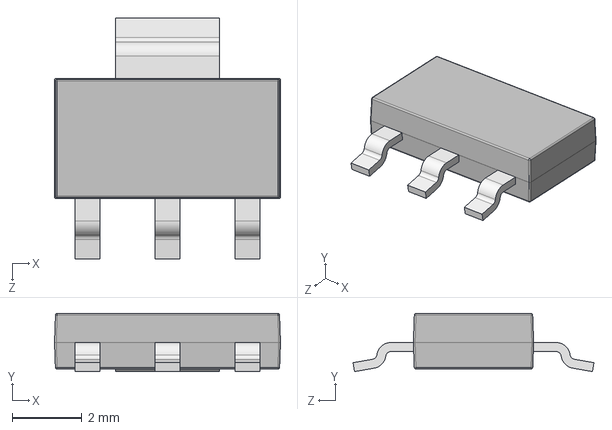
[picture p126: CAD file, 2021-11-16]
3D Models/sot223.step
6.50 x 1.67 x 6.93 mm
