ericboxer/KiCad---BoxLib/3D Models/3_SIP-Module-Short.step

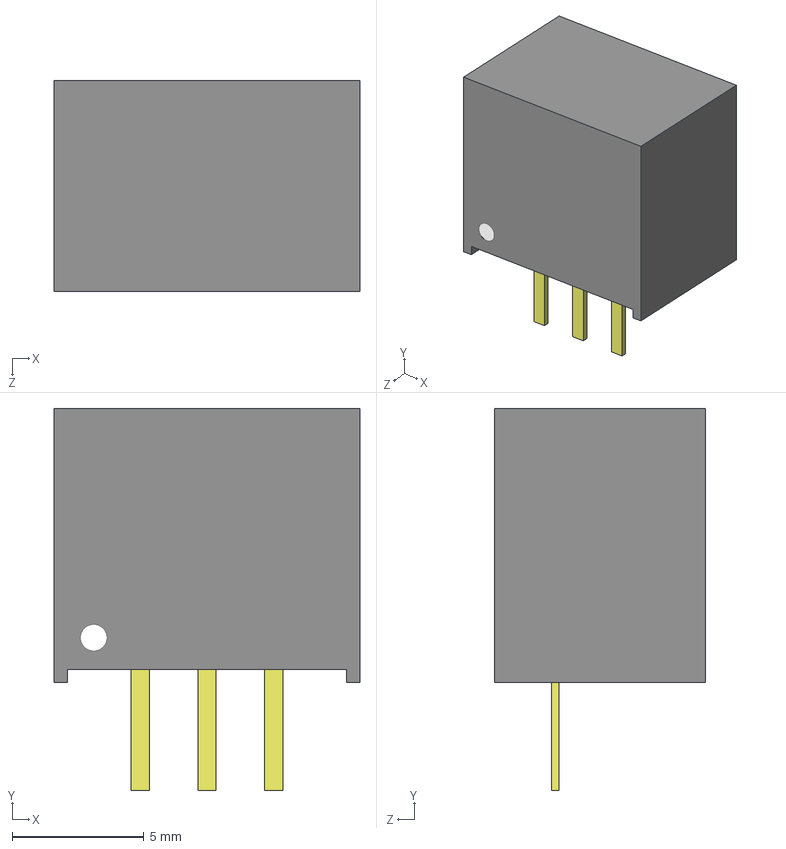
[picture p127: CAD file, 2021-11-16]
3D Models/3_SIP-Module-Short.step
11.6 x 14.5 x 8.00 mm
