ericboxer/KiCad---BoxLib/3D Models/Wire Holders v2.stl

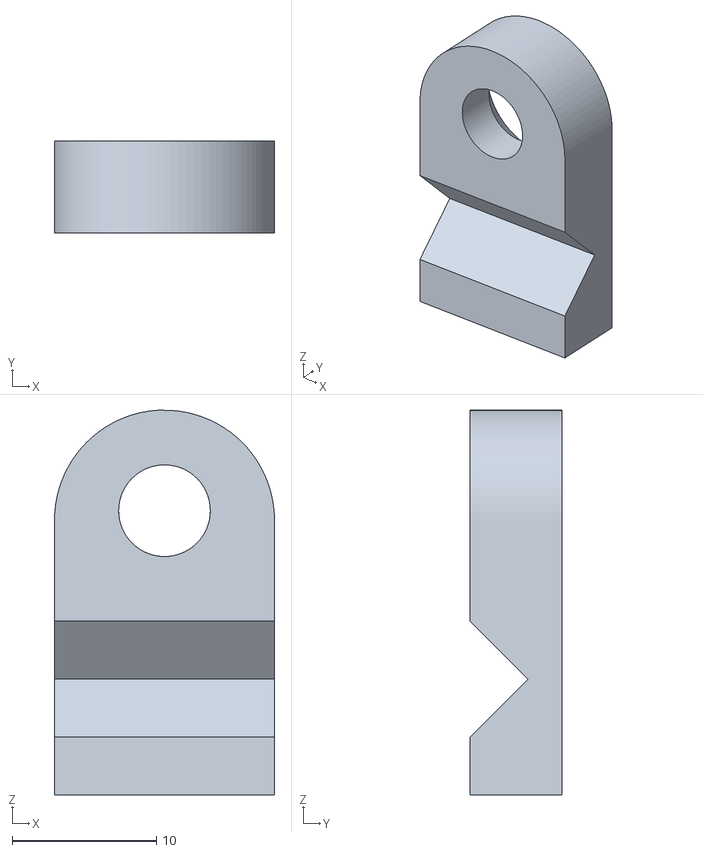
[picture p128: CAD file, 2021-11-16]
3D Models/Wire Holders v2.stl
15.2 x 6.35 x 26.7
