ericboxer/KiCad---BoxLib/3D Models/hsmt8.STEP

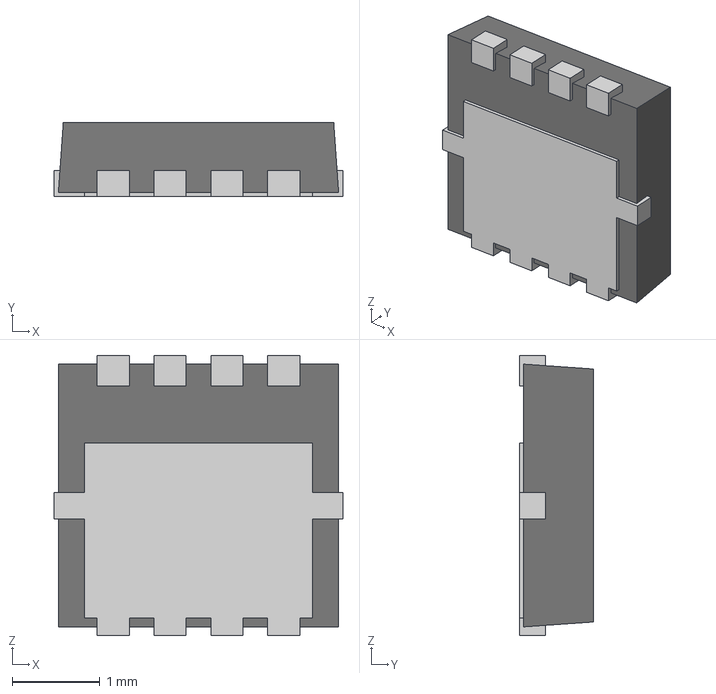
[picture p129: CAD file, 2021-09-11]
3D Models/hsmt8.STEP
3.30 x 0.85 x 3.20 mm
