ericboxer/KiCad---BoxLib/3D Models/SOT-23-6.step

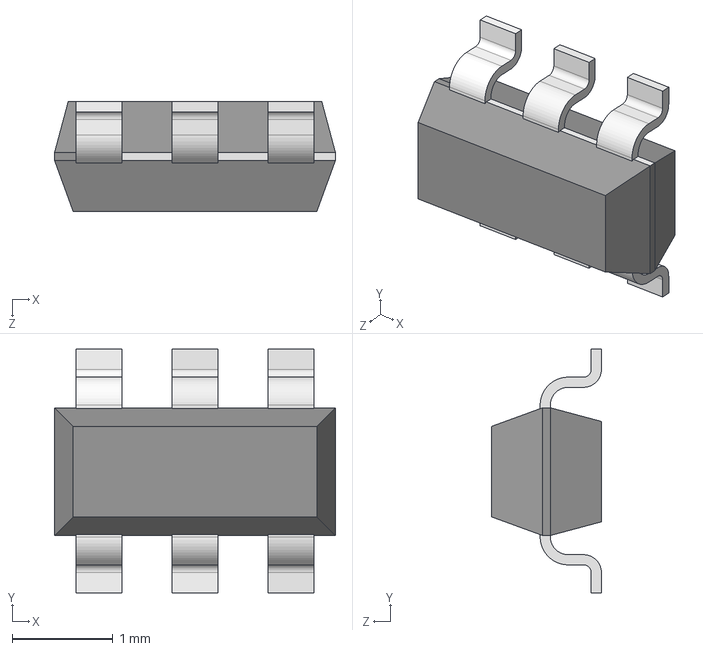
[picture p130: CAD file, 2021-09-10]
3D Models/SOT-23-6.step
2.79 x 2.43 x 1.09 mm
