ericboxer/KiCad---BoxLib/3D Models/lga-12.step

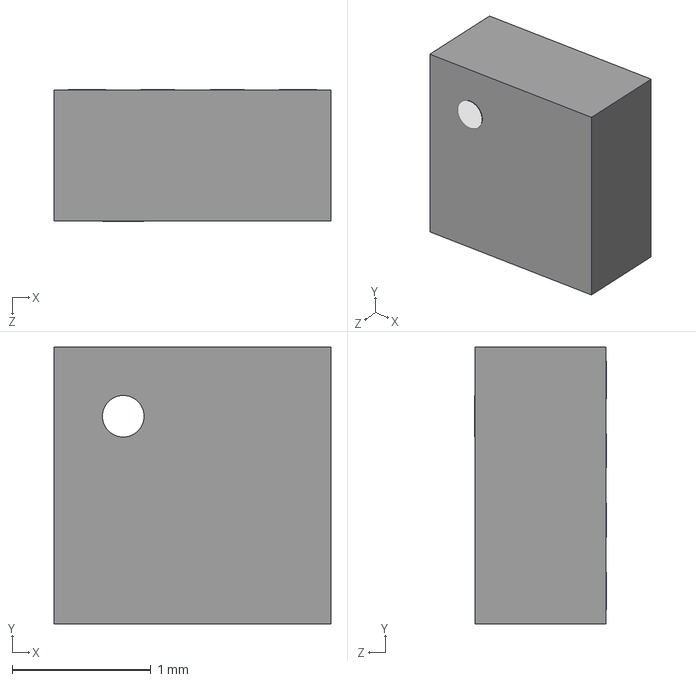
[picture p131: CAD file, 2021-09-10]
3D Models/lga-12.step
2.00 x 2.00 x 0.955 mm
