ericboxer/KiCad---BoxLib/3D Models/TO-247-2.step

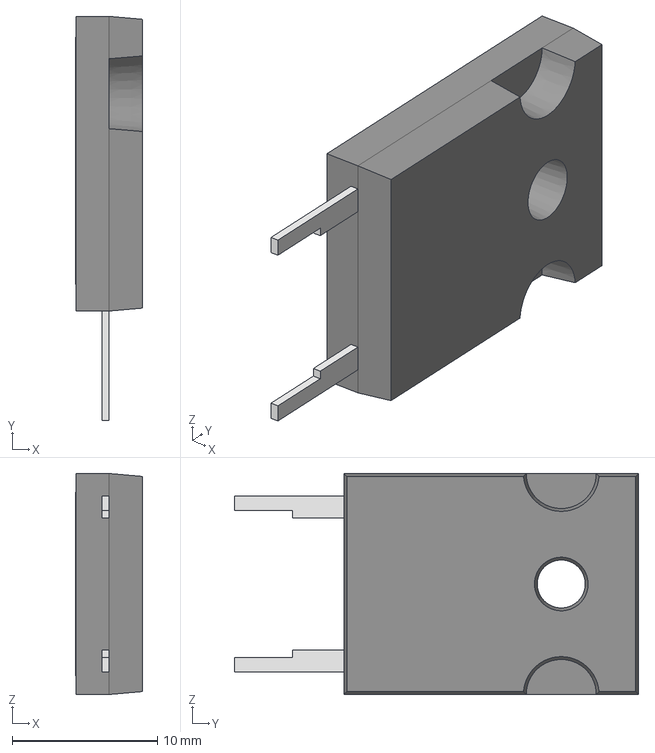
[picture p132: CAD file, 2021-08-20]
3D Models/TO-247-2.step
4.60 x 27.9 x 15.2 mm
