ericboxer/KiCad---BoxLib/3D Models/pxc_1844249_05.stp

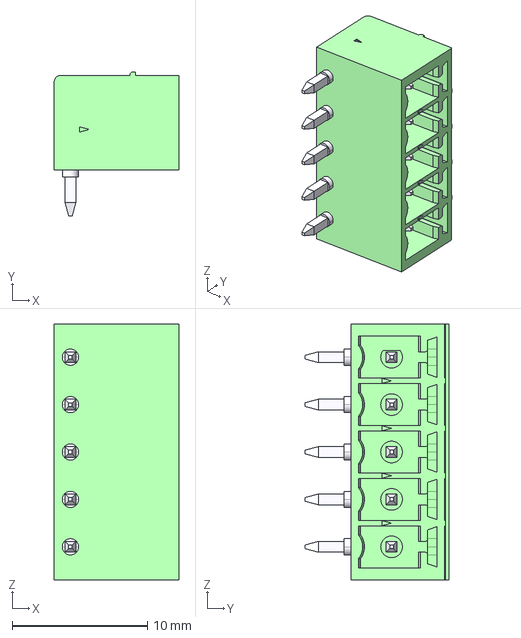
[picture p133: CAD file, 2021-08-20]
3D Models/pxc_1844249_05.stp
9.20 x 10.7 x 18.9 mm
