ericboxer/KiCad---BoxLib/3D Models/pxc_1790483.stp

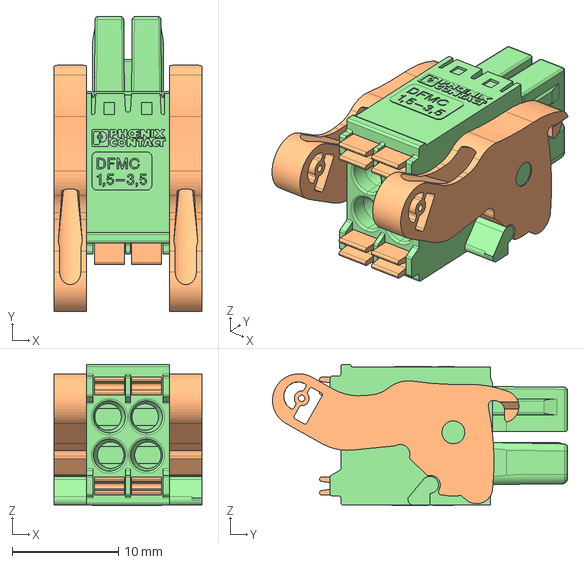
[picture p134: CAD file, 2021-08-20]
3D Models/pxc_1790483.stp
13.9 x 27.8 x 13.3 mm
