ericboxer/KiCad---BoxLib/3D Models/DO-214AC.step

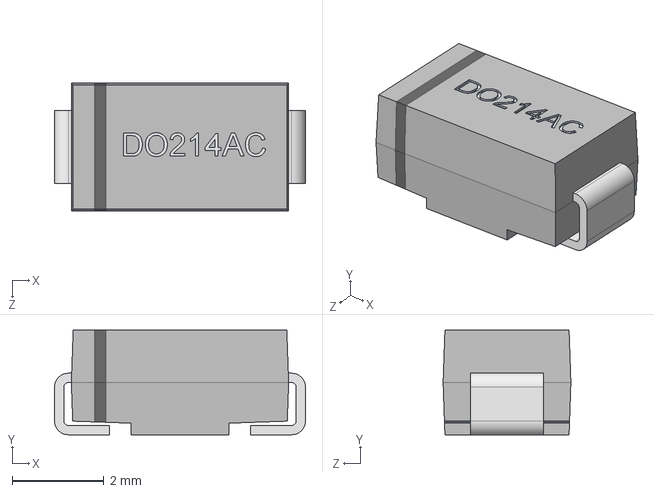
[picture p135: CAD file, 2021-08-20]
3D Models/DO-214AC.step
5.49 x 2.29 x 2.79 mm
