ericboxer/KiCad---BoxLib/3D Models/QFN-56.step

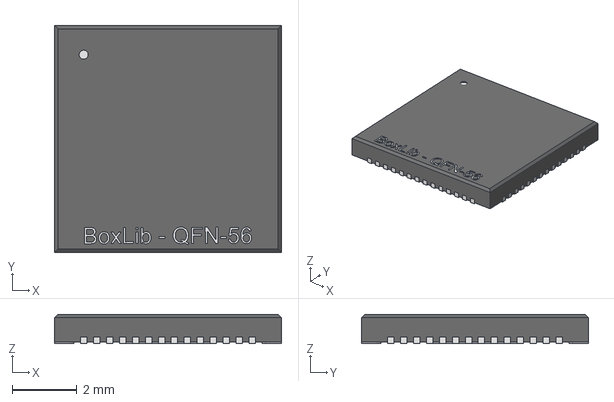
[picture p136: CAD file, 2021-08-20]
3D Models/QFN-56.step
7.00 x 7.00 x 0.9 mm
