ericboxer/KiCad---BoxLib/3D Models/pxc_5442206.stp

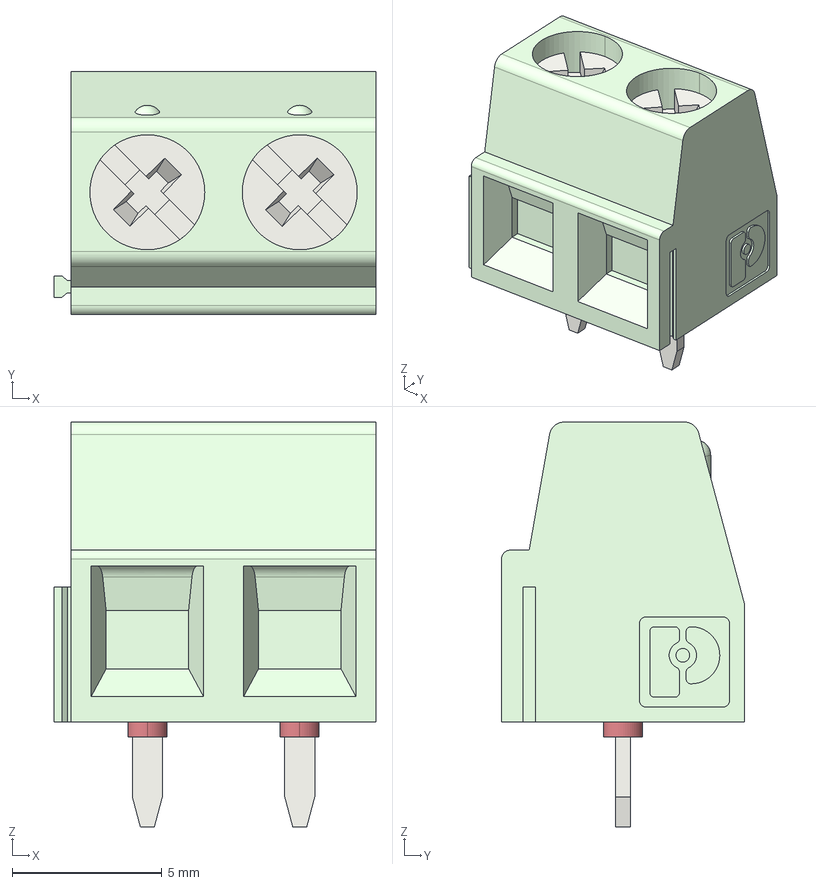
[picture p137: CAD file, 2021-03-14]
3D Models/pxc_5442206.stp
10.7 x 8.10 x 13.5 mm
