ericboxer/KiCad---BoxLib/3D Models/cap-5-12_5-2_red.step

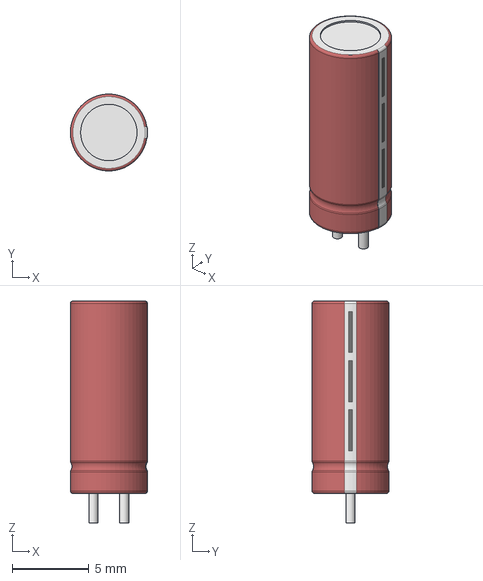
[picture p138: CAD file, 2021-03-14]
3D Models/cap-5-12_5-2_red.step
5.02 x 4.99 x 14.4 mm
