ericboxer/KiCad---BoxLib/3D Models/Cap-12_5-20_5_blue.step

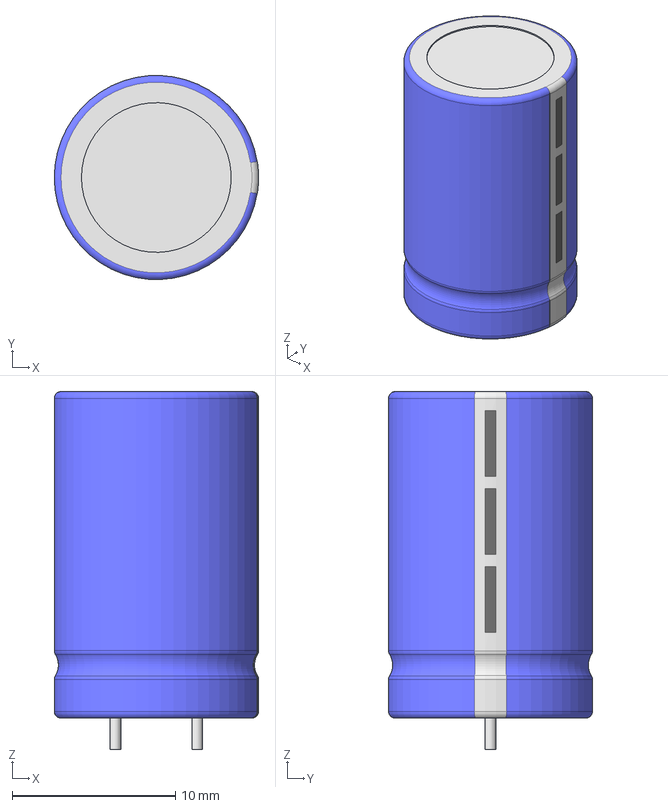
[picture p139: CAD file, 2021-03-14]
3D Models/Cap-12_5-20_5_blue.step
12.5 x 12.5 x 21.9 mm
