ericboxer/KiCad---BoxLib/3D Models/Bel-Fuse-0ZRS1000FF.step

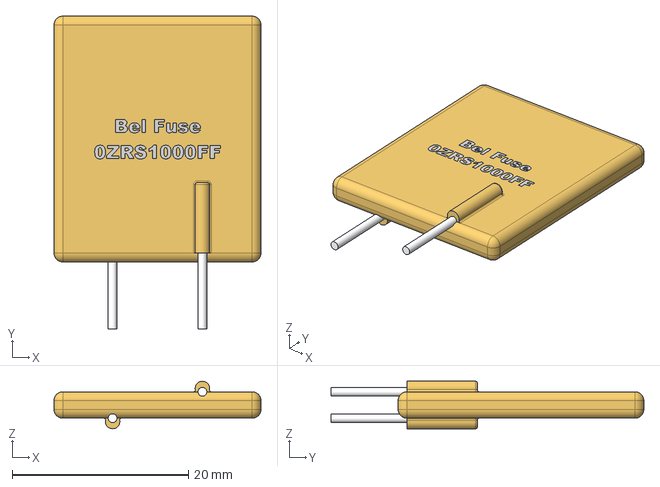
[picture p140: CAD file, 2021-03-14]
3D Models/Bel-Fuse-0ZRS1000FF.step
23.5 x 35.5 x 5.40 mm
