ericboxer/KiCad---BoxLib/3D Models/Cap-12_5-22_5_black.step

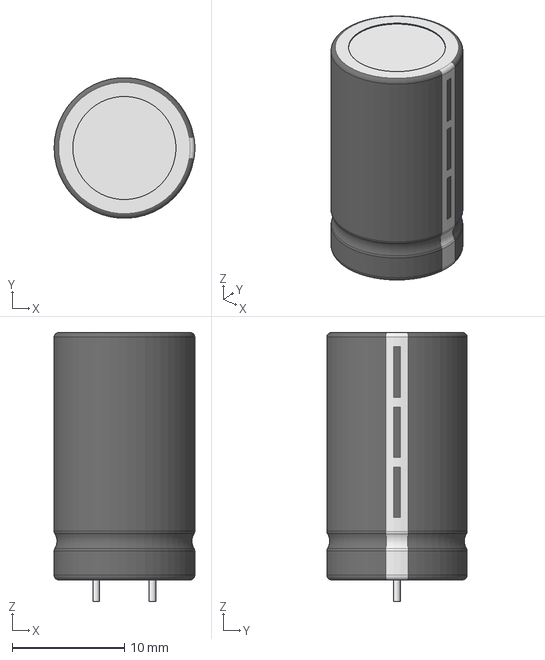
[picture p141: CAD file, 2021-03-14]
3D Models/Cap-12_5-22_5_black.step
12.5 x 12.5 x 23.9 mm
