ericboxer/KiCad---BoxLib/3D Models/CHB350.STEP

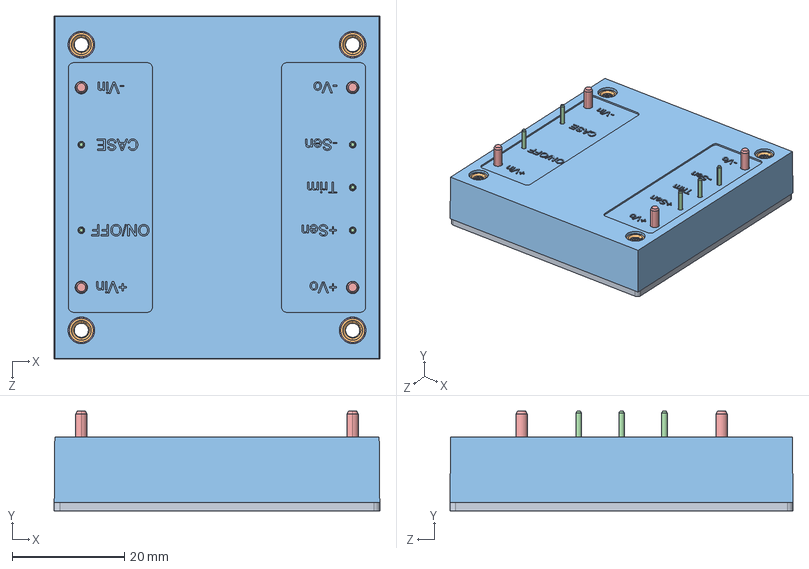
[picture p142: CAD file, 2021-01-27]
3D Models/CHB350.STEP
57.9 x 17.7 x 61.0 mm
PCB 鋁基板 1.5mm 103,04,17
CHB150W M3x12.6ｻﾉｬWG75J1190011 ･ﾜｷNｹﾏ 103,04,17 x 4
CHB150W CASE HB-6 (M-C425-02-M)G5117110012(加刻字)
ｶ鷄IN G7211372129 ･ﾜｷNｹﾏ 103,04,17 x 5
CHB200W-48S05ｶ鷄IN｣p3x｣p2x16.5mm(M-H019-01-P)G7211362004 x 4
CHB350 ﾄ鮨ｦ･ﾜｷNｹﾏ 103,04,17
