ericboxer/KiCad---BoxLib/3D Models/pxc_1787014.stp

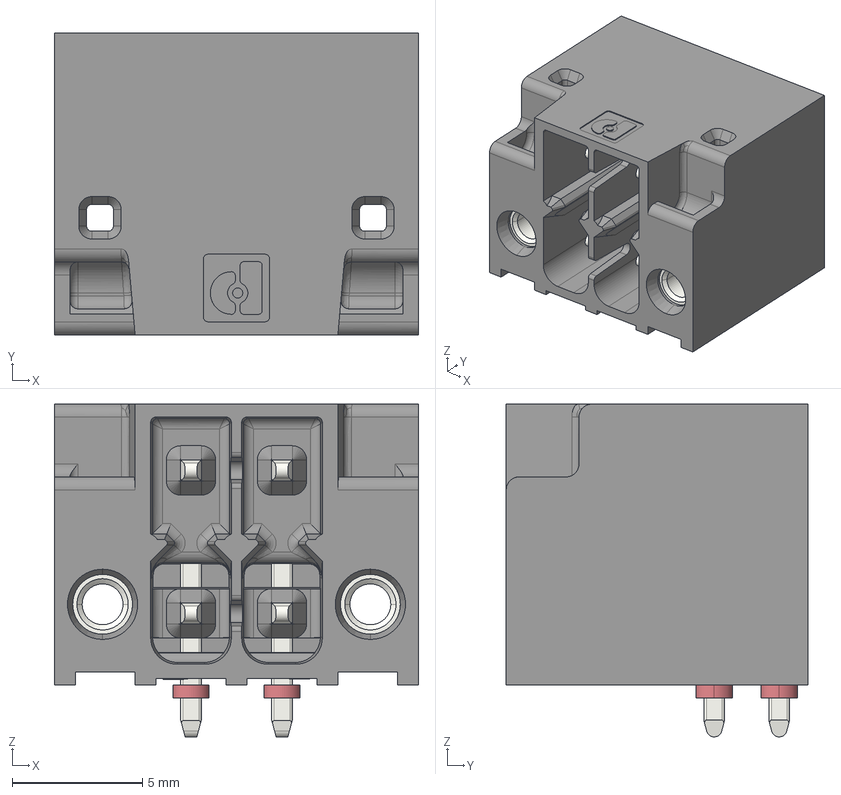
[picture p143: CAD file, 2021-01-27]
3D Models/pxc_1787014.stp
14.0 x 11.6 x 12.8 mm
Bohrloch x 4
DMC-1.5-2-G1-3.5-LR-THR
