ericboxer/KiCad---BoxLib/3D Models/TE-PCFN-1xxH2MG v3.step

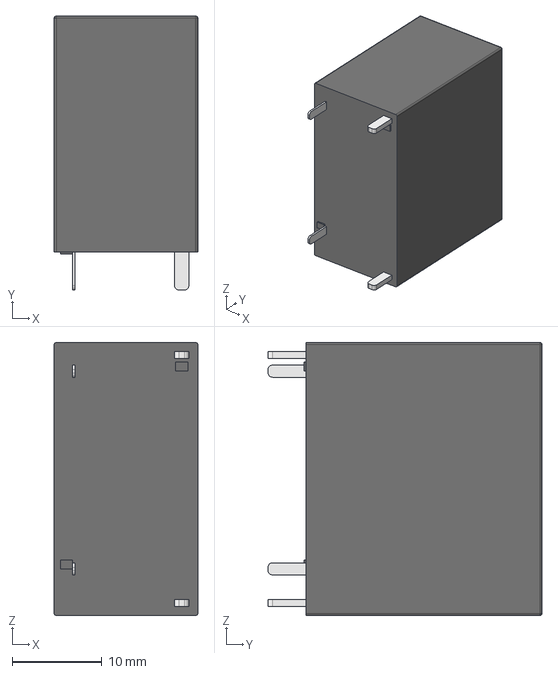
[picture p144: CAD file, 2021-01-27]
3D Models/TE-PCFN-1xxH2MG v3.step
16.0 x 30.5 x 30.4 mm
