ericboxer/KiCad---BoxLib/3D Models/SC-70.stp

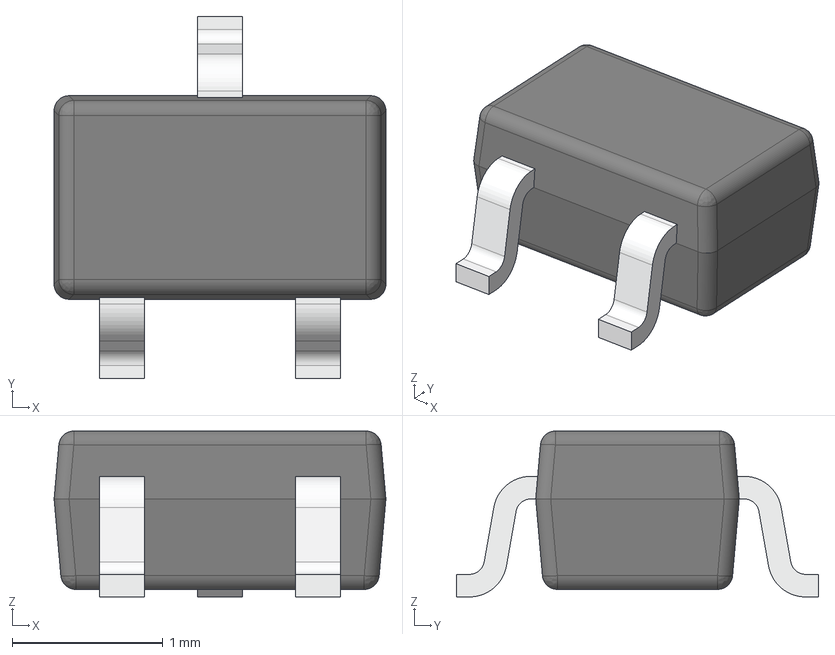
[picture p145: CAD file, 2021-01-27]
3D Models/SC-70.stp
2.20 x 2.40 x 1.10 mm
