ericboxer/KiCad---BoxLib/3D Models/phoenix-1787399.stp

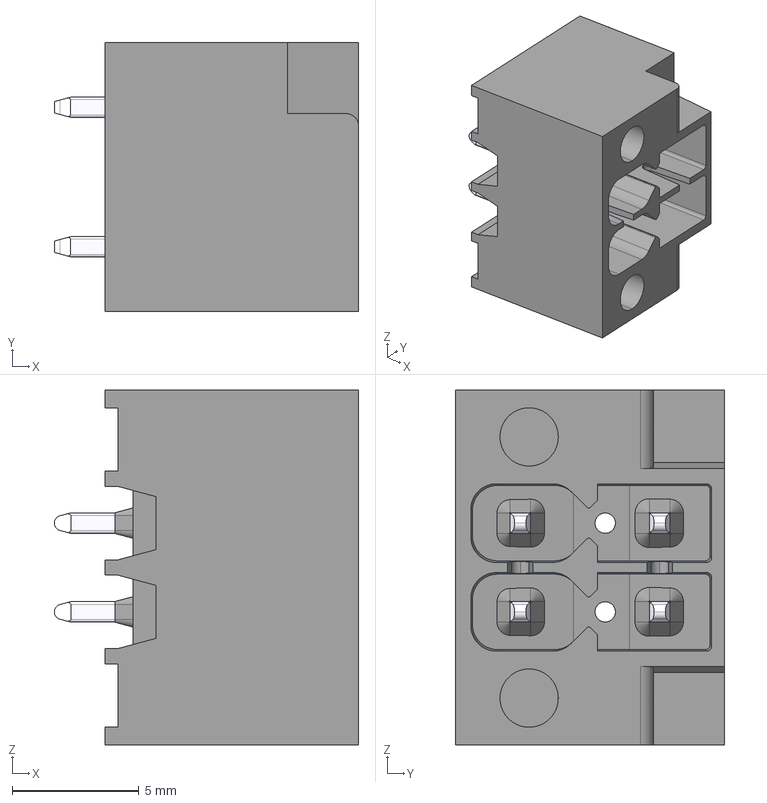
[picture p146: CAD file, 2021-01-27]
3D Models/phoenix-1787399.stp
12.0 x 10.6 x 14.0 mm
