ericboxer/KiCad---BoxLib/3D Models/Harting-IX-A-Horz.stp

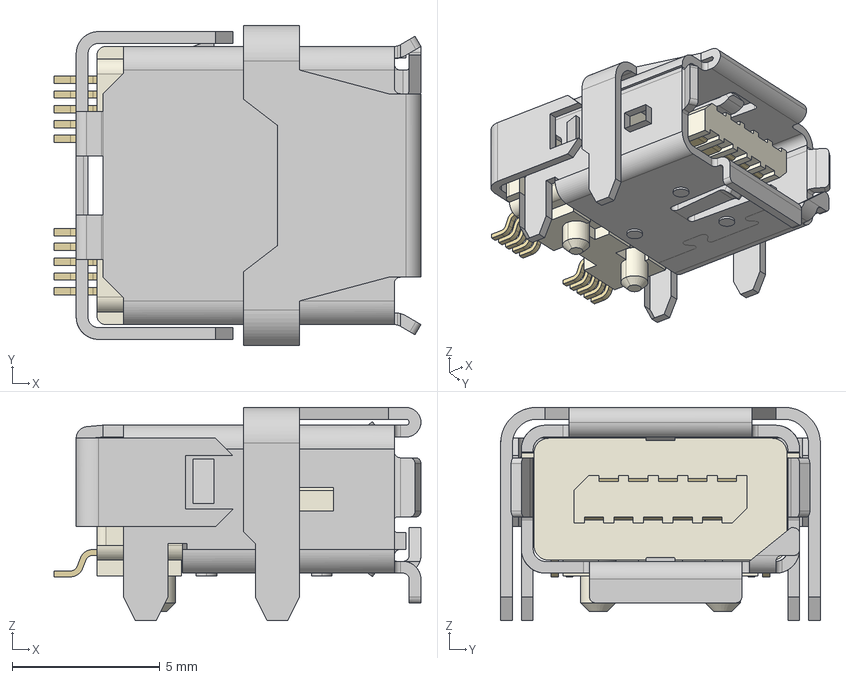
[picture p147: CAD file, 2021-01-10]
3D Models/Harting-IX-A-Horz.stp
12.4 x 10.8 x 7.20 mm
