ericboxer/KiCad---BoxLib/3D Models/phoenix-1778780.step

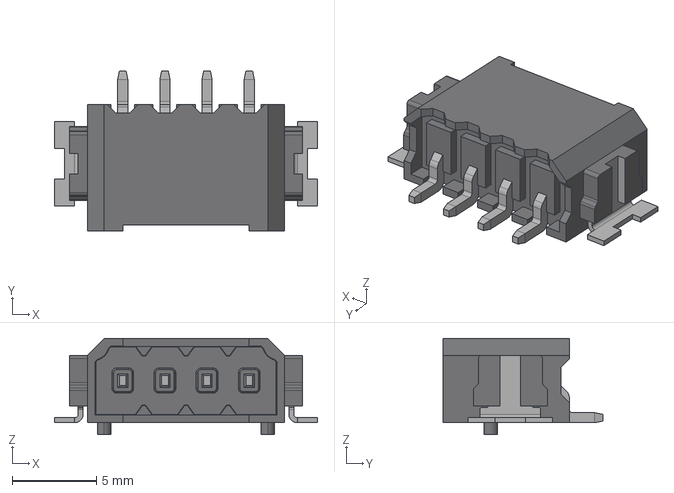
[picture p148: CAD file, 2021-01-10]
3D Models/phoenix-1778780.step
15.6 x 9.50 x 5.70 mm
