ericboxer/KiCad---BoxLib/3D Models/CUI_DEVICES_PJ-001AH-67.step

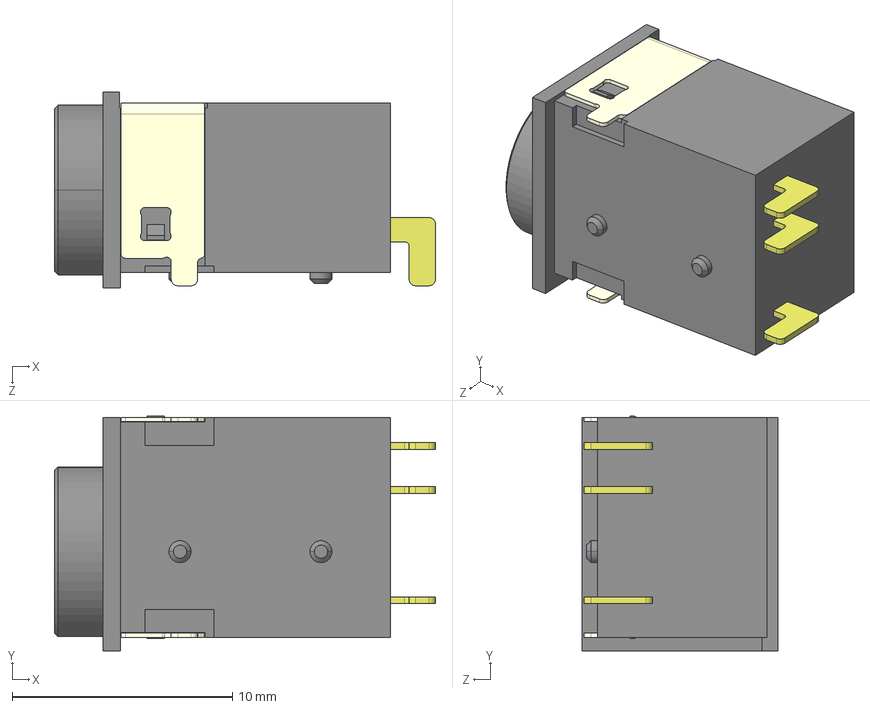
[picture p149: CAD file, 2020-10-04]
3D Models/CUI_DEVICES_PJ-001AH-67.step
17.3 x 10.7 x 8.90 mm
