ericboxer/KiCad---BoxLib/(list of files, cad)

Other CAD files:
3D Models/Keystop 5009 Yellow.STEP
3D Models/Cap-12_5-22_5_blue.step
3D Models/CUI_DEVICES_PJ-001BH-67.step
3D Models/12401598E4#2.STEP
3D Models/1786840.stp
3D Models/1787027.stp
3D Models/1988600000.stp
3D Models/2920L185.step
3D Models/430250208.stp
3D Models/430450201.stp
3D Models/61300211121.stp
3D Models/74650073.stp
3D Models/DIP8.step
3D Models/DPAK TO-255.step
3D Models/ECS-120-12-36Q-CWY-TR.step
3D Models/LED 5mm.STEP
3D Models/LED 5mm_A.stp
3D Models/LQFP64.step
3D Models/LTST-C191TBKT.STEP
3D Models/LittleFuse Nano2 157.step
3D Models/M50-3530342.STEP
3D Models/NDK_NX3215SA.step
3D Models/SOT-23-3.step
3D Models/SOT-23-5.step
3D Models/T0-92-3.step
3D Models/TO-92-3 Formed.step
3D Models/TO247-2.STEP
3D Models/TSSOP-28.STEP
3D Models/TSSOP20.step
3D Models/USB4105-GF-A.STEP
3D Models/USB4110-GF-A.STEP
3D Models/XRCGB.step
3D Models/capacitor-0603.step
3D Models/capacitor-0805.step
3D Models/capacitor-can-b.step
3D Models/capacitor-can-c.step
3D Models/capacitor-can-d.step
3D Models/capacitor-can-d8.step
3D Models/capacitor-can-e.step
3D Models/lqfp32.step
3D Models/qfn-32-5x5.step
3D Models/resistor-0603.step
3D Models/soic8.step
3D Models/sot-23-6.stp
