ericboxer/KiCad---BoxLib/BoxLib.kicad_sch

## KiCad design BoxLib.kicad_sch (2022-03-31)

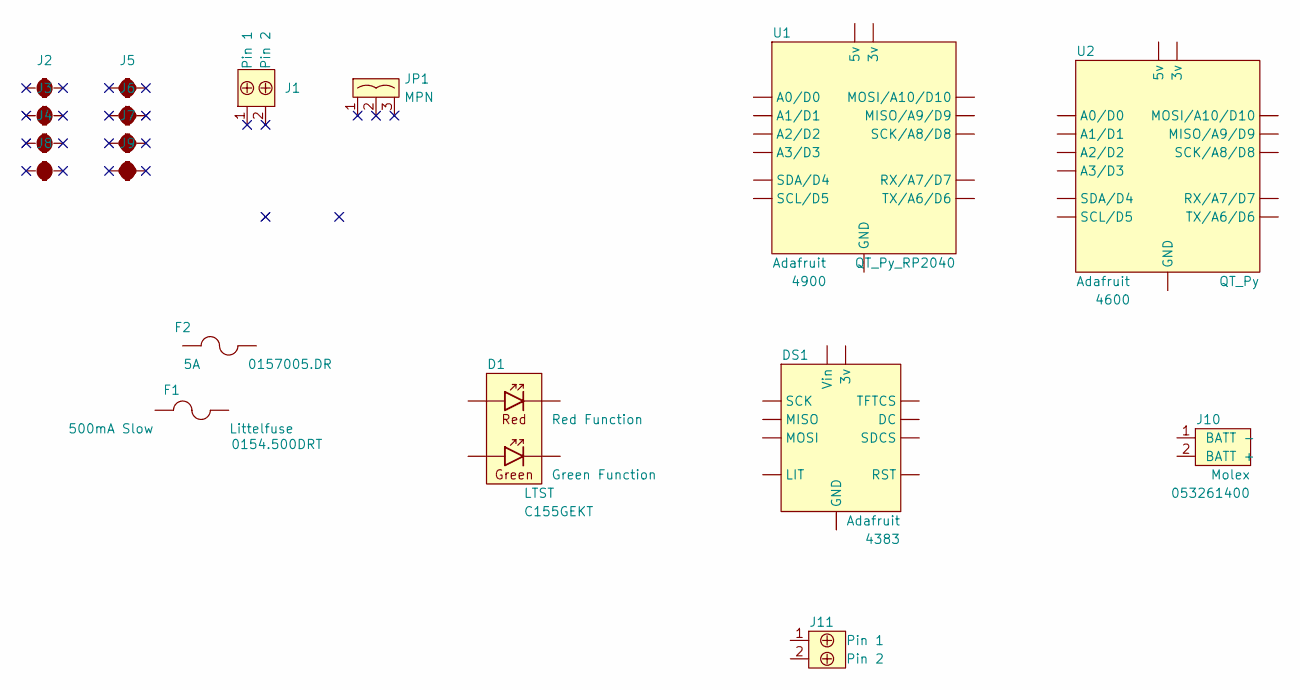
[picture p150: schematic BoxLib.kicad_sch]

Parts:
D1: MPN C155GEKT
DS1: Adafruit-4383; Adafruit-1_14-tft-display-4383; MPN 4383
F1: Littelfuse_154_0.5A_Slow; Fuse-Current-Littelfuse-Nano2_154; MPN 0154.500DRT
F2: 0157005.DR; Nano2-157
J1: Generic_2Pos_terminal_block; PTH-2-1_5mmx2mmx5mm
J2: Solder-Jumper-NO; Jumper-Solder-1mm-NO
J3: Solder-Jumper-NO; Jumper-Solder-3mm-NO
J4: Solder-Jumper-NO; Jumper-Solder-Chevron-3mm-NO
J5: Solder-Jumper-NC; Jumper-Solder-1mm-NC
J6: Solder-Jumper-NC; Jumper-Solder-3mm-NC
J7: Solder-Jumper-NC; Jumper-Solder-Chevron-3mm-NC
J8: Solder-Jumper-NO; Jumper-Solder-2mm-NO
J9: Solder-Jumper-NC; Jumper-Solder-2mm-NC
J10: Molex_2Pos_terminal_block_1.25mm-0532614002; Connector-SMD-2Pos-Molex-0532614002; MPN 053261400
J11: Generic_2Pos_terminal_block; Connector-SMD-2Pos-Wago-2060-452_998-404
JP1: Jumper-3-Pos; Header-3pos-0.5in-1.27mm-Harwin-M50-3530342; MPN MPN
U1: QT_Py_RP2040; Adafruit-QT_Py_RP2040-PTH; MPN 4900
U2: QT_Py; Adafruit-QT_Py-PTH; MPN 4600
