ericboxer/KiCad---BoxLib/(commit log)

2020-06-09 First push
    [resistor-0603.step, resistor-0805.step]
2020-06-10 Added LQFP32 footprint
    [lqfp32.step]
2020-06-10 Started STM32 Library
2020-06-11 Smaller file
    [lqfp32.step]
2020-07-02 DIP8 / 485 / SOIC / LQFP32 / STM32
    [DIP8.step, soic8.step]
2020-07-10 Added LQFP-48 Footprint
2020-07-12 Added New STM32 modules
2020-07-12 Added NDK NX3215SA
    [NDK_NX3215SA.step]
2020-07-12 Added Base XRCGB / NX3215SA
    [ECS-120-12-36Q-CWY-TR.step, XRCGB.step]
2020-07-12 Added GCT4110 FCT4105
    [USB4105-GF-A.STEP, USB4110-GF-A.STEP]
2020-07-12 Removed unused pin
2020-07-12 Added Power Symbols
2020-07-18 Added USB-UART CYC65213A
    [TSSOP-28.STEP, qfn-32-5x5.step]
2020-07-18 Added LEDs
    [LED 5mm.STEP, LED 5mm_A.stp]
2020-07-18 Added Fuses
    [LittleFuse Nano2 157.step]
2020-07-18 Added SOT23
    [SOT-23-3.step, SOT-23-5.step]
2020-07-18 Component updates
    [DPAK TO-255.step, T0-92-3.step, TO-92-3 Formed.step, TSSOP20.step, capacitor-can-b.step, capacitor-can-c.step]
2020-07-20 New Caps
    [capacitor-0603.step, capacitor-0805.step, capacitor-can-d.step, capacitor-can-d8.step, capacitor-can-e.step]
2020-10-03 Added STM32F405RG
    [LQFP64.step]
2020-10-04 Added Footprints
    [12401598E4#2.STEP, LTST-C191TBKT.STEP]
2020-10-04 New Connectors
    [CUI_DEVICES_PJ-001AH-67.step, CUI_DEVICES_PJ-001BH-67.step]
2021-01-08 Added Pheonix
    [pxc_1787014.stp]
2021-01-10 Added Connectors
    [Harting-IX-A-Horz.stp, phoenix-1778780.step]
2021-01-26 Added CHB350 3d model
    [CHB350.STEP]
2021-01-27 Added comps
    [SC-70.stp, TE-PCFN-1xxH2MG v3.step, phoenix-1787399.stp]
2021-01-27 New Stud
    [74650073.stp]
2021-01-27 Added 2 pos jumper
    [61300211121.stp]
2021-03-14 Added new Models
    [Bel-Fuse-0ZRS1000FF.step, Cap-12_5-20_5_blue.step, Cap-12_5-22_5_black.step, Cap-12_5-22_5_blue.step, cap-5-12_5-2_red.step, pxc_5442206.stp]
2021-08-20 Added. Raspberry Pi RP2040
    [QFN-56.step]
2021-08-20 Added parts
    [1988600000.stp, 2920L185.step, DO-214AC.step, M50-3530342.STEP, TO-247-2.step, TO247-2.STEP, pxc_1790483.stp, pxc_1844249_05.stp]
2021-08-31 Added sunLED XZVS54 series
    [LED-0805.step]
2021-09-10 Added LGA-12
    [lga-12.step]
2021-09-10 Added ST23-6
    [SOT-23-6.step]
2021-09-10 Added Silkscreen border
2021-09-11 Added HSMT8 (Power 8 VDFN)
    [hsmt8.STEP]
2021-09-11 Adjust footprint filters
2021-11-16 New parts
    [3_SIP-Module-Short.step, Wire Holders v2.stl, sot223.step]
2021-11-29 0805 LED
    [LED-0805.step]
2021-11-29 Added MOV-0805
    [MOV-0805.step]
2021-12-01 Added 1206 Capacitor
    [capacitor-1206.step]
2021-12-07 Updated footprint to be cleaner
2021-12-07 Added 4-40 mounting hole
2021-12-07 updated r-0805 package
    [resistor-0805.step]
2021-12-28 Added working files
    [BoxLib.kicad_pcb, BoxLib.kicad_sch]
2021-12-28 Migrated Symbols from Legacy to KiCad Symbols
2021-12-29 Added Solder Jumpers
2021-12-29 Added Purpose to some standard LEDs
2021-12-29 Added dynamic current display
2021-12-29 Added pin labels
2021-12-29 General 6.0 Updates
    [BoxLib.kicad_pcb, BoxLib.kicad_sch]
2022-02-08 Added LittelFuse 154 series
    [BoxLib.kicad_pcb, Littelfuse_0154.500DRT.step]
2022-02-09 Updated some fuses
    [BoxLib.kicad_pcb, BoxLib.kicad_sch]
2022-03-25 Added a couple of Adafruit QT Pys
    [BoxLib.kicad_pcb, BoxLib.kicad_sch, TSW-107-07-G-S.stp, qtpy.step, qtpy2040.step]
2022-03-25 Added Adafruit 4383 Display
    [Adafruit-4383.step, BoxLib.kicad_sch, TSW-111-07-G-S.stp]
2022-03-25 Added New connectors
    [Molex 0532614002.step, Wago 2060-452_998-404.stp]
2022-03-25 Lipo Charger
2022-03-28 Updats to linking, NEW LED
    [BoxLib.kicad_pcb, LTST-C155GEKT.STEP]
2022-03-28 Fixed pin names
2022-03-28 adjusted footprint to be smaller
2022-03-28 Renamed power pins
2022-03-31 Added PTH varients of devices
    [BoxLib.kicad_pcb, BoxLib.kicad_sch, TSM-107-01-L-SV.stp, TSM-111-01-L-SV.stp]
2022-03-31 Added SMD varients of devices
    [BoxLib.kicad_pcb, BoxLib.kicad_sch, TSM-107-01-L-SV.stp, TSM-111-01-L-SV.stp]
2022-04-06 Added Standoffs
    [dfn1006-2.step]
2022-04-06 Added WURTH Long USB Recep
    [Wurth 632723100011.stp]
2022-04-18 Added 6pos Locking Pheonix connector
    [1786840.stp, 1787027.stp, pxc_1790302.stp]
2022-04-18 Added 60s Non locking
    [pxc_1790111.stp]
2022-04-18 Added molex 2pos connector
    [430250208.stp, 430450201.stp]
2022-07-21 New comps
    [B02SVFN-RC.STEP, CUI_V7803-1000-SMT.step, CUI_V78E05-500-SMT.step, Cap=12_5-14.step, HVSON-8.STEP, HVSON8_3x3x0_85 pitch 0_5mm.STEP, Keystone 5006 black.STEP, Keystop 5009 Yellow.STEP]
2022-07-26 Updated TJA1042 Device Packages
    [SO8 SOT96-1.step]
2022-07-26 Adde QFN-24 with pad
    [QFN 24 4x4.step]
2022-07-30 Moved pin 9 on grid
2022-11-03 Added Vicor Mini DC-DC base and 24v
    [Vicor-mini.STP]
2022-11-04 Added Conec db25
    [15-006463.stp]
2022-11-04 Added conntectors and DC-DC
    [VICOR_3623_dcm_thruhole.STEP, te-1757827-3.stp]
2022-11-20 New parts Nov 20, 2022
    [pxc_1935174_05.stp]
2022-11-21 Added 485 Parts
    [SN65HVD72DRBR.STEP]
2022-11-23 Added IC sot-23-6 model
    [sot-23-6.stp]
2022-11-23 Adjusted silkscreen for clarity
2022-11-23 Added footprint
2022-11-23 Add Abracon ABM3B Base and 12Mhz
    [ABM3B.STEP]
2022-11-24 Added MPS MPL-AL5050-100
    [MPL-AL5050-xxx.STEP]
2022-11-24 Added Diodes Inc AP6230x Series DC-DC
2022-11-24 Added Murata Inductors
    [1255AY.STEP]
2022-11-24 Started power mux
    [SOT-583.STEP, TPS2116DRLR.stp]
2022-11-25 Added JST SH 4 pos for STEMMA QT
    [JST-SH-4.STEP]
2022-11-25 Added SD Card Holders
    [MEM2061-01-188-00-A.stp, MEM2075-00-140-01-A.stp]
2022-11-28 Added Bourns PTC for USB
    [bourns-mf-psmf110x.stp]
2022-11-28 Updated RP2040 Definition
    [Raspberri_Pi_RP2040.step]
2022-11-28 Added a bunch of new items
    [KMR231GLFS.stp, KX7 SMD Quartz Crystal Resonator 3.2x2.5mm.step, PTS647SK38SMTR2LFS.stp, TDFN50P-3MMX3MM-10 v0.step, TL1015AF160QG--3DModel-STEP-520916.STEP, W25Q64JVXGIQ_TR.stp]
2022-12-02 Added molex used for 4 pin fans
    [molex-470531000.stp]
2022-12-02 added 2 bit bidirectional level shifter
    [msop-8.step]
2022-12-02 Added 5x2 Phoenixx connector
2022-12-02 Added vertical JST-4 / Added courtyard
    [BM04B-SRSS-TB.STEP]
2022-12-02 Added 1210 size capacitor
    [CAP1210.STEP]
2022-12-02 Added wurth 330nh 50a
    [HCM-1390_rev1.stp]
2022-12-02 added 1206 resistor
    [Resistor_1206.step]
2022-12-02 Removed Watt from symbol, now shows resistor size
2022-12-03 Added smaller resistor sizes
    [Resistor_0201.step, Resistor_0402.step]
2022-12-03 Added new capacitor size
    [ESK478M025AM2AA.step]
2022-12-03 New Inductors
    [FPT705.STEP, Murata LQH5BPN Inductor.STEP]
2022-12-03 Added 0402 capacitor
    [CAPC-0402.stp]
2023-01-15 Lots of stuff
    [171-025-113.STEP, ASE-xxxxMHZ-ET.STEP, RB1-125BAG1A.STEP, TSM-103-01-G-SV-P-TR.stp, WIZNET_W5500.step, cap-K21-V.stp, cap-K21.stp, pxc_1827907_08_MC-1-5-6-GF-3-81_3D.stp]
2023-01-16 Added Wurth 691210910002
    [wurth-691210910002.stp]
2023-01-16 Added Wurth 691210910003
    [wurth-691210910003.stp]
2023-02-14 Updated footprints
2023-05-15 new jst connectors for dynamixel
    [B4B-EH-A.STEP, JST-B4B-EH-A.STEP, JST-S4B-EH.STEP]
2024-08-22 Added ST IMU with LGA-14L
    [LGA-14L v2.step]
2024-10-10 Added ST LGA-14L
    [LGA-14L.step]
2024-10-10 Add STM32 F466RE Symbol (unfinished)
2024-10-27 Added LTC4162-F
    [WFQFN-28-4x5.step]
2024-10-29 added STM32L4P5CGT6
2024-10-29 added 2x20 female headers
    [BCS-120-F-D-TE.stp, SSM-120-L-DV-LC-M-TR.stp]
2024-10-29 Removed extra silkscreen
2024-10-29 Added Pin names to symbol
2024-11-18 Merged Chirs updates to main
    [8-UFDFN-exposed_pad.step, Kailh LP Choc Burnt Orange.STEP, cherry_mx_PCB.stp]
2024-11-20 Added wurth 7 segemnt display blue
    [wurth-157102B12800.stp]
2024-11-20 Added MAX6956
    [ssop28_5.3mm.step]
2025-06-15 Parts added
    [BNO0xx.STEP, QFN-24_3x3.STEP]
2025-06-26 So many comps
    [GCT-usb4145-03-0230-c.stp, IC-WQFN20-3mmx3mm Pad.step, LED-QBLP600_BI_TRI.step, UFDFPN8_DFN8_2X3_pad.step, VL53L5 Exclusion cones.step, VL53L5 Module.step, VL53L5.step, ic-ufdn 10 1x25.STEP]
2025-07-31 More stuffs
    [GCT-BD125-10-A-0305-0580-L-B.STEP]
