ericboxer/KiCad---BoxLib/(notices)

Notices in the files:
3D Models/MEM2075-00-140-01-A.stp:
author */ ('License CC BY-ND 4.0'),
3D Models/TSW-111-07-G-S.stp:
FILE_NAME( 'e:/temp/worker_233/temp/exporttempdir_3084_909_qwgB3/format_0/TSW-111-07-G-S.stp', '2022-03-25T17:56:25', ( 'License CC BY-ND 4.0' ), ( 'CADENAS' ), ' ', 'PARTsolutions', ' ' );
